CopperPilot/laptop/reference/README.md

# Reference

What the CopperPilot agents were given: the prompt in [prompt.md](prompt.md) and the photos below.

Reference photos of a commercial product, used here only for comparison. All rights belong to their owners; this project is not affiliated with or endorsed by the product's maker.

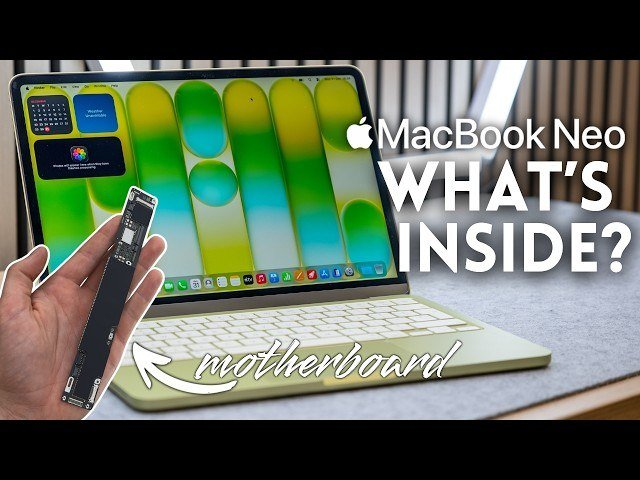
[picture p15: reference/photos/board_in_hand.jpg]
board_in_hand

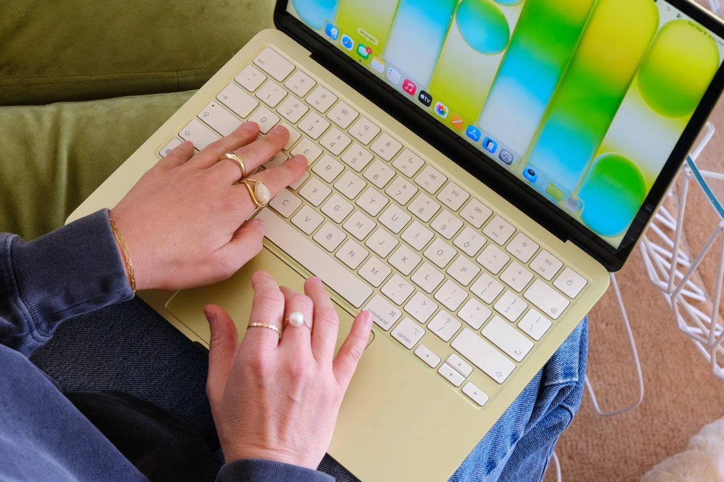
[picture p16: reference/photos/keyboard_top.jpg]
keyboard_top

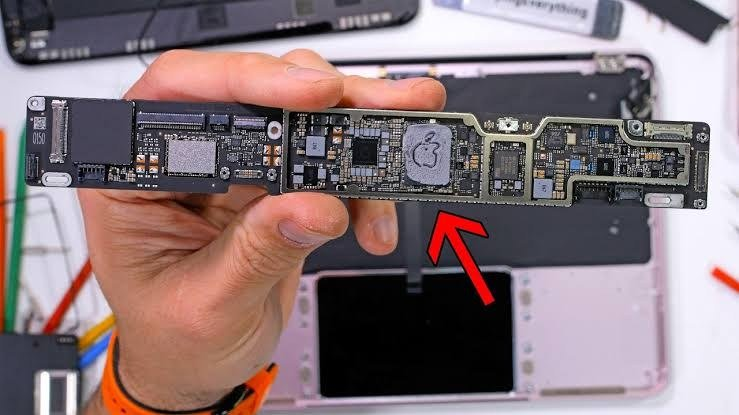
[picture p17: reference/photos/logic_board.jpg]
logic_board

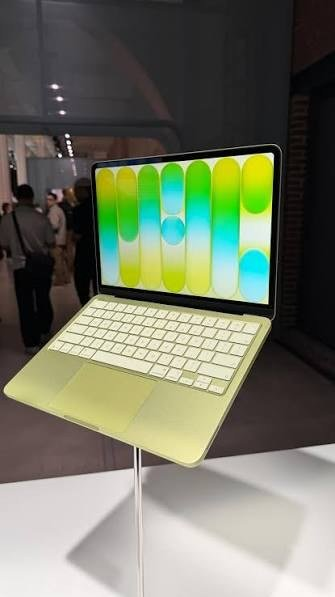
[picture p18: reference/photos/open_side.jpg]
open_side

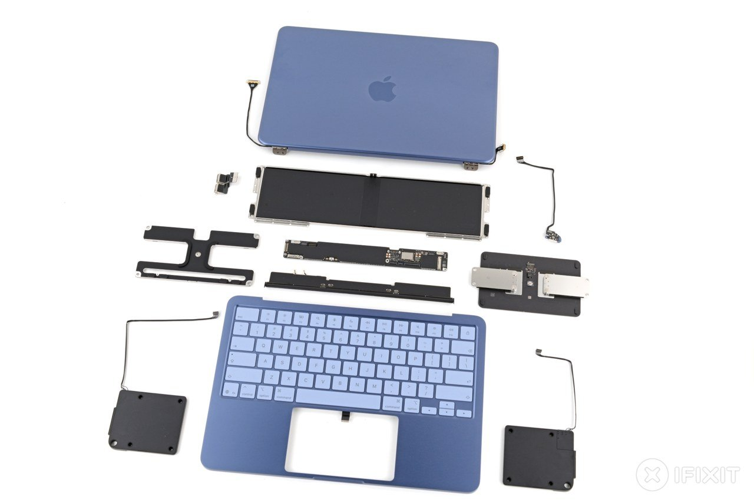
[picture p19: reference/photos/teardown_exploded.jpg]
teardown_exploded

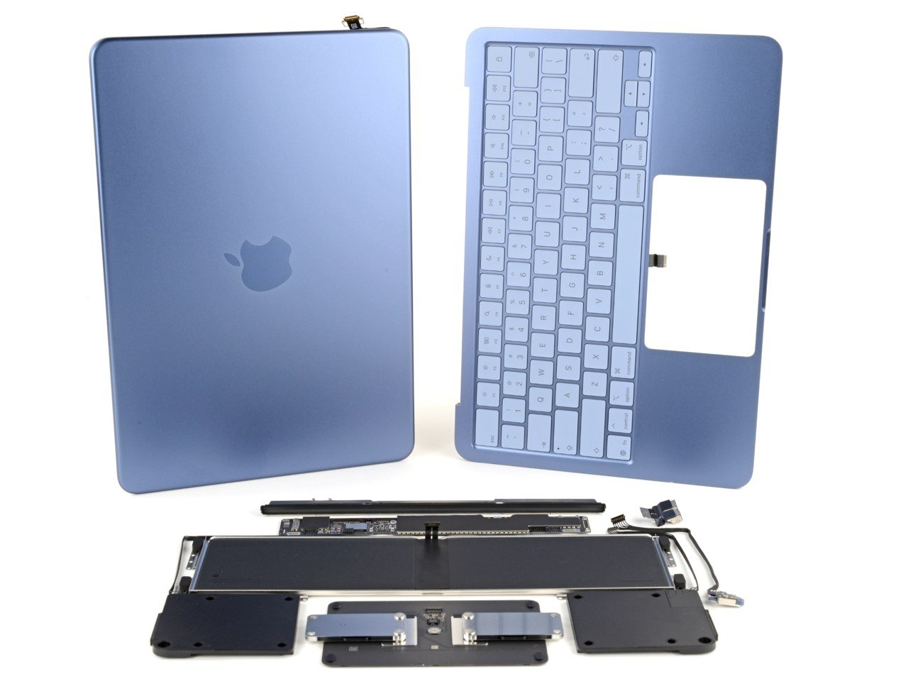
[picture p20: reference/photos/teardown_shells.jpg]
teardown_shells
