CopperPilot/laptop/reviews/judge.md

# Independent judge

A separate agent compares the renders of the finished design with the reference photos, without seeing the design files or the other agents' notes.

**Overall 8/10** · form 8 · features 9 · requirements 9 (pass mark 7).

## Differences from the reference

- Hinge area in the front view shows separate left/right torque hinge barrels and a central bezel cable cover with small gaps between them, whereas the reference uses a single full-width clutch cover.
- Bottom-right arrow keys on the 78-key keyboard use four full-height keys (L, U, D, R) rather than the reference keyboard's half-height up/down inverted-T arrow cluster.
- Top-bezel webcam window is rendered as a distinct rectangular module cutout rather than a flush glass camera hole.

## Requirements

| Id | Verdict | Note |
|---|---|---|
| R1 | met | CNC 6061-T6 aluminum top_deck, continuous bottom_shell (with internal blind pockets and no through-cutouts), and continuous lid_shell (with internal blind magnet pocket and no outer hole) match the 297.5 x 206.4 x 12.7 mm reference dimensions. |
| R2 | met | Main carrier PCB sits in the compact rear strip behind the keyboard and uses the real CM5_module.stl 3D model from rea-hw ref cm5. |
| R3 | met | Both left-edge USB-C ports and the right-edge 3.5mm TRRS jack face straight out through their enclosure openings in render-ports.png, with usb_left implementing the CH224A 20V 45-65W PD sink + AO4407A load switch on J2 and TPS25810RVCR 5V 1.5A DFP controller on J1 (single-sided top assembly over continuous GND planes), connected via 16P FFC and J4/J5 power harnesses to the main-board BQ25798RQMR 2S buck-boost charger and 6A +5V buck rail, and audio_right implementing the PJ-3701-SMT TRRS jack, ICS-40720 MEMS mic, TLV7041DBVR comparators, and TS5A23159DGSR mic mux. |
| R4 | met | Bought 270 x 104 mm 78-key scissor-switch keyboard module with readable legends on every key and 24-pin FPC tail to TCA8418RTWR, plus 120 x 76 mm multi-touch glass trackpad with 8-pin FPC tail, are properly mounted and cabled to the main carrier board. |
| R5 | met | Battery is rearranged as a single bought 2S2P pack (LP4466104-2S2P-9000MAH, 7.4V nominal, 6.0-8.4V, 9,000mAh / 66.6Wh) built from four identical LP4466104 pouch cells contoured around and under the trackpad (>85% floor coverage) with an integrated 2S protection/balance board, NTC, and one 9-pin JST-PH harness to J_BAT on the main board. |
| R6 | met | CM5 flashing and boot recovery use internal top-side pogo test pads TP1..TP6 and top-side nRPIBOOT switch SW1 with TPS2117DRLR + back-to-back AO4407A power muxing, keeping bottom_shell completely continuous with no service slot or through-cutouts. |
| R7 | met | Dual bought torque hinges articulate the lid 110 degrees open, lid_magnet sits in a blind internal pocket with an unperforated outer lid_shell, and display, backlight, and webcam cables route cleanly through the hinge barrel and internal bezel channels without looping outside the lid edge. |

## Features

| Id | Verdict | Note |
|---|---|---|
| F_DISPLAY | ok | 13-inch IPS display panel fills the thin lid bezel cleanly with proportions matching the reference laptop. |
| F_WEBCAM | ok | Centered top-bezel webcam window sits cleanly above the display in the front view and aligns with the internal camera module. |
| F_KEYBOARD | ok | 78-key scissor-switch keyboard sits recessed in the top deck well with readable printed legends on all keys. |
| F_TRACKPAD | ok | Large centered glass trackpad surface and front-edge thumb notch match the reference palmrest layout. |
| F_USBC_2 | ok | Rear-left USB-C port is centered in the left side opening with its oval mouth and tongue facing straight out. |
| F_USBC_1 | ok | Front-left USB-C PD charging port is centered in the left side opening with its oval mouth and tongue facing straight out. |
| F_AUDIO | ok | Right-edge 3.5mm TRRS headphone jack is centered in the right side opening with its circular bore facing straight out. |
| F_HALL | ok | Hall sensor U_HALL and lid_magnet align in the actuator view, with the magnet housed in a blind internal pocket leaving the outer lid skin continuous. |
