CopperPilot/laptop/docs/images/thumbnail.gif

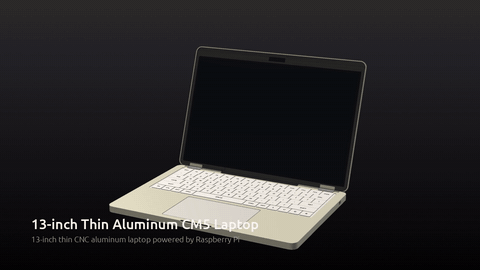
docs/images/thumbnail.gif
