CopperPilot/laptop/fab/thin-laptop-cm5-bom.csv

Comment | Designator | Footprint | LCSC Part #
10uF | C1,C3,C9,C19,C24,C35,C41,C43,C45,C47,C49,C65,C66,C67,C69,C71,C72,C73,C74,C75,C99 | C_0805_2012Metric | C440198
100nF | C2,C4,C10,C12,C16,C18,C23,C25,C36,C38,C42,C44,C46,C48,C50,C54,C59,C68,C76,C77,C80,C83,C87,C90,C91,C93,C95,C96,C97,C101 | C_0402_1005Metric | C307331
220nF | C21,C100 | C_0402_1005Metric | C16772
1uF | C11,C31,C32,C79 | C_0402_1005Metric | C52923
47nF | C7,C13 | C_0402_1005Metric | C880605
22uF | C5,C6,C14,C15,C55,C56,C64,C81,C82,C84,C85,C86 | C_0805_2012Metric | C45783
22pF | C17,C78 | C_0402_1005Metric | C1555
10uF | C20 | C_0603_1608Metric | C96446
1uF | C22 | C_0603_1608Metric | C23829972
1uF | C26,C27,C28,C37,C39,C40,C57,C58 | C_0603_1608Metric | C15849
100uF | C29,C30,C52,C53 | C_0805_2012Metric | C141660
2.2uF | C33,C34 | C_0402_1005Metric | C159814
4.7uF | C8,C51,C88 | C_0603_1608Metric | C19666
1nF | C60,C61,C62,C63 | C_0402_1005Metric | C1523
1nF | C70 | C_0402_1005Metric | C14442
470pF | C89 | C_0402_1005Metric | C1537
10nF | C92,C98 | C_0402_1005Metric | C15195
B16WS | D1 | SOD-323_L1.8-W1.3-LS2.5-RD | C364278
PESD5V0S1BA | D10,D11,D12,D13 | SOD-323_L1.7-W1.3-LS2.5-BI | C2827694
PESD3V3U1UA,115 | D5,D14,D20,D21,D22,D23,D31,D32,D40 | SOD-323_L1.7-W1.3-LS2.5-RD | C403915
BZT52C12 | D15 | SOD-123_L2.7-W1.6-LS3.7-RD | C173429
1N4148WS | D16,D37,D39 | SOD-323_L1.8-W1.3-LS2.5-RD | C2128
PSD05-LF-T7 | D2,D18 | SOD-323_L1.8-W1.3-LS2.5-RD | C139296
PESD5V0S1UA,115 | D4,D6,D9,D19 | SOD-323_L1.8-W1.3-LS2.5-RD | C179414
SMF12A | D24 | SOD-123F_L2.8-W1.8-LS3.7-RD | C123800
PESD3V3L5UY | D25,D26,D27,D28,D29,D30,D33,D34 | SOT-363_L2.0-W1.3-P0.65-LS2.1-BL | C2831531
TSD05CDYFR | D3 | SOD-323_L1.8-W1.3-LS2.5-BI | C20611048
ESTVS3300DRVR | D35 | DFN-6_L2.0-W2.0-P0.65-BL-EP1.6 | C42400190
PESD36VS1UJX | D36 | SOD-323F_L1.7-W1.3-LS2.5-RD | C5205187
BZT52C5V1S | D38 | SOD-323_L1.8-W1.3-LS2.5-RD | C173436
ESTVS2200DRVR | D7 | DFN-6_L2.0-W2.0-P0.65-BL-EP1.6 | C42400188
8A | F1 | F1206 | C136353
1A | F6 | F0603 | C163118
BLM18PG121SN1D | FB1,FB2,FB3,FB4,FB5 | L0603 | C14709
SM06B-SRSS-TB(LF)(SN) | J4 | CONN-SMD_SM06B-SRSS-TB-LF-SN | C160405
SM10B-SRSS-TB(LF)(SN) | J5 | CONN-SMD_10P-P1.00_SM10B-SRSS-TB-LF-SN | C160409
FPC-05F-8PH20 | J_AUDR,J_TP | FPC-SMD_8P-P0.50_FPC-05F-8PH20 | C2856797
S9B-PH-SM4-TB(LF)(SN) | J_BAT | CONN-SMD_9P-P2.50_S9B-PH-SM4-TB | C495694
S2B-PH-SM4-TB(LF)(SN) | J_BL,J_SPKL,J_SPKR | CONN-SMD_P2.00_S2B-PH-SM4-TB-LF-SN | C295747
FH12-22S-0.5SH(55) | J_CSI,J_DSI | FPC-SMD_22P-P0.50_FH12-22S-0.5SH-55 | C597981
05A20L24P | J_KB | FPC-SMD_24P-P0.50_05A20L24P | C5362158
05B20U16P | J_USBL | FPC-SMD_16P-P0.50_05B20U16P | C18164516
2.2uH | L1,L2,L5 | IND-SMD_L7.0-W6.6 | C167218
10uH | L3 | IND-SMD_L4.0-W4.0_LQH44PN2R2MP0L | C135263
2.2uH | L4 | IND-SMD_L4.5-W4.1_TMPC0412HP | C357134
AO4407A | Q1,Q2 | SOP-8_L5.0-W4.0-P1.27-LS6.0-BL | C2841482
SQ2318AES-T1_BE3 | Q3,Q4 | SOT-23-3_L2.9-W1.3-P1.90-LS2.4-BR | C3280170
BSS138 | Q5,Q6,Q_CAM,Q_I2C1,Q_I2C2,Q_TP1,Q_TP2 | SOT-23-3_L2.9-W1.6-P1.90-LS2.8-BR | C52895
AO3401A | Q_BL | SOT-23_L2.9-W1.3-P1.90-LS2.4-BR | C15127
2N7002 | Q_BL_EN,Q_DBG | SOT-23-3_L2.9-W1.3-P1.90-LS2.4-BR | C8545
10k | R1,R2,R3,R4,R6,R13,R14,R15,R16,R17,R18,R19,R20,R21,R26,R37,R48,R54,R55,R56,R58,R59,R71,R75,R76,R77,R78,R79,R91,R93,R95 | R_0402_1005Metric | C25744
2.2k | R9,R10,R82,R83 | R_0402_1005Metric | C25879
8.2k | R22 | R_0603_1608Metric | C25981
5.23k | R23 | R_0402_1005Metric | C11631
137k | R27 | R_0402_1005Metric | C32298
24k | R28,R65 | R_0402_1005Metric | C25769
78.7k | R29 | R_0402_1005Metric | C2998104
100k | R8,R30,R35,R45,R46,R63,R66,R67,R80,R96,R97 | R_0402_1005Metric | C25741
3.6k | R31 | R_0402_1005Metric | C25891
1.5R | R32 | R_0603_1608Metric | C22769
82k | R33 | R_0402_1005Metric | C4142
5.1k | R34 | R_0402_1005Metric | C25905
22R | R36,R53 | R_0402_1005Metric | C25092
30.1k | R42 | R_0402_1005Metric | C29402
45.3k | R47 | R_0402_1005Metric | C26980
4.7R | R49 | R_0402_1005Metric | C25121
100R | R50,R69,R87 | R_0402_1005Metric | C25076
47k | R51,R52,R68,R90 | R_0402_1005Metric | C25792
2.2R | R60 | R_0603_1608Metric | C22939
10R | R61,R62,R74 | R_0402_1005Metric | C25077
133k | R64 | R_0402_1005Metric | C25753
30k | R7 | R_0402_1005Metric | C25776
150k | R72,R73 | R_0402_1005Metric | C25755
1M | R81 | R_0402_1005Metric | C26083
1k | R84 | R_0402_1005Metric | C11702
80.6k | R88 | R_0402_1005Metric | C25921
4.7k | R89 | R_0402_1005Metric | C25900
22k | R94 | R_0402_1005Metric | C25768
PTS526SM15SMTR2LFS | SW1 | SW-SMD_4P-L5.2-W5.2-P3.70-LS6.4 | C2689538
ComputeModule5-CM5 | U1 | Raspberry-Pi-5-Compute-Module | C597931
TLV62569DBVR | U_3V3 | SOT-23-5_L3.0-W1.7-P0.95-LS2.8-BR | C141836
PAM8406DR | U_AMP | SOIC-16_L9.9-W3.9-P1.27-LS6.0-BL | C86270
TPS61165DBVR | U_BL | SOT-23-6_L2.9-W1.6-P0.95-LS2.8-BR | C58756
TPS56628DDAR | U_BUCK,U_BUCK2 | SOIC-8_L4.9-W3.9-P1.27-LS6.0-BL-EP | C485522
BQ25798RQMR | U_CHG | QFN-29_L4.0-W4.0-P0.40-TL-BQ25792RQMR | C2876593
ES8388 | U_CODEC | QFN-28_L4.0-W4.0-P0.45-BL-EP | C365736
TPS2117DRLR | U_DBG | SOT-583-8_L2.1-W1.2-P0.50-LS1.6-BL | C22399676
USBLC6-2SC6 | U_ESD,U_ESD1,U_ESD2 | SOT-23-6_L2.9-W1.6-P0.95-LS2.8-BL | C2687116
DRV5032FADBZR | U_HALL | SOT-23-3_L2.9-W1.3-P0.95-LS2.4-BR | C140921
TCA8418RTWR | U_KB | WQFN-24_L4.0-W4.0-P0.50-TL-EP2.5 | C138713
HT7530S | U_RTC | SOT-23-3_L3.0-W1.7-P0.95-LS2.9-BR | C347214
TPS3700DDCR | U_UVLO | SOT-23-6_L2.9-W1.6-P0.95-LS2.8-BL | C33002
SY6280AAC | U_VBUS | SOT-23-5_L3.0-W1.7-P0.95-LS2.8-BL | C55136
