CopperPilot/laptop/fab/usb_left/thin-laptop-cm5-usb_left-bom.csv

Comment | Designator | Footprint | LCSC Part #
150uF | C1 | CAP-SMD_L6.0-W3.2 | C600588
100nF | C2,C4,C8,C9,C10,C11,C13,C16 | C_0402_1005Metric | C307331
1uF | C5,C6,C7,C12,C14 | C_0603_1608Metric | C15849
10uF | C3,C15,C19 | C_0805_2012Metric | C440198
10nF | C17 | C_0402_1005Metric | C15195
1N4148WS | D3,D10,D11 | SOD-323_L1.8-W1.3-LS2.5-RD | C2128
TSD05CDYFR | D4,D5 | SOD-323_L1.8-W1.3-LS2.5-BI | C20611048
ESTVS2200DRVR | D6,D7 | DFN-6_L2.0-W2.0-P0.65-BL-EP1.6 | C42400188
BZT52C24 | D8 | SOD-123_L2.7-W1.6-LS3.7-RD | C173422
BZT52C12 | D9 | SOD-123_L2.7-W1.6-LS3.7-RD | C173429
TYPE-C-31-M-12 | J1,J2 | USB-C_SMD-TYPE-C-31-M-12_1 | C165948
FPC-05F-16PH20 | J3 | FPC-SMD_16P-P0.50_FPC-05F-16PH20 | C2856801
SM06B-SRSS-TB(LF)(SN) | J4 | CONN-SMD_SM06B-SRSS-TB-LF-SN | C160405
SM10B-SRSS-TB(LF)(SN) | J5 | CONN-SMD_10P-P1.00_SM10B-SRSS-TB-LF-SN | C160409
AO4407A | Q1,Q2 | SOP-8_L5.0-W4.0-P1.27-LS6.0-BL | C2841482
2N7002 | Q3,Q4,Q5,Q6,Q7 | SOT-23-3_L2.9-W1.3-P1.90-LS2.4-BR | C8545
100k | R1,R8,R23,R24 | R_0402_1005Metric | C25741
120k | R11 | R_0402_1005Metric | C25750
470R | R12 | R_0603_1608Metric | C23179
10k | R2,R13,R14 | R_0603_1608Metric | C25804
47k | R15 | R_0402_1005Metric | C25792
1k | R16,R17,R18,R19,R20,R21,R22 | R_0402_1005Metric | C11702
0R | R3 | R_0603_1608Metric | C21189
10k | R5,R6 | R_0402_1005Metric | C25744
CH224A | U1 | ESSOP-10_L4.9-W3.9-P1.0-LS6.0-TL-EP | C42459160
TPS25810RVCR | U2 | WQFN-20_L4.0-W3.0-P0.50-BL-EP | C473913
TPD6S300RUKR | U3,U5 | WQFN-20_L3.0-W3.0-P0.40-BL-EP1.7 | C2649810
XC6216B332MR-G | U4 | SOT-23-5_L3.0-W1.6-P0.95-LS2.8-BR | C2891269
XC6206P332MR-G | U6 | SOT-23-3_L2.9-W1.6-P1.90-LS2.8-BR | C5446
