CopperPilot/laptop/case/out/bottom_shell.stl

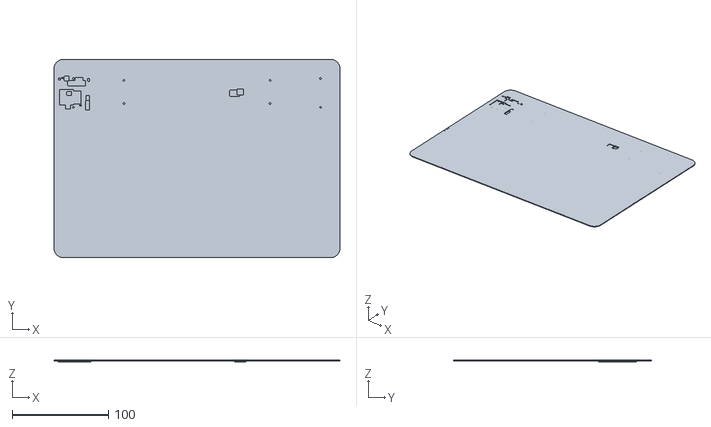
[picture p22: CAD file, 2026-11-02]
case/out/bottom_shell.stl
297.5 x 206.4 x 1.92
