CopperPilot/laptop/fab/audio_right/thin-laptop-cm5-audio_right.step

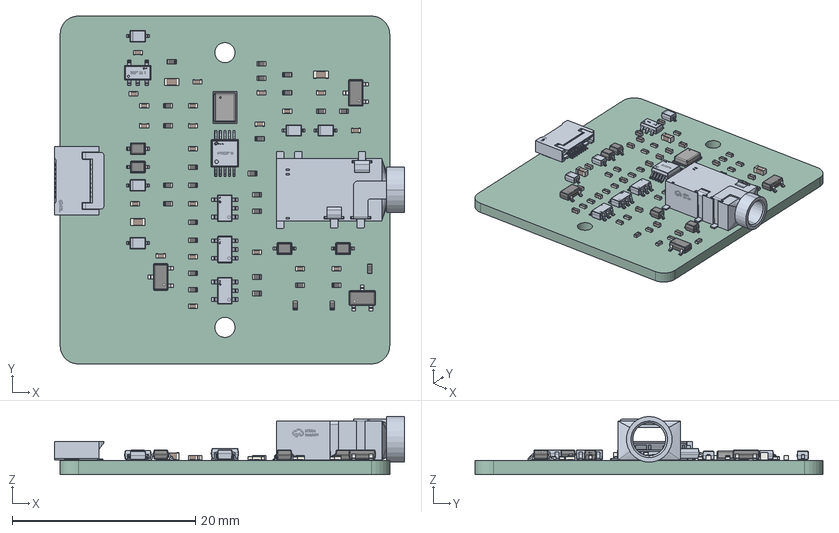
[picture p23: CAD file, 2026-11-06]
fab/audio_right/thin-laptop-cm5-audio_right.step
38.3 x 38.0 x 6.35 mm
R_0402_1005Metric x 28
C_0402_1005Metric x 21
SOT-23-3L_L2.9-W1.6-H1.1-LS2.8-P0.95 x 3
InvenSense_ICS-43434-6_3.5x2.65mm
C_0603_1608Metric x 3
SOD-323_L1.7-W1.3-LS2.5-BI x 4
thin-laptop-cm5-audio_right_PCB
