CopperPilot/laptop/fab/mech/lid_shell.step

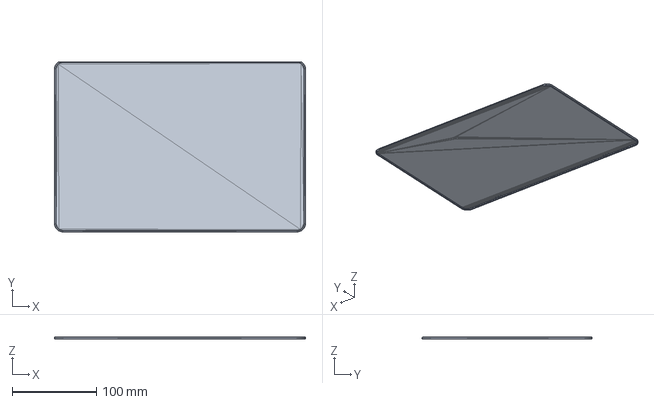
[picture p24: CAD file, 2026-11-06]
fab/mech/lid_shell.step
297.5 x 201.2 x 2.84 mm
