CopperPilot/laptop/fab/thin-laptop-cm5.step

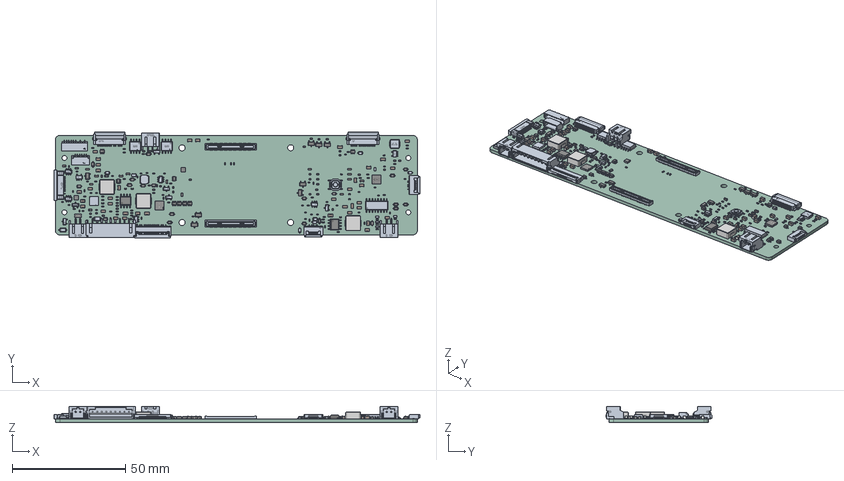
[picture p25: CAD file, 2026-11-06]
fab/thin-laptop-cm5.step
161.7 x 46.9 x 7.20 mm
C_0805_2012Metric x 37
R_0402_1005Metric x 84
C_0402_1005Metric x 50
零件46 x 8
零件2 x 5
SOD-323_L1.7-W1.3-LS2.5-BI x 10
C_0603_1608Metric x 13
10164227-1001A1RLF x 2
R_0603_1608Metric x 3
SOD-323_L1.8-W1.3-LS2.5-BI x 5
IND-SMD_L7.0-W6.6-H3.0 x 3
F1206_L3.2-W1.7-H0.6
SOT-23-3L_L2.9-W1.6-H1.1-LS2.8-P0.95 x 8
QFN-28_L4.0-W4.0-H0.8-P0.45
DFN-6_L2.0-W2.0-P0.65-BL-EP1.6 x 2
WQFN-24_L4.0-W4.0-H0.8-P0.50
零件39 x 2
F0603_L1.7-W0.9-H0.7
thin-laptop-cm5_PCB
