CopperPilot/laptop/fab/usb_left/thin-laptop-cm5-usb_left.step

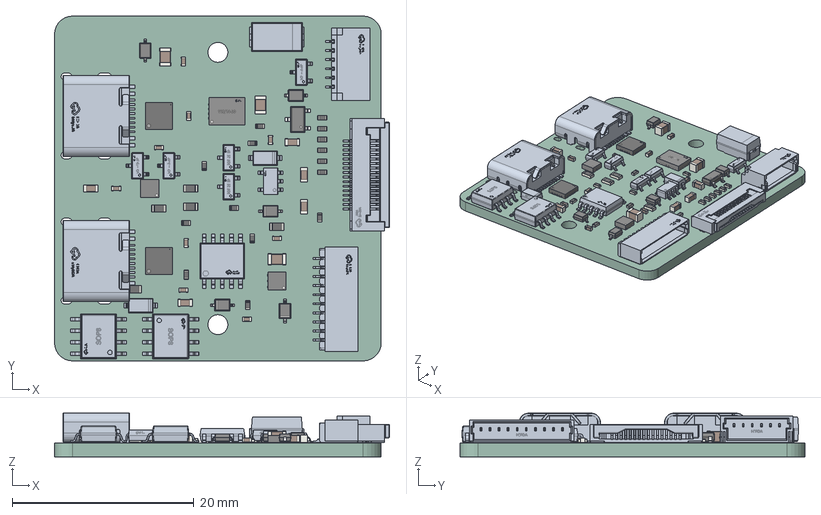
[picture p26: CAD file, 2026-11-06]
fab/usb_left/thin-laptop-cm5-usb_left.step
36.9 x 38.0 x 4.82 mm
SOD-323_L1.8-W1.3-LS2.5-BI x 2
C_0402_1005Metric x 9
R_0402_1005Metric x 15
SOT-23-3L_L2.9-W1.6-H1.1-LS2.8-P0.95
零件2 x 3
R_0603_1608Metric x 5
C_0603_1608Metric x 5
C_0805_2012Metric x 3
WQFN-20_L3.0-W3.0-H0.8-P0.40-TL-EP1.7 x 2
DFN-6_L2.0-W2.0-P0.65-BL-EP1.6 x 2
WQFN-20_L4.0-W3.0-H0.8-P0.50
thin-laptop-cm5-usb_left_PCB
