CopperPilot/laptop/case/out/lid_magnet.stl

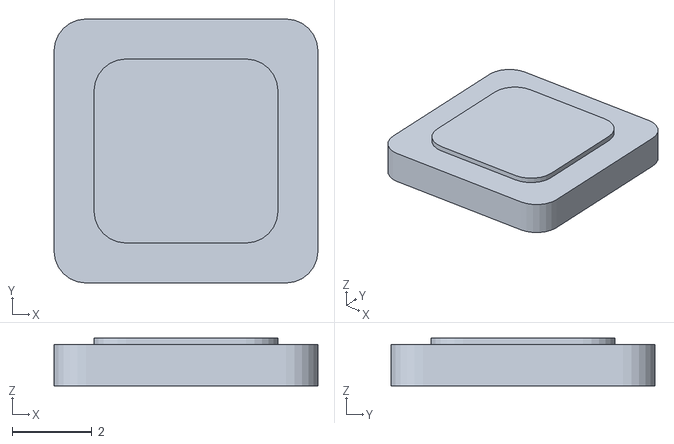
[picture p27: CAD file, 2026-11-02]
case/out/lid_magnet.stl
6.60 x 6.60 x 1.19
