CopperPilot/laptop/case/out/top_deck.stl

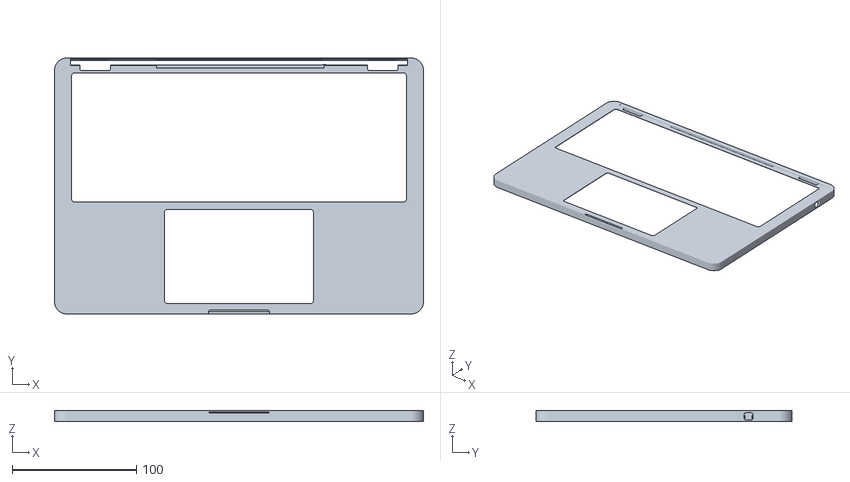
[picture p28: CAD file, 2026-11-02]
case/out/top_deck.stl
297.5 x 206.4 x 8.48
