CopperPilot/laptop/case/out/display_bezel.stl

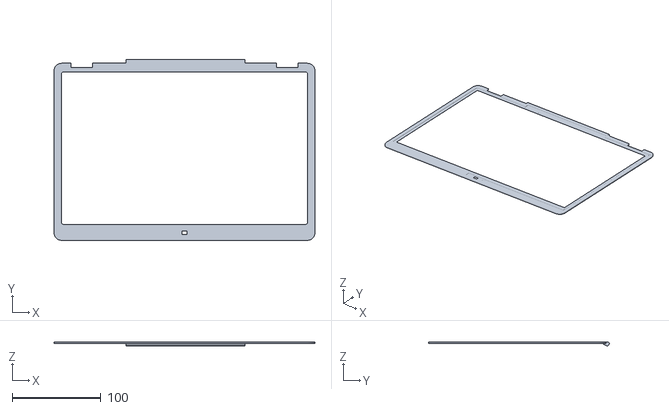
[picture p29: CAD file, 2026-11-02]
case/out/display_bezel.stl
294.5 x 203.8 x 4.18
