CopperPilot/laptop/case/purchased/cm5_module.stl

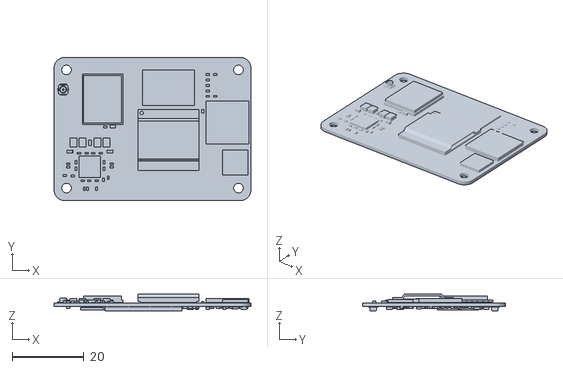
[picture p30: CAD file, 2026-11-06]
case/purchased/cm5_module.stl
55.0 x 40.0 x 4.62
