CopperPilot/laptop/case/purchased/hinge_left.stl

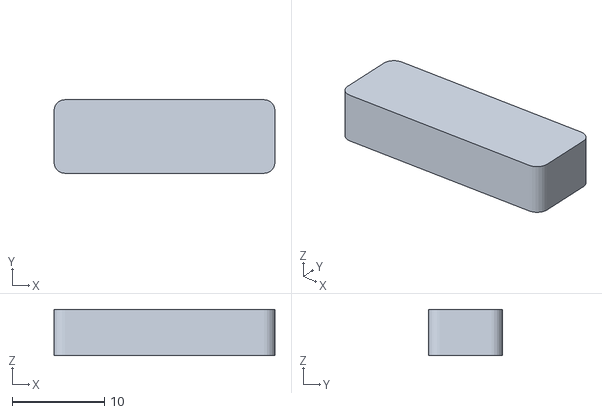
[picture p31: CAD file, 2026-11-02]
case/purchased/hinge_left.stl
24.0 x 8.00 x 5.00
