CopperPilot/laptop/case/purchased/speaker_left.stl

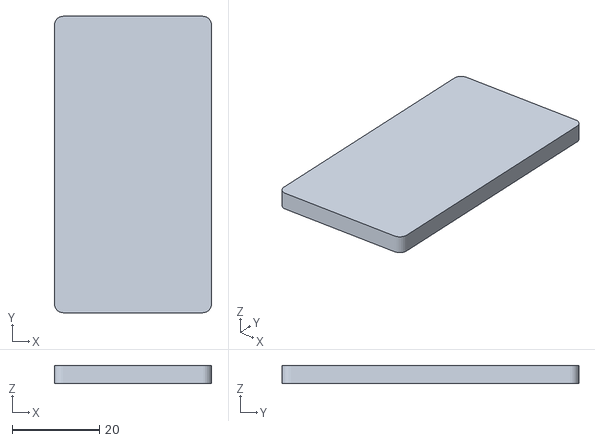
[picture p32: CAD file, 2026-11-02]
case/purchased/speaker_left.stl
36.0 x 68.0 x 4.20
