CopperPilot/laptop/case/purchased/display_panel.stl

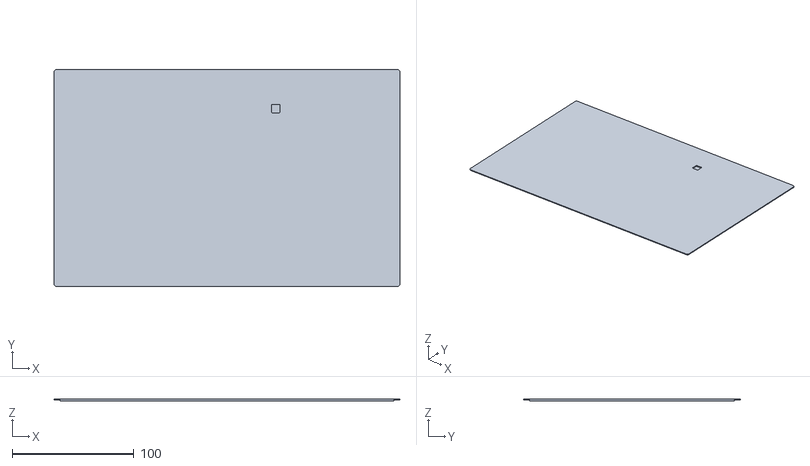
[picture p33: CAD file, 2026-11-02]
case/purchased/display_panel.stl
284.0 x 178.0 x 1.50
