CopperPilot/laptop/(list of files, cad)

Other CAD files:
fab/mech/lid_magnet.step
fab/mech/top_deck.step
fab/mech/bottom_shell.step
case/out/lid_shell.stl
case/purchased/hinge_right.stl
case/purchased/battery_pack.stl
case/purchased/keyboard_module.stl
case/purchased/keyboard_module_legends.stl
case/purchased/speaker_right.stl
case/purchased/trackpad_module.stl
case/purchased/webcam_module.stl
fab/mech/lid_shell.stl
