CopperPilot/laptop/fab/thin-laptop-cm5-schematic.pdf

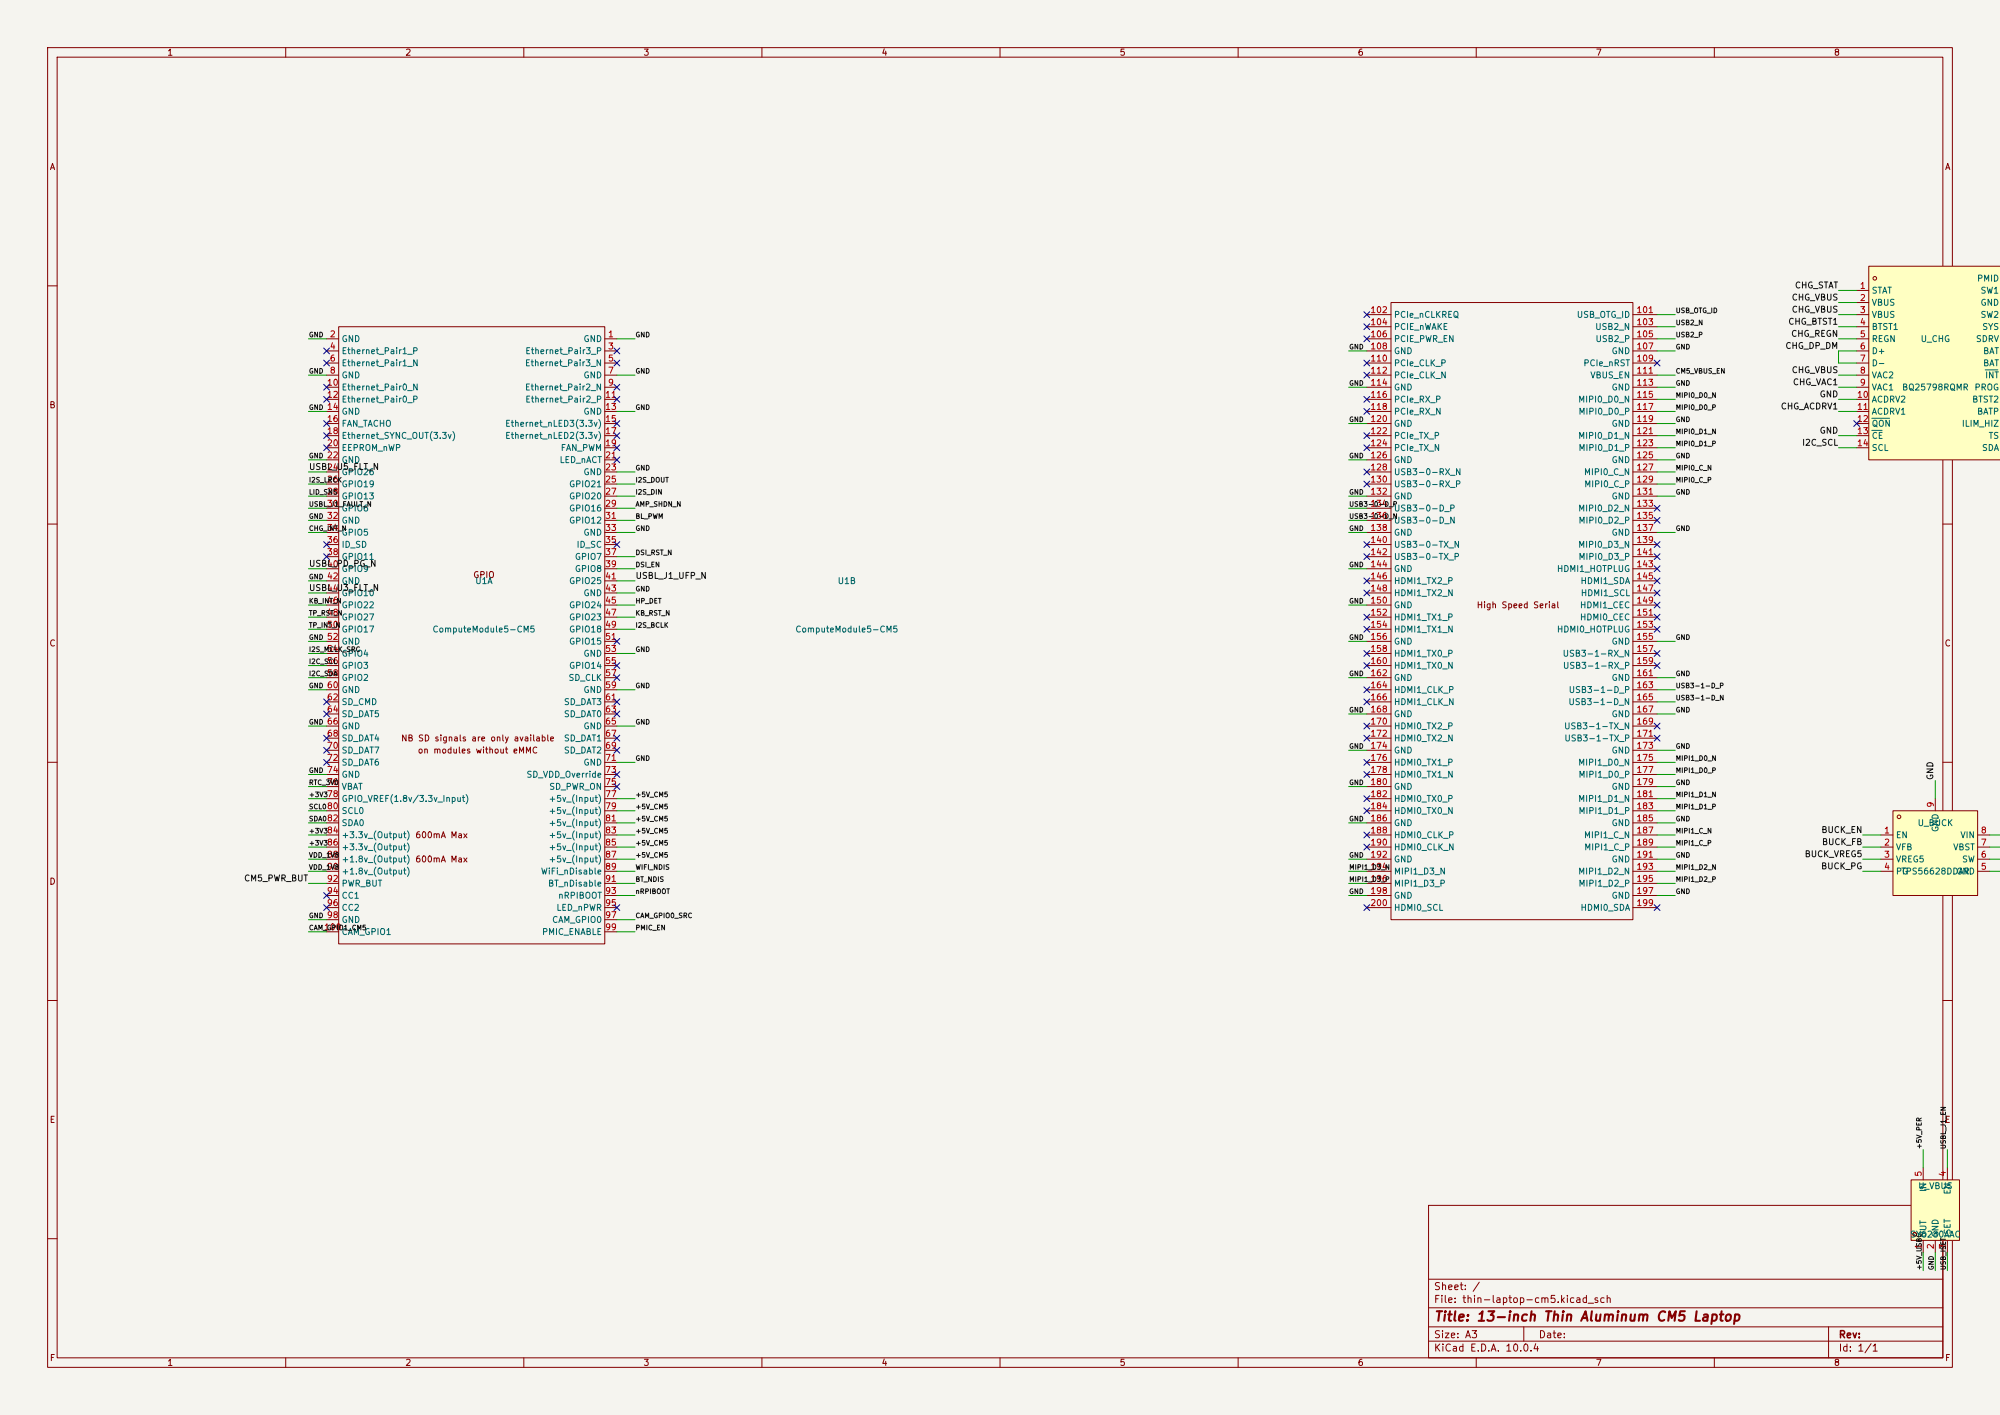
[picture p34: page 1]

600mA Max 600mA Max NB SD signals are only available on modules without eMMC

Sheet: /
File: thin-laptop-cm5.kicad_sch
Title: 13-inch Thin Aluminum CM5 Laptop

Size: A3 | Rev:
KiCad E.D.A. 10.0.4 | Id: 1/1
