CopperPilot/laptop/fab/audio_right/thin-laptop-cm5-audio_right-schematic.pdf

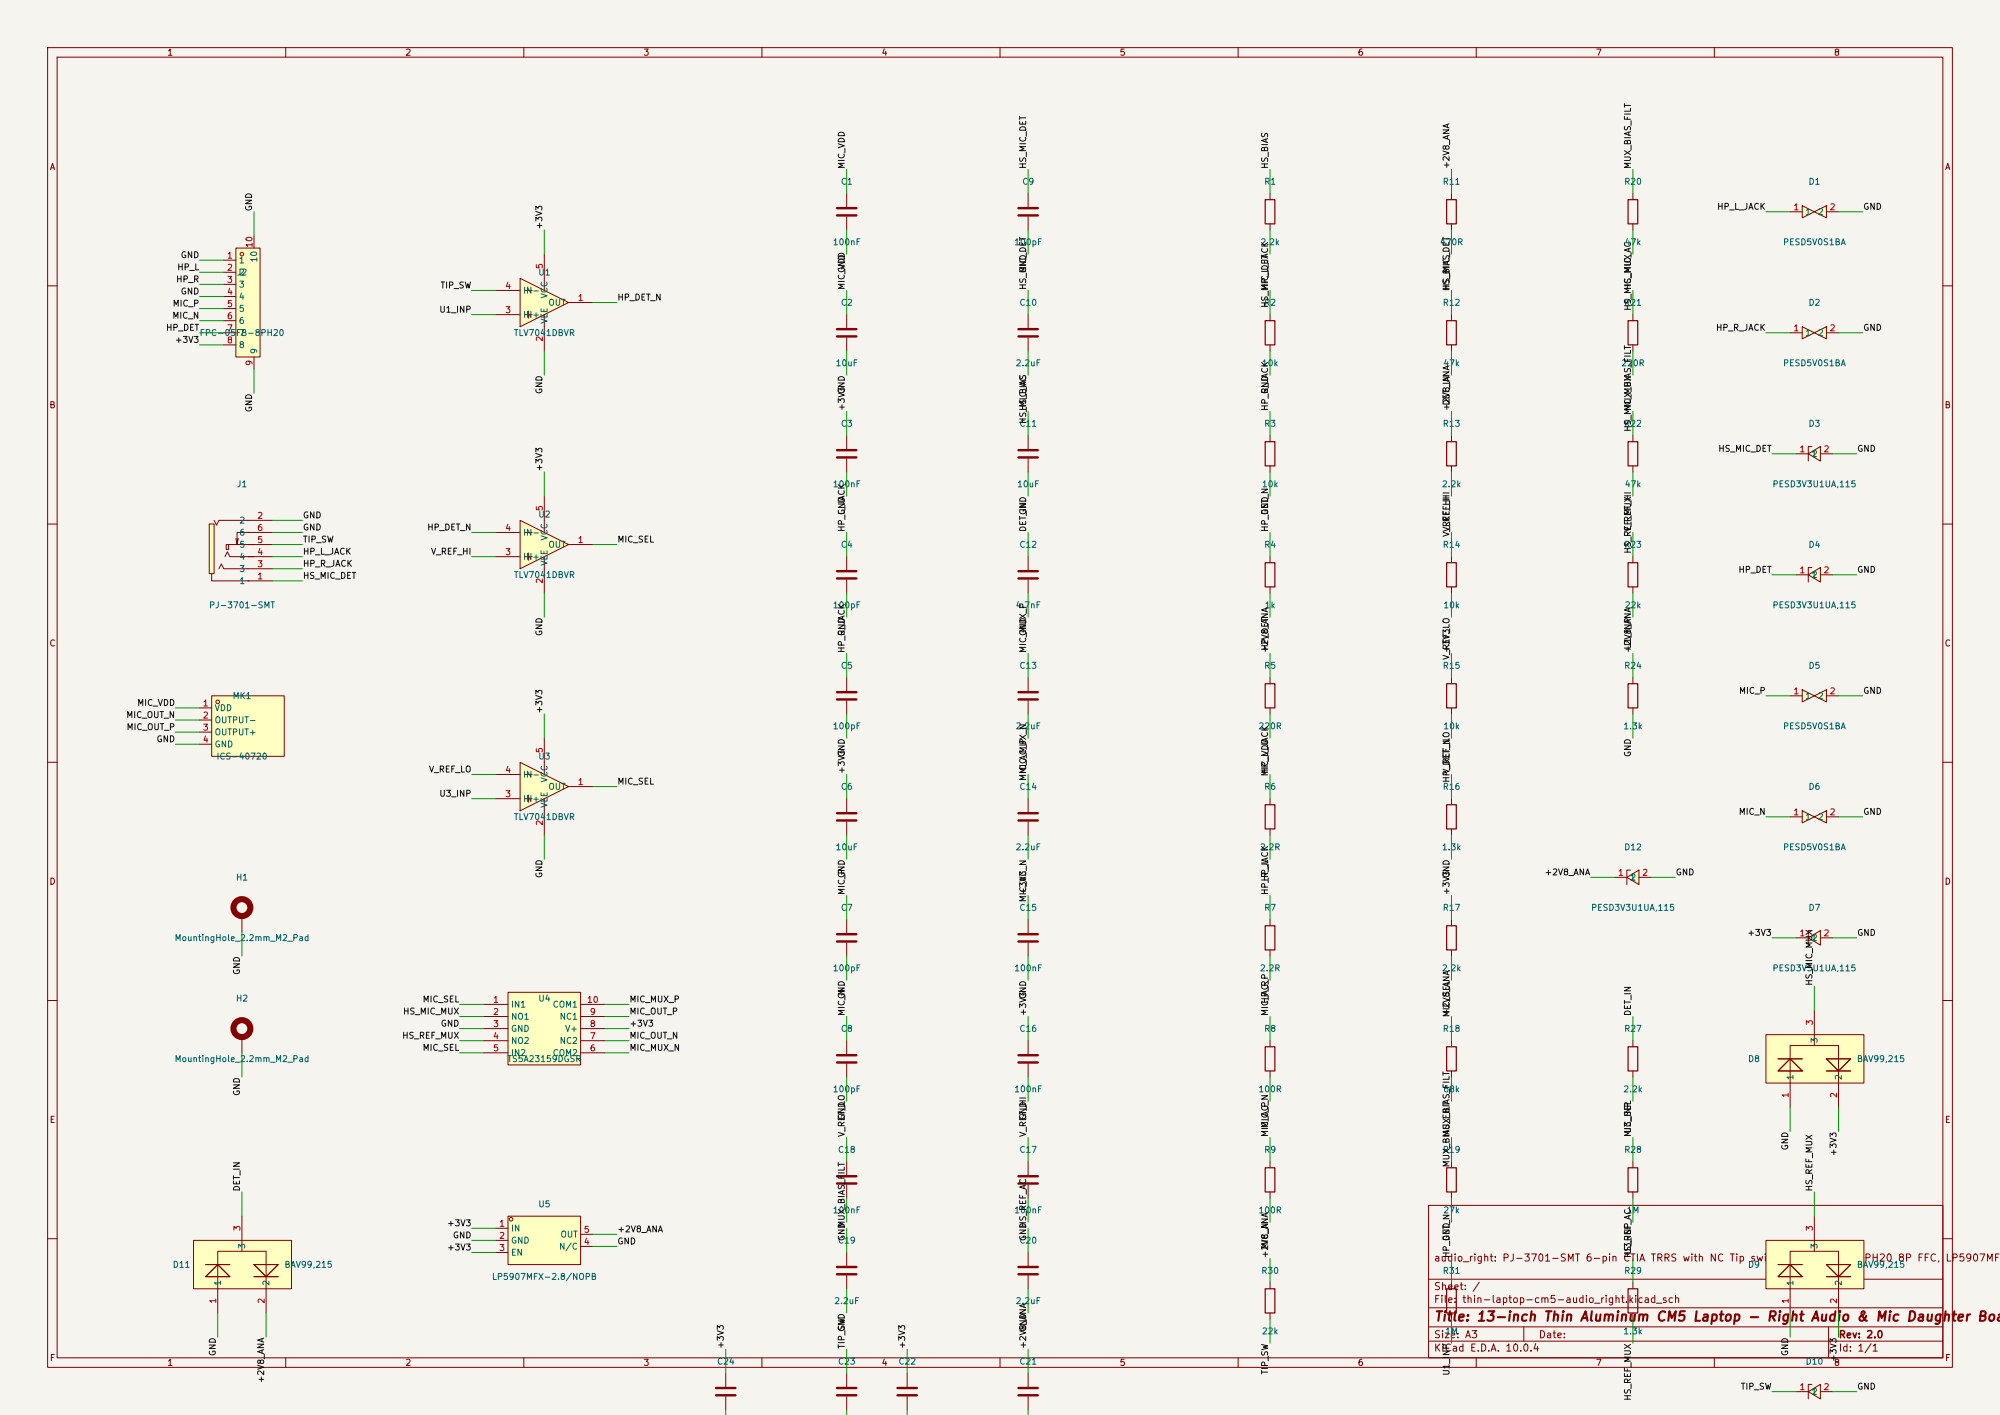
[picture p35: page 1]

Sheet: /
Title: 13-inch Thin Aluminum CM5 Laptop - Right Audio & Mic Daughter Board

1M Size: A3 | 1.3k | | Rev: 2.0
KiCad E.D.A. 10.0.4 | | Id: 1/1
