CopperPilot/laptop/fab/usb_left/thin-laptop-cm5-usb_left-schematic.pdf

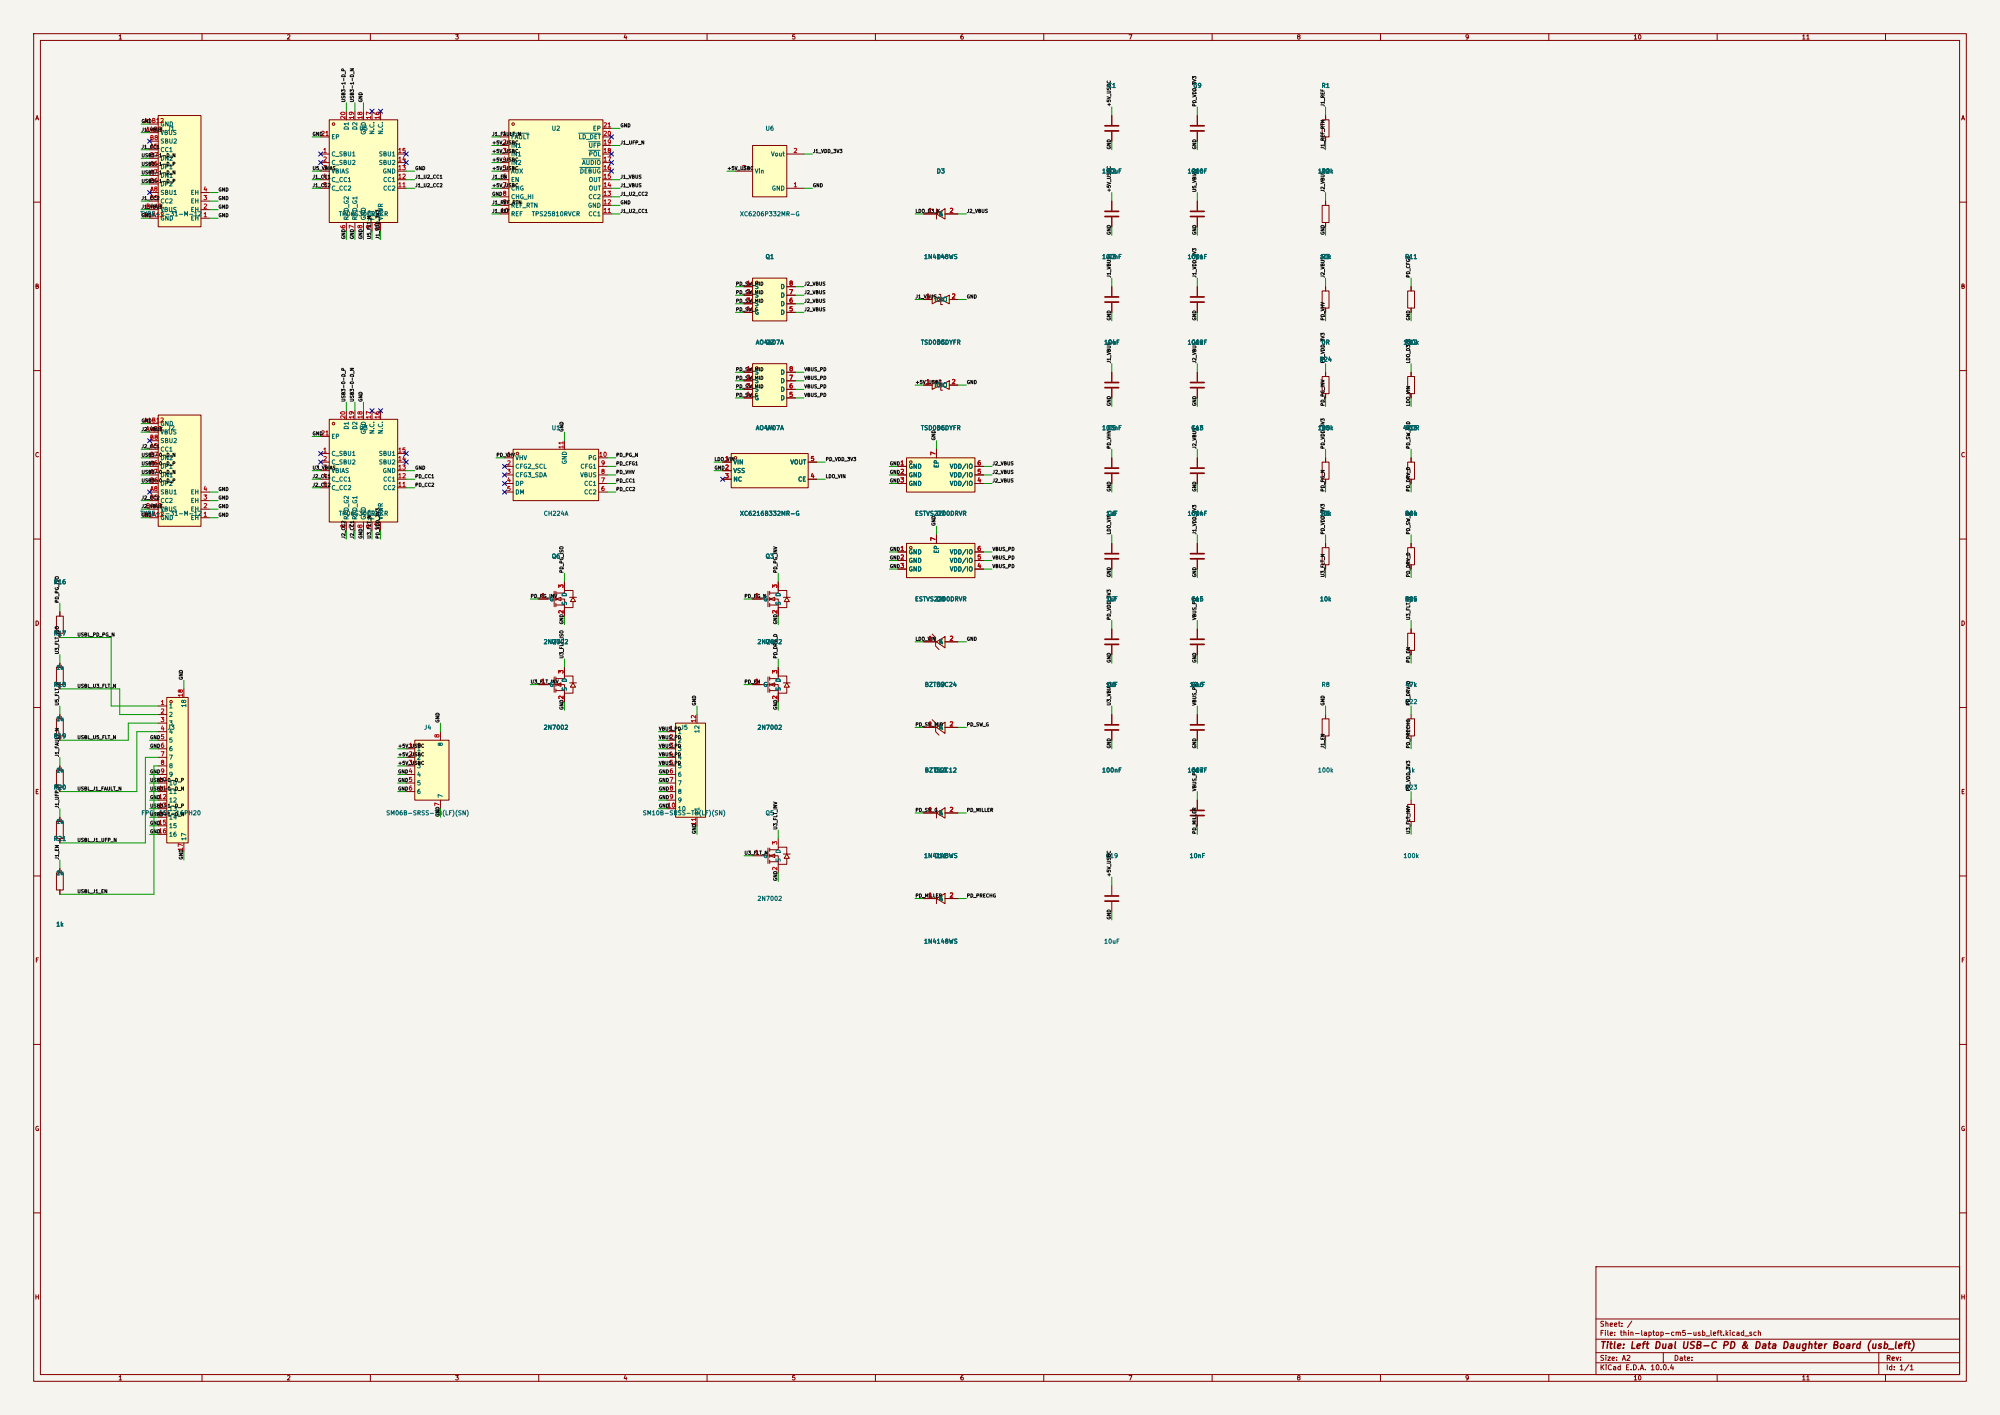
[picture p36: page 1]

SM06B-SRSS-TB(LF)(SN)

Sheet: /
File: thin-laptop-cm5-usb_left.kicad_sch
Title: Left Dual USB-C PD & Data Daughter Board (usb_left)

Size: A2 | Rev:
KiCad E.D.A. 10.0.4 | Id: 1/1
