CopperPilot/laptop/hardware/thin-laptop-cm5.kicad_pcb

## KiCad design hardware/thin-laptop-cm5.kicad_pcb (2026-11-06)

Schematic: thin-laptop-cm5.kicad_sch, 13-inch Thin Aluminum CM5 Laptop

Parts:
C1, C3, C9, C19, C24, C35, C41, C43, C45, C47, C49, C65, C66, C67, C69, C71, C72, C73, C74, C75, C99: 10uF; C_0805_2012Metric; LCSC C440198
C2, C4, C10, C12, C16, C18, C23, C25, C36, C38, C42, C44, C46, C48, C50, C54, C59, C68, C76, C77, C80, C83, C87, C90, C91, C93, C96, C101: 100nF; C_0402_1005Metric; LCSC C307331
C5, C6, C14, C15, C55, C56, C64, C81, C82, C84, C85, C86: 22uF; C_0805_2012Metric; LCSC C45783
C7, C13: 47nF; C_0402_1005Metric; LCSC C880605
C8, C51, C88: 4.7uF; C_0603_1608Metric; LCSC C19666
C11, C31, C32, C79: 1uF; C_0402_1005Metric; LCSC C52923
C17, C78: 22pF; C_0402_1005Metric; LCSC C1555
C20: 10uF; C_0603_1608Metric; LCSC C96446
C21: 220nF; C_0402_1005Metric; LCSC C16772
C22: 1uF; C_0603_1608Metric; LCSC C23829972
C26, C27, C28, C37, C39, C40, C57, C58: 1uF; C_0603_1608Metric; LCSC C15849
C29, C30, C52, C53: 100uF; C_0805_2012Metric; LCSC C141660
C33, C34: 2.2uF; C_0402_1005Metric; LCSC C159814
C60, C61, C62, C63: 1nF; C_0402_1005Metric; LCSC C1523
C70: 1nF; C_0402_1005Metric; LCSC C14442
C89: 470pF; C_0402_1005Metric; LCSC C1537
C92: 10nF; C_0402_1005Metric; LCSC C15195
C95, C97: 100nF; C_0402_1005Metric; MPN CC0402KRX7R9BB104; LCSC C307331
C98: 10nF; C_0402_1005Metric; MPN CL05B103KB5NNNC; LCSC C15195
C100: 220nF; C_0402_1005Metric; MPN CL05B224KO5NNNC; LCSC C16772
D1: B16WS; SOD-323_L1.8-W1.3-LS2.5-RD; LCSC C364278
D2, D18: PSD05-LF-T7; SOD-323_L1.8-W1.3-LS2.5-RD; LCSC C139296
D3: TSD05CDYFR; SOD-323_L1.8-W1.3-LS2.5-BI; LCSC C20611048
D4, D6, D9, D19: PESD5V0S1UA,115; SOD-323_L1.8-W1.3-LS2.5-RD; LCSC C179414
D5, D14: PESD3V3U1UA,115; SOD-323_L1.7-W1.3-LS2.5-RD; LCSC C403915
D7: ESTVS2200DRVR; DFN-6_L2.0-W2.0-P0.65-BL-EP1.6; LCSC C42400188
D10, D11, D12, D13: PESD5V0S1BA; SOD-323_L1.7-W1.3-LS2.5-BI; LCSC C2827694
D15: BZT52C12; SOD-123_L2.7-W1.6-LS3.7-RD; LCSC C173429
D16: 1N4148WS; SOD-323_L1.8-W1.3-LS2.5-RD; LCSC C2128
D20, D21, D22, D23, D31, D32, D40: PESD3V3U1UA,115; SOD-323_L1.7-W1.3-LS2.5-RD; MPN PESD3V3U1UA,115; LCSC C403915
D24: SMF12A; SOD-123F_L2.8-W1.8-LS3.7-RD; MPN SMF12A; LCSC C123800
D25, D26, D27, D28, D29, D30: PESD3V3L5UY; SOT-363_L2.0-W1.3-P0.65-LS2.1-BL; MPN PESD3V3L5UY; LCSC C2831531
D33, D34: PESD3V3L5UY; SOT-363_L2.0-W1.3-P0.65-LS2.1-BL; LCSC C2831531
D35: ESTVS3300DRVR; DFN-6_L2.0-W2.0-P0.65-BL-EP1.6; LCSC C42400190
D36: PESD36VS1UJX; SOD-323F_L1.7-W1.3-LS2.5-RD; LCSC C5205187
D37, D39: 1N4148WS; SOD-323_L1.8-W1.3-LS2.5-RD; MPN 1N4148WS; LCSC C2128
D38: BZT52C5V1S; SOD-323_L1.8-W1.3-LS2.5-RD; LCSC C173436
F1: 8A; F1206; LCSC C136353
F6: 1A; F0603; LCSC C163118
FB1, FB2, FB3, FB4, FB5: BLM18PG121SN1D; L0603; LCSC C14709
H1, H2, H3, H4: MountingHole_2.2mm_M2
J4: SM06B-SRSS-TB(LF)(SN); CONN-SMD_SM06B-SRSS-TB-LF-SN; LCSC C160405
J5: SM10B-SRSS-TB(LF)(SN); CONN-SMD_10P-P1.00_SM10B-SRSS-TB-LF-SN; LCSC C160409
J_AUDR: FPC-05F-8PH20; FPC-SMD_8P-P0.50_FPC-05F-8PH20; LCSC C2856797
J_BAT: S9B-PH-SM4-TB(LF)(SN); CONN-SMD_9P-P2.50_S9B-PH-SM4-TB; MPN S9B-PH-SM4-TB(LF)(SN); LCSC C495694
J_BL: S2B-PH-SM4-TB(LF)(SN); CONN-SMD_P2.00_S2B-PH-SM4-TB-LF-SN; LCSC C295747
J_CSI: FH12-22S-0.5SH(55); FPC-SMD_22P-P0.50_FH12-22S-0.5SH-55; LCSC C597981
J_DSI: FH12-22S-0.5SH(55); FPC-SMD_22P-P0.50_FH12-22S-0.5SH-55; LCSC C597981
J_KB: 05A20L24P; FPC-SMD_24P-P0.50_05A20L24P; LCSC C5362158
J_SPKL: S2B-PH-SM4-TB(LF)(SN); CONN-SMD_P2.00_S2B-PH-SM4-TB-LF-SN; LCSC C295747
J_SPKR: S2B-PH-SM4-TB(LF)(SN); CONN-SMD_P2.00_S2B-PH-SM4-TB-LF-SN; LCSC C295747
J_TP: FPC-05F-8PH20; FPC-SMD_8P-P0.50_FPC-05F-8PH20; LCSC C2856797
J_USBL: 05B20U16P; FPC-SMD_16P-P0.50_05B20U16P; LCSC C18164516
L1, L2, L5: 2.2uH; IND-SMD_L7.0-W6.6; LCSC C167218
L3: 10uH; IND-SMD_L4.0-W4.0_LQH44PN2R2MP0L; LCSC C135263
L4: 2.2uH; IND-SMD_L4.5-W4.1_TMPC0412HP; MPN TMPC0402HP-2R2MG-Z02; LCSC C357134
Q1, Q2: AO4407A; SOP-8_L5.0-W4.0-P1.27-LS6.0-BL; LCSC C2841482
Q3, Q4: SQ2318AES-T1_BE3; SOT-23-3_L2.9-W1.3-P1.90-LS2.4-BR; LCSC C3280170
Q5, Q6: BSS138; SOT-23-3_L2.9-W1.6-P1.90-LS2.8-BR; LCSC C52895
Q_BL: AO3401A; SOT-23_L2.9-W1.3-P1.90-LS2.4-BR; LCSC C15127
Q_BL_EN: 2N7002; SOT-23-3_L2.9-W1.3-P1.90-LS2.4-BR; LCSC C8545
Q_CAM: BSS138; SOT-23-3_L2.9-W1.6-P1.90-LS2.8-BR; LCSC C52895
Q_DBG: 2N7002; SOT-23-3_L2.9-W1.3-P1.90-LS2.4-BR; LCSC C8545
Q_I2C1, Q_I2C2: BSS138; SOT-23-3_L2.9-W1.6-P1.90-LS2.8-BR; LCSC C52895
Q_TP1, Q_TP2: BSS138; SOT-23-3_L2.9-W1.6-P1.90-LS2.8-BR; LCSC C52895
R1, R2, R3, R4, R6, R13, R14, R15, R16, R17, R18, R19, R20, R21, R26, R37, R48, R54, R55, R56, R58, R59, R71, R75, R76, R77, R78, R79, R91, R93: 10k; R_0402_1005Metric; LCSC C25744
R7: 30k; R_0402_1005Metric; LCSC C25776
R8, R30, R35, R45, R46, R63, R66, R67, R80: 100k; R_0402_1005Metric; LCSC C25741
R9, R10: 2.2k; R_0402_1005Metric; LCSC C25879
R22: 8.2k; R_0603_1608Metric; LCSC C25981
R23: 5.23k; R_0402_1005Metric; LCSC C11631
R27: 137k; R_0402_1005Metric; LCSC C32298
R28, R65: 24k; R_0402_1005Metric; LCSC C25769
R29: 78.7k; R_0402_1005Metric; LCSC C2998104
R31: 3.6k; R_0402_1005Metric; MPN 0402WGF3601TCE; LCSC C25891
R32: 1.5R; R_0603_1608Metric; LCSC C22769
R33: 82k; R_0402_1005Metric; LCSC C4142
R34: 5.1k; R_0402_1005Metric; LCSC C25905
R36, R53: 22R; R_0402_1005Metric; LCSC C25092
R42: 30.1k; R_0402_1005Metric; LCSC C29402
R47: 45.3k; R_0402_1005Metric; LCSC C26980
R49: 4.7R; R_0402_1005Metric; LCSC C25121
R50, R69: 100R; R_0402_1005Metric; LCSC C25076
R51, R52, R90: 47k; R_0402_1005Metric; MPN 0402WGF4702TCE; LCSC C25792
R60: 2.2R; R_0603_1608Metric; LCSC C22939
R61, R62, R74: 10R; R_0402_1005Metric; LCSC C25077
R64: 133k; R_0402_1005Metric; LCSC C25753
R68: 47k; R_0402_1005Metric; LCSC C25792
R72, R73: 150k; R_0402_1005Metric; LCSC C25755
R81: 1M; R_0402_1005Metric; LCSC C26083
R82, R83: 2.2k; R_0402_1005Metric; MPN 0402WGF2201TCE; LCSC C25879
R84: 1k; R_0402_1005Metric; MPN 0402WGF1001TCE; LCSC C11702
R87: 100R; R_0402_1005Metric; MPN 0402WGF1000TCE; LCSC C25076
R88: 80.6k; R_0402_1005Metric; MPN 0402WGF8062TCE; LCSC C25921
R89: 4.7k; R_0402_1005Metric; MPN 0402WGF4701TCE; LCSC C25900
R94: 22k; R_0402_1005Metric; MPN 0402WGF2202TCE; LCSC C25768
R95: 10k; R_0402_1005Metric; MPN 0402WGF1002TCE; LCSC C25744
R96, R97: 100k; R_0402_1005Metric; MPN 0402WGF1003TCE; LCSC C25741
SW1: PTS526SM15SMTR2LFS; SW-SMD_4P-L5.2-W5.2-P3.70-LS6.4; LCSC C2689538
TP1: TP1; TestPoint_Pad_D1.5mm
TP2: TP2; TestPoint_Pad_D1.5mm
TP3: TP3; TestPoint_Pad_D1.5mm
TP4: TP4; TestPoint_Pad_D1.5mm
TP5: TP5; TestPoint_Pad_D1.5mm
TP6: TP6; TestPoint_Pad_D1.5mm
U1: ComputeModule5-CM5; Raspberry-Pi-5-Compute-Module; LCSC C597931
U_3V3: TLV62569DBVR; SOT-23-5_L3.0-W1.7-P0.95-LS2.8-BR; MPN TLV62569DBVR; LCSC C141836
U_AMP: PAM8406DR; SOIC-16_L9.9-W3.9-P1.27-LS6.0-BL; LCSC C86270
U_BL: TPS61165DBVR; SOT-23-6_L2.9-W1.6-P0.95-LS2.8-BR; LCSC C58756
U_BUCK, U_BUCK2: TPS56628DDAR; SOIC-8_L4.9-W3.9-P1.27-LS6.0-BL-EP; LCSC C485522
U_CHG: BQ25798RQMR; QFN-29_L4.0-W4.0-P0.40-TL-BQ25792RQMR; LCSC C2876593
U_CODEC: ES8388; QFN-28_L4.0-W4.0-P0.45-BL-EP; LCSC C365736
U_DBG: TPS2117DRLR; SOT-583-8_L2.1-W1.2-P0.50-LS1.6-BL; LCSC C22399676
U_ESD, U_ESD1, U_ESD2: USBLC6-2SC6; SOT-23-6_L2.9-W1.6-P0.95-LS2.8-BL; LCSC C2687116
U_HALL: DRV5032FADBZR; SOT-23-3_L2.9-W1.3-P0.95-LS2.4-BR; LCSC C140921
U_KB: TCA8418RTWR; WQFN-24_L4.0-W4.0-P0.50-TL-EP2.5; LCSC C138713
U_RTC: HT7530S; SOT-23-3_L3.0-W1.7-P0.95-LS2.9-BR; LCSC C347214
U_UVLO: TPS3700DDCR; SOT-23-6_L2.9-W1.6-P0.95-LS2.8-BL; LCSC C33002
U_VBUS: SY6280AAC; SOT-23-5_L3.0-W1.7-P0.95-LS2.8-BL; LCSC C55136

Connections:
/3V3_PER_EN: R45.1, R46.1, U_3V3.1 (EN)
/3V3_PER_FB: R47.2, R48.1, U_3V3.5 (FB)
/3V3_PER_SW: L4.1, U_3V3.3 (SW)
/+3V3: C23.1, C24.1, C25.1, FB5.1, Q_BL_EN.1 (G), R2.2, R3.2, R4.2, R6.2, R13.2, R14.2, R15.2, R20.2, R21.2, R37.2, R49.1, R63.1, R75.2, R76.2, R77.2, R78.2, R79.2, R90.1, U1.78 (GPIO_VREF(1.8v/3.3v_Input)), U1.84 (+3.3v_(Output)), U1.86 (+3.3v_(Output)), U_BUCK2.1 (EN), U_CODEC.2 (DVDD), U_CODEC.3 (PVDD), U_HALL.1 (VCC), U_KB.21 (VCC)
/+3V3_PER: C38.1, C43.1, C44.1, C45.1, C46.1, C47.1, C48.1, C97.1, C101.1, D31.1, D32.1, D33.6, D34.6, J_AUDR.8, J_CSI.22, J_DSI.22, J_TP.2, L4.2, Q_CAM.1 (G), Q_I2C1.1 (G), Q_I2C2.1 (G), Q_TP1.1 (G), Q_TP2.1 (G), R9.1, R10.1, R18.2, R19.2, R47.1, R82.1, R83.1, R95.1
/+5V: C14.1, C15.1, C16.1, C17.1, C64.1, D3.1, L2.2, Q1.5 (D), Q1.6 (D), Q1.7 (D), Q1.8 (D), R27.1
/+5V_CM5: C54.1, C55.1, C56.1, C98.1, Q2.5 (D), Q2.6 (D), Q2.7 (D), Q2.8 (D), R1.2, U1.77 (+5v_(Input)), U1.79 (+5v_(Input)), U1.81 (+5v_(Input)), U1.83 (+5v_(Input)), U1.85 (+5v_(Input)), U1.87 (+5v_(Input)), U_DBG.2 (VOUT), U_DBG.7 (VOUT)
/+5V_PER: C18.1, C35.1, C36.1, C41.1, C42.1, C78.1, C84.1, C85.1, C86.1, C87.1, D18.1 (K), L5.2, R45.2, R64.1, R71.2, U_3V3.4 (VIN), U_AMP.4 (PVDDL), U_AMP.6 (VDD), U_AMP.13 (PVDDR), U_VBUS.5 (IN)
/+5V_USBC: C19.1, D2.1 (K), J4.1, J4.2, J4.3, U_VBUS.1 (OUT)
/AMP_INL: R72.2, U_AMP.7 (INL)
/AMP_INL_AC: C31.2, R72.1
/AMP_INR: R73.2, U_AMP.10 (INR)
/AMP_INR_AC: C32.2, R73.1
/AMP_MODE: R71.1, U_AMP.9 (MODE)
/AMP_OUTL_N: FB2.1, U_AMP.3 (-OUT_L)
/AMP_OUTL_P: FB1.1, U_AMP.1 (+OUT_L)
/AMP_OUTR_N: FB4.1, U_AMP.14 (-OUT_R)
/AMP_OUTR_P: FB3.1, U_AMP.16 (+OUT_R)
/AMP_SHDN_N: R17.1, U1.29 (GPIO16), U_AMP.5 (~MUTE), U_AMP.12 (~SHDN)
/AMP_VREF: C37.1, U_AMP.8 (VREF)
/BAT_TS: J_BAT.5, R87.1
/BL_COMP: C21.1, U_BL.5 (COMP)
/BL_EN_D: Q_BL_EN.3 (D), R80.2
/BL_FB: D38.1, R93.2, U_BL.6 (FB)
/BL_PWM: R16.1, U1.31 (GPIO12), U_BL.2 (CTRL)
/BL_SW: D1.2, L3.1, U_BL.3 (SW)
/BL_SW_G: C92.2, Q_BL.1 (G), R35.1, R80.1
/BT_NDIS: R3.1, U1.91 (BT_nDisable)
/BUCK2_FB: C78.2, R64.2, R65.1, U_BUCK2.2 (VFB)
/BUCK2_PG: R66.2, U_BUCK2.4 (PG)
/BUCK2_SW: C80.1, L5.1, U_BUCK2.6 (SW)
/BUCK2_VBST: C80.2, U_BUCK2.7 (VBST)
/BUCK2_VREG5: C79.1, R66.1, U_BUCK2.3 (VREG5)
/BUCK_EN: R67.2, R68.1, R81.1, U_BUCK.1 (EN), U_UVLO.1 (OUTA)
/BUCK_FB: C17.2, R27.2, R28.1, U_BUCK.2 (VFB)
/BUCK_PG: Q_DBG.1 (G), R26.2, R58.1, U_BUCK.4 (PG)
/BUCK_SW: C12.1, L2.1, U_BUCK.6 (SW)
/BUCK_VBST: C12.2, U_BUCK.7 (VBST)
/BUCK_VREG5: C11.1, R26.1, U_BUCK.3 (VREG5)
/CAM_GPIO0: D40.1, J_CSI.18, R53.2, R54.1
/CAM_GPIO0_SRC: R53.1, U1.97 (CAM_GPIO0)
/CAM_GPIO1: D34.1, J_CSI.17, Q_CAM.2 (S), R95.2, R96.1
/CAM_GPIO1_CM5: Q_CAM.3 (D), U1.100 (CAM_GPIO1)
/CHG_ACDRV1: R69.1, U_CHG.11 (ACDRV1)
/CHG_ACDRV1_G: C89.1, D15.1 (K), Q3.1 (G), Q4.1 (G), R69.2
/CHG_AC_SRC: C89.2, D15.2 (A), Q3.2 (S), Q4.2 (S)
/CHG_BATP: C4.1, R50.2, U_CHG.18 (BATP)
/CHG_BTST1: C7.2, U_CHG.4 (BTST1)
/CHG_BTST2: C13.2, U_CHG.19 (BTST2)
/CHG_DP_DM: U_CHG.6 (D+), U_CHG.7 (D-)
/CHG_ILIM: R29.2, R30.1, U_CHG.17 (ILIM_HIZ)
/CHG_INT_N: R14.1, U1.34 (GPIO5), U_CHG.21 (~INT)
/CHG_PMID: C9.1, C66.1, C67.1, C68.1, U_CHG.29 (PMID)
/CHG_PROG: R22.1, U_CHG.20 (PROG)
/CHG_REGN: C8.1, R23.1, R29.1, U_CHG.5 (REGN)
/CHG_SDRV: C70.1, U_CHG.24 (SDRV)
/CHG_STAT: R15.1, U_CHG.1 (STAT)
/CHG_SW1: C7.1, L1.1, U_CHG.28 (SW1)
/CHG_SW2: C13.1, L1.2, U_CHG.26 (SW2)
/CHG_TS: C59.1, D19.1 (C), R23.2, R42.1, R87.2, U_CHG.16 (TS)
/CHG_VAC1: C96.1, R74.2, U_CHG.9 (VAC1)
/CHG_VBUS: C1.1, C65.1, C77.1, Q4.3 (D), U_CHG.2 (VBUS), U_CHG.3 (VBUS), U_CHG.8 (VAC2)
/CM5_PWR_BUT: D16.2 (A), U1.92 (PWR_BUT)
/CM5_VBUS_EN: R91.1, U1.111 (VBUS_EN)
/CODEC_ADCVREF: C27.1, U_CODEC.19 (ADCVREF)
/CODEC_AVDD: C49.1, C50.1, R49.2, U_CODEC.17 (AVDD)
/CODEC_HPVDD: C99.1, FB5.2, U_CODEC.16 (HPVDD)
/CODEC_LIN1: C33.1, U_CODEC.24 (LIN1)
/CODEC_LOUT1: C29.1, C52.1, U_CODEC.12 (LOUT1)
/CODEC_LOUT2: C31.1, U_CODEC.15 (LOUT2)
/CODEC_MICBIAS: C51.1, U_CODEC.25 (MICBIAS)
/CODEC_RIN1: C34.1, U_CODEC.23 (RIN1)
/CODEC_ROUT1: C30.1, C53.1, U_CODEC.11 (ROUT1)
/CODEC_ROUT2: C32.1, U_CODEC.14 (ROUT2)
/CODEC_VMID: C28.1, U_CODEC.20 (VMID)
/CODEC_VREF: C26.1, U_CODEC.10 (VREF)
/DBG_EN_D: Q_DBG.3 (D), R84.2
/DBG_GATE: D39.1 (K), Q1.4 (G), Q2.4 (G), R59.1, R84.1
/DBG_MILLER: C98.2, D39.2 (A), R94.2
/DBG_PR1: C100.1, R7.1, R58.2, U_DBG.4 (PR1)
/DBG_PWR: C88.1, D4.1 (C), TP1.1, U_DBG.6 (VIN2)
/DBG_Q_SRC: Q1.1 (S), Q1.2 (S), Q1.3 (S), Q2.1 (S), Q2.2 (S), Q2.3 (S), R59.2, R94.1
/DSI_EN: D33.3, J_DSI.18, R56.1, U1.39 (GPIO8)
/DSI_RST_N: D33.1, J_DSI.17, R55.1, U1.37 (GPIO7)
/ESD1_VBUS: C90.1, U_ESD1.5 (VBUS)
/ESD2_VBUS: C91.1, U_ESD2.5 (VBUS)
/ESD_VBUS: C95.1, U_ESD.5 (VBUS)
/GND: C1.2, C2.2, C3.2, C4.2, C5.2, C6.2, C8.2, C9.2, C10.2, C11.2, C14.2, C15.2, C16.2, C18.2, C19.2, C20.2, C21.2, C22.2, C23.2, C24.2, C25.2, C26.2, C27.2, C28.2, C35.2, C36.2, C37.2, C38.2, C39.2, C40.2, C41.2, C42.2, C43.2, C44.2, C45.2, C46.2, C47.2, C48.2, C49.2, C50.2, C51.2, C54.2, C55.2, C56.2, C57.2, C58.2, C59.2, C60.2, C61.2, C62.2, C63.2, C64.2, C65.2, C66.2, C67.2, C68.2, C69.2, C70.2, C71.2, C72.2, C73.2, C74.2, C75.2, C76.2, C77.2, C79.2, C81.2, C82.2, C83.2, C84.2, C85.2, C86.2, C87.2, C88.2, C90.2, C91.2, C93.2, C95.2, C96.2, C97.2, C99.2, C100.2, C101.2, D2.2 (A), D3.2, D4.2 (A), D5.2, D6.2 (A), D7.1 (GND), D7.2 (GND), D7.3 (GND), D7.7 (EP), D9.2 (A), D10.2, D11.2, D12.2, D13.2, D14.2, D18.2 (A), D19.2 (A), D20.2, D21.2, D22.2, D23.2, D24.2 (A), D25.2, D26.2, D27.2, D28.2, D28.5, D28.6, D29.2, D29.6, D30.2, D30.4, D30.5, D30.6, D31.2, D32.2, D33.2, D34.2, D34.3, D35.1 (GND), D35.2 (GND), D35.3 (GND), D35.7 (GND), D36.2 (A), D38.2, D40.2, J4.4, J4.5, J4.6, J4.7, J4.8, J5.6, J5.7, J5.8, J5.9, J5.10, J5.11, J5.12, J_AUDR.1, J_AUDR.4, J_AUDR.9, J_AUDR.10, J_BAT.6, J_BAT.7, J_BAT.8, J_BAT.9, J_BAT.10, J_BAT.11, J_BL.3, J_BL.4, J_CSI.1, J_CSI.4, J_CSI.7, J_CSI.10, J_CSI.13, J_CSI.16, J_CSI.19, J_CSI.23, J_CSI.24, J_DSI.1, J_DSI.4, J_DSI.7, J_DSI.10, J_DSI.13, J_DSI.16, J_DSI.19, J_DSI.23, J_DSI.24, J_KB.20, J_KB.21, J_KB.22, J_KB.23, J_KB.24, J_KB.25, J_KB.26, J_SPKL.3, J_SPKL.4, J_SPKR.3, J_SPKR.4, J_TP.1, J_TP.7, J_TP.8, J_TP.9, J_TP.10, J_USBL.5, J_USBL.6, J_USBL.9, J_USBL.12, J_USBL.15, J_USBL.16, J_USBL.17, J_USBL.18, Q5.2 (S), Q6.2 (S), Q_BL_EN.2 (S), Q_DBG.2 (S), R7.2, R8.2, R16.2, R17.2, R22.2, R28.2, R30.2, R31.2, R32.2, R34.2, R42.2, R46.2, R48.2, R51.1, R52.2, R54.2, R55.2, R56.2, R63.2, R65.2, R68.2, R89.2, R96.2, SW1.3, SW1.4, TP4.1, U1.1 (GND), U1.2 (GND), U1.7 (GND), U1.8 (GND), U1.13 (GND), U1.14 (GND), U1.22 (GND), U1.23 (GND), U1.32 (GND), U1.33 (GND), U1.42 (GND), U1.43 (GND), U1.52 (GND), U1.53 (GND), U1.59 (GND), U1.60 (GND), U1.65 (GND), U1.66 (GND), U1.71 (GND), U1.74 (GND), U1.98 (GND), U1.107 (GND), U1.108 (GND), U1.113 (GND), U1.114 (GND), U1.119 (GND), U1.120 (GND), U1.125 (GND), U1.126 (GND), U1.131 (GND), U1.132 (GND), U1.137 (GND), U1.138 (GND), U1.144 (GND), U1.150 (GND), U1.155 (GND), U1.156 (GND), U1.161 (GND), U1.162 (GND), U1.167 (GND), U1.168 (GND), U1.173 (GND), U1.174 (GND), U1.179 (GND), U1.180 (GND), U1.185 (GND), U1.186 (GND), U1.191 (GND), U1.192 (GND), U1.197 (GND), U1.198 (GND), U_3V3.2 (GND), U_AMP.2 (PGNDL), U_AMP.11 (GND), U_AMP.15 (PGNDR), U_BL.4 (GND), U_BUCK.5 (GND), U_BUCK.9 (GND), U_BUCK2.5 (GND), U_BUCK2.9 (GND), U_CHG.10 (ACDRV2), U_CHG.13 (~CE), U_CHG.27 (GND), U_CODEC.4 (DGND), U_CODEC.13 (HPGND), U_CODEC.18 (AGND), U_CODEC.26 (CE), U_CODEC.29 (EP), U_DBG.1 (GND), U_DBG.3 (VIN1), U_DBG.5 (MODE), U_ESD.2 (GND), U_ESD1.2 (GND), U_ESD2.2 (GND), U_HALL.3 (GND), U_KB.19 (GND), U_KB.25 (EP), U_RTC.1 (GND), U_UVLO.2 (GND), U_VBUS.2 (GND)
/HP_DET: D14.1, J_AUDR.7, R37.1, U1.45 (GPIO24)
/HP_L: D10.1, J_AUDR.2, R61.2
/HP_L_AC: C29.2, C52.2, R61.1
/HP_R: D11.1, J_AUDR.3, R62.2
/HP_R_AC: C30.2, C53.2, R62.1
/I2C_SCL: Q_TP1.3 (D), U1.56 (GPIO3), U_CHG.14 (SCL), U_CODEC.28 (CCLK), U_KB.23 (SCL)
/I2C_SDA: Q_TP2.3 (D), U1.58 (GPIO2), U_CHG.15 (SDA), U_CODEC.27 (CDATA), U_KB.22 (SDA)
/I2S_BCLK: U1.49 (GPIO18), U_CODEC.5 (SCLK)
/I2S_DIN: U1.27 (GPIO20), U_CODEC.8 (ASDOUT)
/I2S_DOUT: U1.25 (GPIO21), U_CODEC.6 (DSDIN)
/I2S_LRCK: U1.26 (GPIO19), U_CODEC.7 (LRCK)
/I2S_MCLK: R36.2, U_CODEC.1 (MCLK)
/I2S_MCLK_SRC: R36.1, U1.54 (GPIO4)
/KB_COL0: D26.5, J_KB.9, U_KB.9 (COL0)
/KB_COL1: D26.6, J_KB.10, U_KB.10 (COL1)
/KB_COL2: D27.1, J_KB.11, U_KB.11 (COL2)
/KB_COL3: D27.3, J_KB.12, U_KB.12 (COL3)
/KB_COL4: D27.4, J_KB.13, U_KB.13 (COL4)
/KB_COL5: D27.5, J_KB.14, U_KB.14 (COL5)
/KB_COL6: D27.6, J_KB.15, U_KB.15 (COL6)
/KB_COL7: D28.1, J_KB.16, U_KB.16 (COL7)
/KB_COL8: D28.3, J_KB.17, U_KB.17 (COL8)
/KB_COL9: D28.4, J_KB.18, U_KB.18 (COL9)
/KB_INT_N: R20.1, U1.46 (GPIO22), U_KB.24 (~INT)
/KB_ROW0: D25.1, J_KB.1, U_KB.8 (ROW0)
/KB_ROW1: D25.3, J_KB.2, U_KB.7 (ROW1)
/KB_ROW2: D25.4, J_KB.3, U_KB.6 (ROW2)
/KB_ROW3: D25.5, J_KB.4, U_KB.5 (ROW3)
/KB_ROW4: D25.6, J_KB.5, U_KB.4 (ROW4)
/KB_ROW5: D26.1, J_KB.6, U_KB.3 (ROW5)
/KB_ROW6: D26.3, J_KB.7, U_KB.2 (ROW6)
/KB_ROW7: D26.4, J_KB.8, U_KB.1 (ROW7)
/KB_RST_N: R21.1, U1.47 (GPIO23), U_KB.20 (~RESET)
/LED_ANODE: C22.1, D1.1, D35.4 (VDD/IO), D35.5 (VDD/IO), D35.6 (VDD/IO), J_BL.1
/LED_CATHODE: D36.1 (C), J_BL.2, R32.1, R93.1
/LID_SNS: R13.1, U1.28 (GPIO13), U_HALL.2 (OUT)
/MIC_N: C34.2, D13.1, J_AUDR.6, R52.1
/MIC_P: C33.2, D12.1, J_AUDR.5, R51.2
/MIPI0_C_N: J_CSI.8, U1.127 (MIPI0_C_N)
/MIPI0_C_P: J_CSI.9, U1.129 (MIPI0_C_P)
/MIPI0_D0_N: J_CSI.2, U1.115 (MIPI0_D0_N)
/MIPI0_D0_P: J_CSI.3, U1.117 (MIPI0_D0_P)
/MIPI0_D1_N: J_CSI.5, U1.121 (MIPI0_D1_N)
/MIPI0_D1_P: J_CSI.6, U1.123 (MIPI0_D1_P)
/MIPI1_C_N: J_DSI.8, U1.187 (MIPI1_C_N)
/MIPI1_C_P: J_DSI.9, U1.189 (MIPI1_C_P)
/MIPI1_D0_N: J_DSI.2, U1.175 (MIPI1_D0_N)
/MIPI1_D0_P: J_DSI.3, U1.177 (MIPI1_D0_P)
/MIPI1_D1_N: J_DSI.5, U1.181 (MIPI1_D1_N)
/MIPI1_D1_P: J_DSI.6, U1.183 (MIPI1_D1_P)
/MIPI1_D2_N: J_DSI.11, U1.193 (MIPI1_D2_N)
/MIPI1_D2_P: J_DSI.12, U1.195 (MIPI1_D2_P)
/MIPI1_D3_N: J_DSI.14, U1.194 (MIPI1_D3_N)
/MIPI1_D3_P: J_DSI.15, U1.196 (MIPI1_D3_P)
/PMIC_EN: D6.1 (C), R1.1, TP5.1, U1.99 (PMIC_ENABLE)
/PWR_BUT: D9.1 (C), D16.1 (K), J_KB.19
/RTC_3V0: C40.1, U1.76 (VBAT), U_RTC.2 (VOUT)
/RTC_VIN: C57.1, D37.1 (K), U_RTC.3 (VIN)
/SCL0: Q_I2C1.3 (D), U1.80 (SCL0)
/SCL0_PER: D33.5, D34.4, J_CSI.20, J_DSI.20, Q_I2C1.2 (S), R9.2
/SDA0: Q_I2C2.3 (D), U1.82 (SDA0)
/SDA0_PER: D33.4, D34.5, J_CSI.21, J_DSI.21, Q_I2C2.2 (S), R10.2
/SPKL_N: C61.1, FB2.2, J_SPKL.2
/SPKL_P: C60.1, FB1.2, J_SPKL.1
/SPKR_N: C63.1, FB4.2, J_SPKR.2
/SPKR_P: C62.1, FB3.2, J_SPKR.1
/TP_INT_N: D20.1, J_TP.5, R18.1, U1.50 (GPIO17)
/TP_RST_N: D21.1, J_TP.6, R19.1, U1.48 (GPIO27)
/TP_SCL: D23.1, J_TP.4, Q_TP1.2 (S), R82.2
/TP_SDA: D22.1, J_TP.3, Q_TP2.2 (S), R83.2
/USB2_N: TP3.1, U1.103 (USB2_N), U_ESD.3 (I/O2), U_ESD.4 (I/O2)
/USB2_P: TP2.1, U1.105 (USB2_P), U_ESD.1 (I/O1), U_ESD.6 (I/O1)
/USB3-0-D_N: J_USBL.11, U1.136 (USB3-0-D_N), U_ESD1.3 (I/O2), U_ESD1.4 (I/O2)
/USB3-0-D_P: J_USBL.10, U1.134 (USB3-0-D_P), U_ESD1.1 (I/O1), U_ESD1.6 (I/O1)
/USB3-1-D_N: J_USBL.14, U1.165 (USB3-1-D_N), U_ESD2.3 (I/O2), U_ESD2.4 (I/O2)
/USB3-1-D_P: J_USBL.13, U1.163 (USB3-1-D_P), U_ESD2.1 (I/O1), U_ESD2.6 (I/O1)
/USBL_J1_EN: D30.3, J_USBL.8, Q5.3 (D), R8.1, R91.2, U_VBUS.4 (EN)
/USBL_J1_FAULT_N: D29.5, J_USBL.4, R78.1, U1.30 (GPIO6)
/USBL_J1_UFP_N: D30.1, J_USBL.7, R79.1, U1.41 (GPIO25)
/USBL_PD_PG_N: D29.1, J_USBL.1, R75.1, U1.40 (GPIO9)
/USBL_U3_FLT_N: D29.3, J_USBL.2, R76.1, U1.44 (GPIO10)
/USBL_U5_FLT_N: D29.4, J_USBL.3, R77.1, U1.24 (GPIO26)
/USB_ISET: R31.1, U_VBUS.3 (ISET)
/USB_OTG_ID: R6.1, U1.101 (USB_OTG_ID)
/VBAT: C3.1, C69.1, D24.1 (C), D37.2 (A), F1.2, R50.1, U_CHG.22 (BAT), U_CHG.23 (BAT)
/VBAT_PACK: F1.1, J_BAT.1, J_BAT.2, J_BAT.3, J_BAT.4
/VBUS_ISET_HI: Q5.1 (G), Q6.1 (G), R90.2, U_UVLO.6 (OUTB)
/VBUS_PD: C2.1, D7.4 (VDD/IO), D7.5 (VDD/IO), D7.6 (VDD/IO), J5.1, J5.2, J5.3, J5.4, J5.5, Q3.3 (D), R60.1, R74.1
/VBUS_PD_SNUB: C58.1, R60.2
/VDD_1V8: C39.1, U1.88 (+1.8v_(Output)), U1.90 (+1.8v_(Output))
/VSYS: C5.1, C6.1, C10.1, C71.1, C72.1, C73.1, C74.1, C75.1, C76.1, C81.1, C82.1, C83.1, C93.1, F6.1, R33.1, R67.1, R88.1, U_BUCK.8 (VIN), U_BUCK2.8 (VIN), U_CHG.25 (SYS), U_UVLO.5 (VDD)
/VSYS_BL: C20.1, C92.1, L3.2, Q_BL.3 (D), U_BL.1 (VIN)
/VSYS_BL_SW: F6.2, Q_BL.2 (S), R35.2
/VSYS_THROT: R88.2, R89.1, R97.1, U_UVLO.4 (INB-)
/VSYS_THROT_HYS: Q6.3 (D), R97.2
/VSYS_UVLO: R33.2, R34.1, R81.2, U_UVLO.3 (INA+)
/WIFI_NDIS: R2.1, U1.89 (WiFi_nDisable)
/nRPIBOOT: D5.1, R4.1, SW1.1, SW1.2, TP6.1, U1.93 (nRPIBOOT)

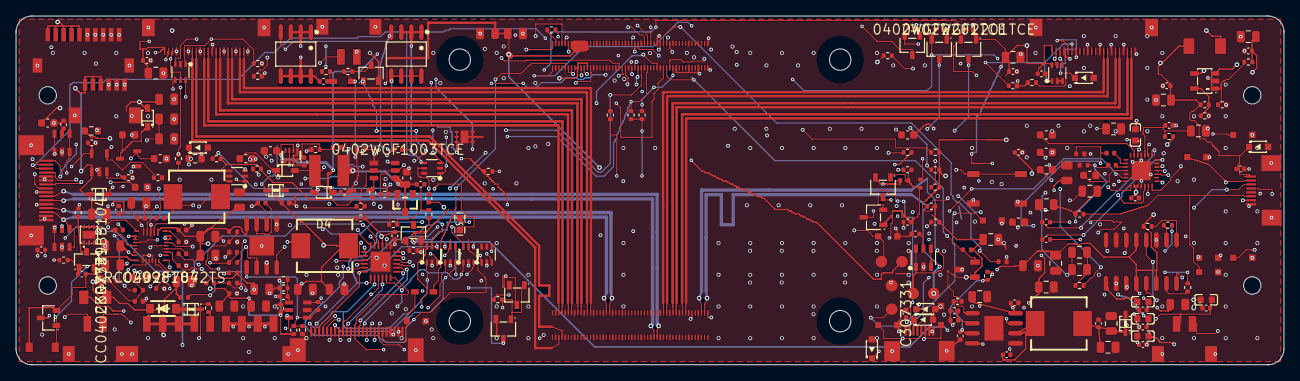
[picture p37: board thin-laptop-cm5.kicad_pcb from above]

Board: 4 copper layers, 160.0 x 44.0 mm, 285 parts (0 on the bottom side), 186 nets.
