CopperPilot/laptop/hardware/audio_right/thin-laptop-cm5-audio_right.kicad_pcb

## KiCad design hardware/audio_right/thin-laptop-cm5-audio_right.kicad_pcb (2026-11-06)

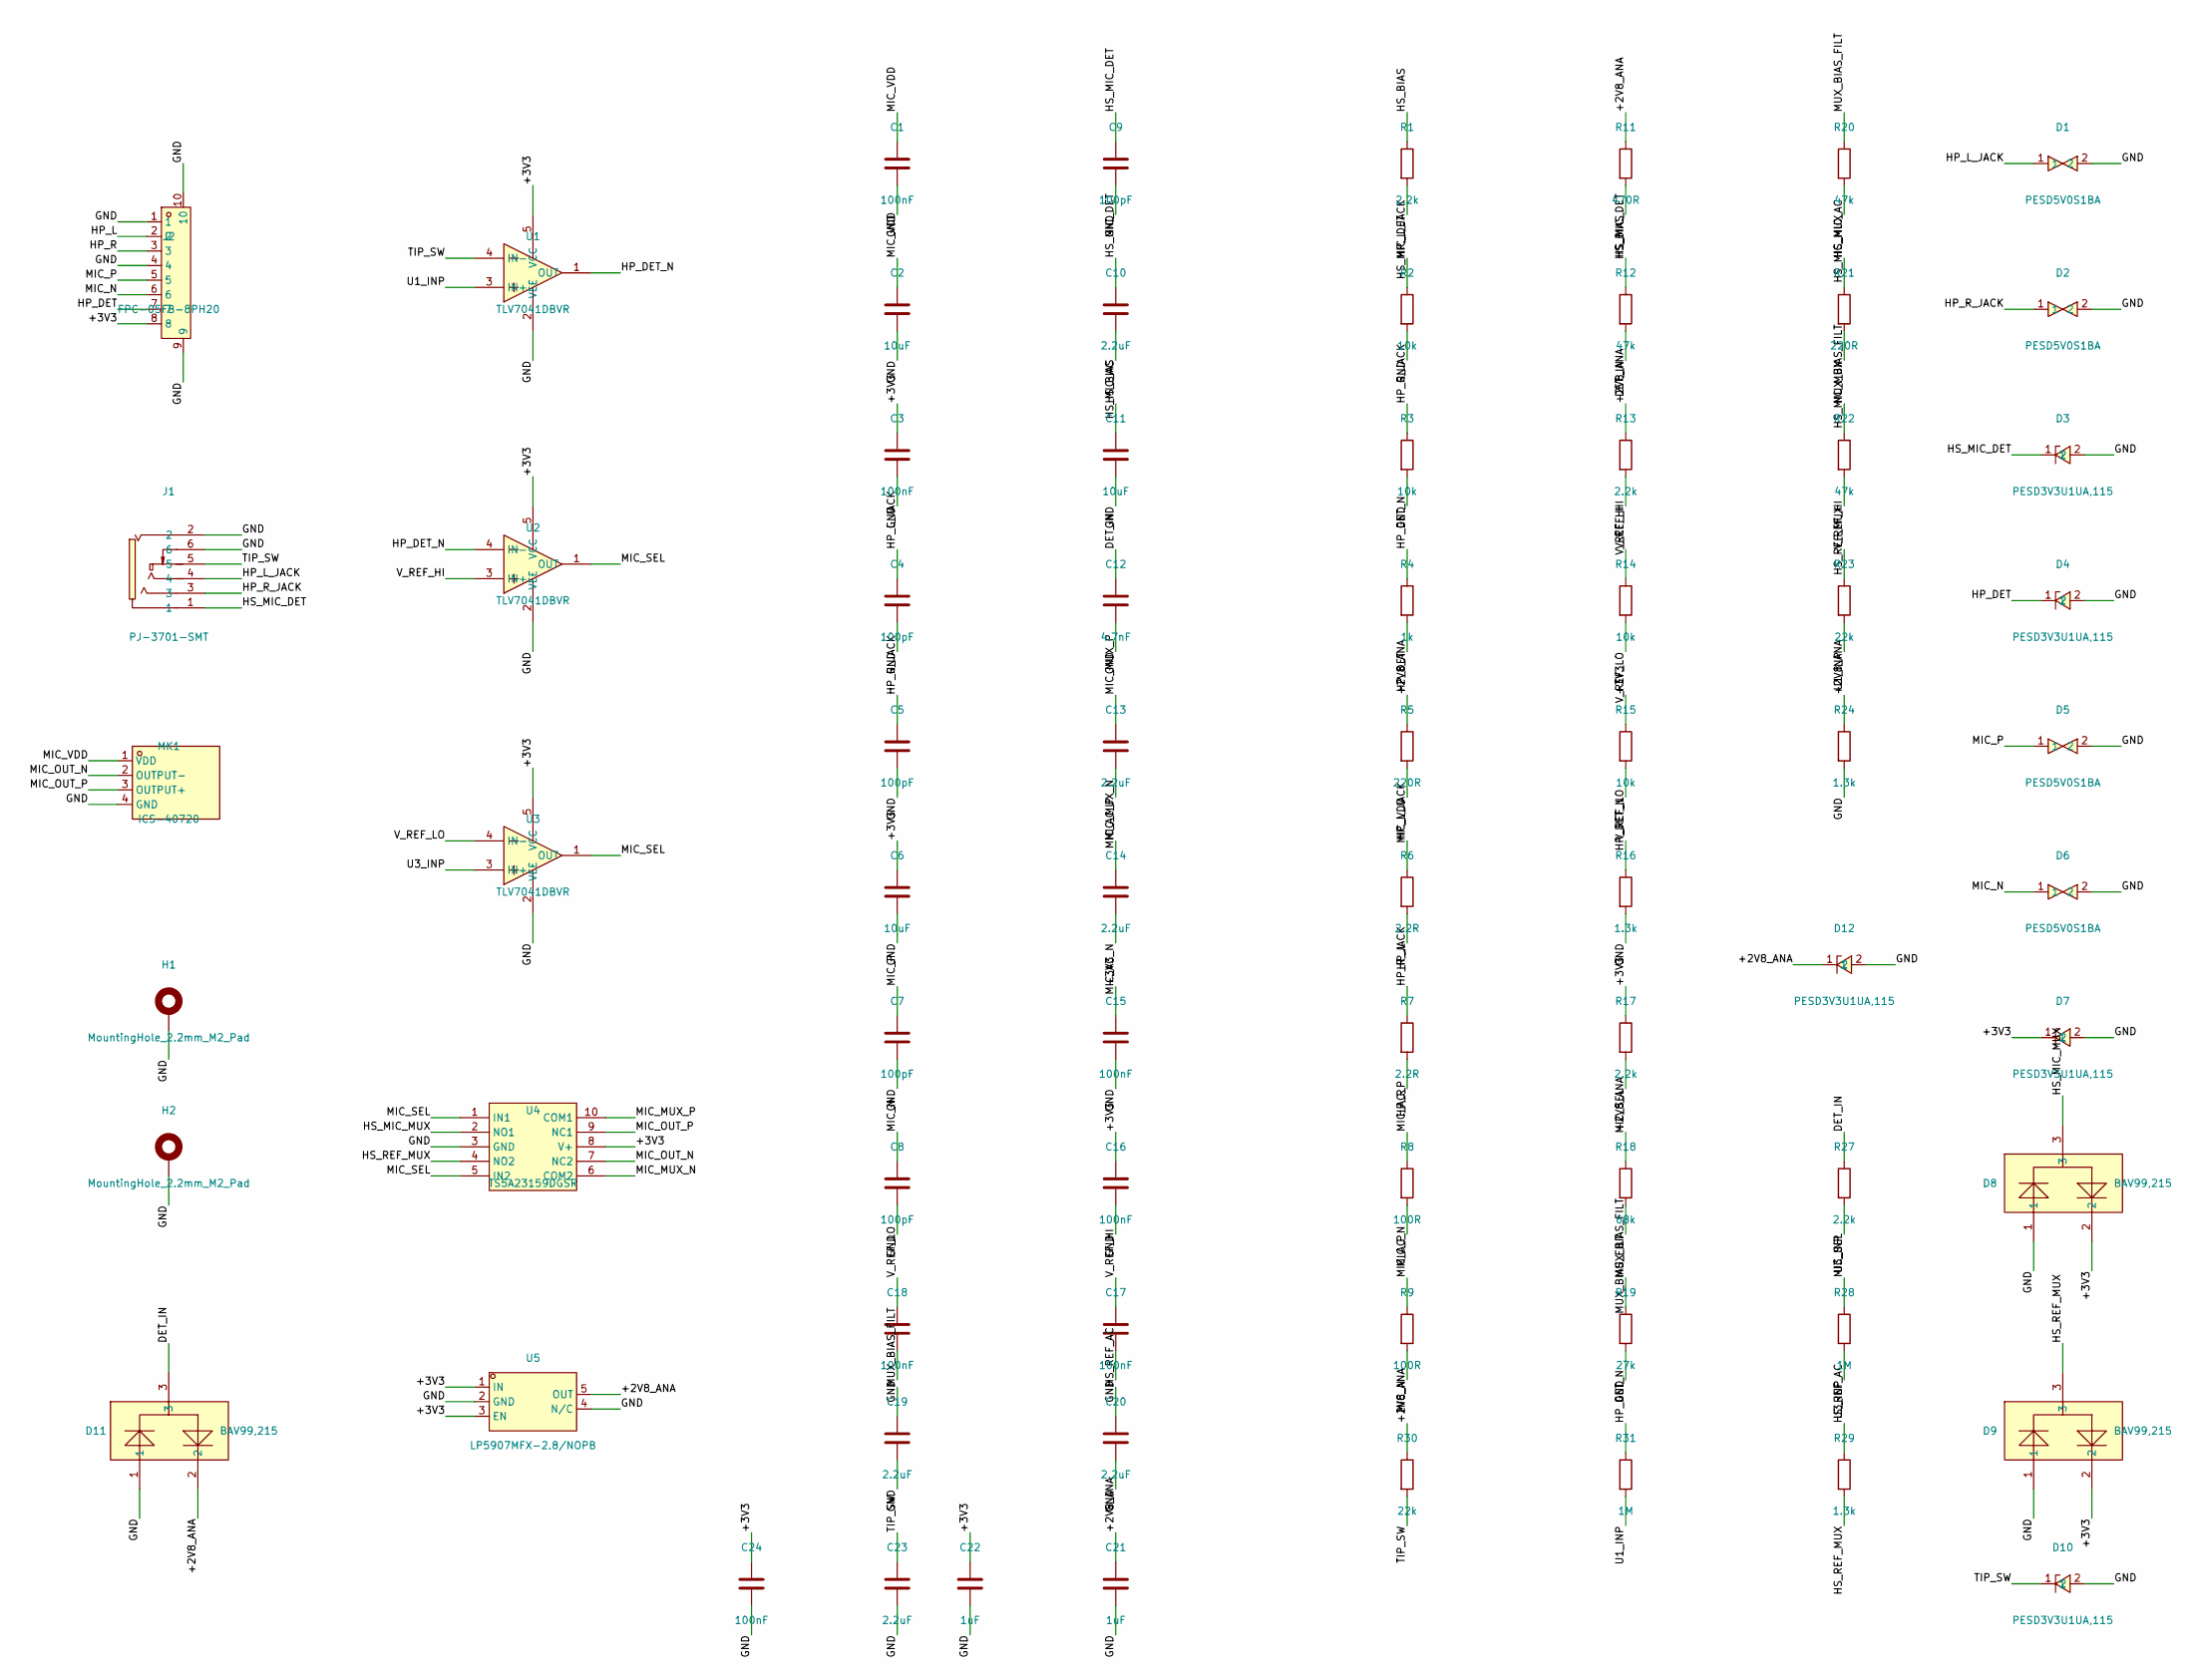
[picture p38: schematic thin-laptop-cm5-audio_right.kicad_sch, 13-inch Thin Aluminum CM5 Laptop - Right Audio & Mic Daught…]

Parts:
C1, C3, C15, C16, C17, C18, C24: 100nF; C_0402_1005Metric; LCSC C85858
C2, C6, C11: 10uF; C_0603_1608Metric; LCSC C96446
C4, C5, C7, C8, C9: 100pF; C_0402_1005Metric; LCSC C1546
C10, C13, C14, C19, C20, C23: 2.2uF; C_0402_1005Metric; LCSC C159814
C12: 4.7nF; C_0402_1005Metric; LCSC C1538
C21, C22: 1uF; C_0402_1005Metric; LCSC C52923
D1, D2, D5, D6: PESD5V0S1BA; SOD-323_L1.7-W1.3-LS2.5-BI; LCSC C2827694
D3, D4, D7, D10, D12: PESD3V3U1UA,115; SOD-323_L1.7-W1.3-LS2.5-RD; LCSC C403915
D8, D9, D11: BAV99,215; SOT-23-3_L2.9-W1.6-P1.90-LS2.8-BR; LCSC C2500
H1, H2: MountingHole_2.2mm_M2_Pad
J1: PJ-3701-SMT; AUDIO-SMD_PJ-3701-SMT; LCSC C2684645
J2: FPC-05FB-8PH20; FPC-SMD_8P-P0.50_XUNPU_FPC-05FB-8PH20; LCSC C2856828
MK1: ICS-40720; SMD_4P-P0.88_ICS-40720; LCSC C3171779
R1, R13, R17, R27: 2.2k; R_0402_1005Metric; LCSC C25879
R2, R3, R14, R15: 10k; R_0402_1005Metric; LCSC C25744
R4: 1k; R_0402_1005Metric; LCSC C11702
R5, R21: 220R; R_0402_1005Metric; LCSC C25091
R6, R7: 2.2R; R_0402_1005Metric; LCSC C25101
R8, R9: 100R; R_0402_1005Metric; LCSC C25076
R11: 470R; R_0402_1005Metric; LCSC C25117
R12, R20, R22: 47k; R_0402_1005Metric; LCSC C25792
R16, R24, R29: 1.3k; R_0402_1005Metric; LCSC C25866
R18: 68k; R_0402_1005Metric; LCSC C36871
R19: 27k; R_0402_1005Metric; LCSC C25771
R23, R30: 22k; R_0402_1005Metric; LCSC C25768
R28, R31: 1M; R_0402_1005Metric; LCSC C26083
U1, U2, U3: TLV7041DBVR; SOT-23-5_L2.9-W1.6-P0.95-LS2.8-BR; LCSC C702122
U4: TS5A23159DGSR; VSSOP-10_L3.0-W3.0-P0.50-LS4.9-BL; LCSC C42751
U5: LP5907MFX-2.8/NOPB; TSOT-23-5_L2.9-W1.6-P0.95-LS2.8-BL; LCSC C186700

Connections:
/+2V8_ANA: C21.1, D11.2, D12.1, R5.1, R11.1, R13.1, R18.1, R24.1, R30.1, U5.5 (OUT)
/+3V3: C3.1, C6.1, C15.1, C16.1, C22.1, C24.1, D7.1, D8.2, D9.2, J2.8, R15.1, R17.1, U1.5 (VCC), U2.5 (VCC), U3.5 (VCC), U4.8 (V+), U5.1 (IN), U5.3 (EN)
/DET_IN: C12.1, D11.3, R12.2, R27.1
/GND: C1.2, C2.2, C3.2, C4.2, C5.2, C6.2, C7.2, C8.2, C9.2, C11.2, C12.2, C15.2, C16.2, C17.2, C18.2, C19.2, C20.2, C21.2, C22.2, C23.2, C24.2, D1.2, D2.2, D3.2, D4.2, D5.2, D6.2, D7.2, D8.1, D9.1, D10.2, D11.1, D12.2, H1.1, H2.1, J1.2, J1.6, J2.1, J2.4, J2.9, J2.10, MK1.4 (GND), R2.2, R3.2, R16.2, R19.2, R24.2, U1.2 (VEE), U2.2 (VEE), U3.2 (VEE), U4.3 (GND), U5.2 (GND), U5.4 (N/C)
/HP_DET: D4.1, J2.7, R4.2
/HP_DET_N: R4.1, R15.2, R31.1, U1.1 (OUT), U2.4 (IN-)
/HP_L: J2.2, R6.2
/HP_L_JACK: C4.1, D1.1, J1.4, R2.1, R6.1
/HP_R: J2.3, R7.2
/HP_R_JACK: C5.1, D2.1, J1.3, R3.1, R7.1
/HS_BIAS: C11.1, R1.1, R11.2
/HS_MIC_AC: C10.2, R21.1
/HS_MIC_DET: C9.1, C10.1, D3.1, J1.1, R1.2, R12.1
/HS_MIC_MUX: D8.3, R20.2, R21.2, U4.2 (NO1)
/HS_REF_AC: C20.1, R29.1
/HS_REF_MUX: D9.3, R22.2, R29.2, U4.4 (NO2)
/MIC_AC_N: C14.2, R9.1
/MIC_AC_P: C13.2, R8.1
/MIC_MUX_N: C14.1, U4.6 (COM2)
/MIC_MUX_P: C13.1, U4.10 (COM1)
/MIC_N: C8.1, D6.1, J2.6, R9.2
/MIC_OUT_N: MK1.2 (OUTPUT−), U4.7 (NC2)
/MIC_OUT_P: MK1.3 (OUTPUT+), U4.9 (NC1)
/MIC_P: C7.1, D5.1, J2.5, R8.2
/MIC_SEL: R17.2, R28.1, U2.1 (OUT), U3.1 (OUT), U4.1 (IN1), U4.5 (IN2)
/MIC_VDD: C1.1, C2.1, MK1.1 (VDD), R5.2
/MUX_BIAS_FILT: C19.1, R18.2, R19.1, R20.1, R22.1
/TIP_SW: C23.1, D10.1, J1.5, R30.2, U1.4 (IN-)
/U1_INP: R23.2, R31.2, U1.3 (IN+)
/U3_INP: R27.2, R28.2, U3.3 (IN+)
/V_REF_HI: C17.1, R13.2, R14.1, R23.1, U2.3 (IN+)
/V_REF_LO: C18.1, R14.2, R16.1, U3.4 (IN-)

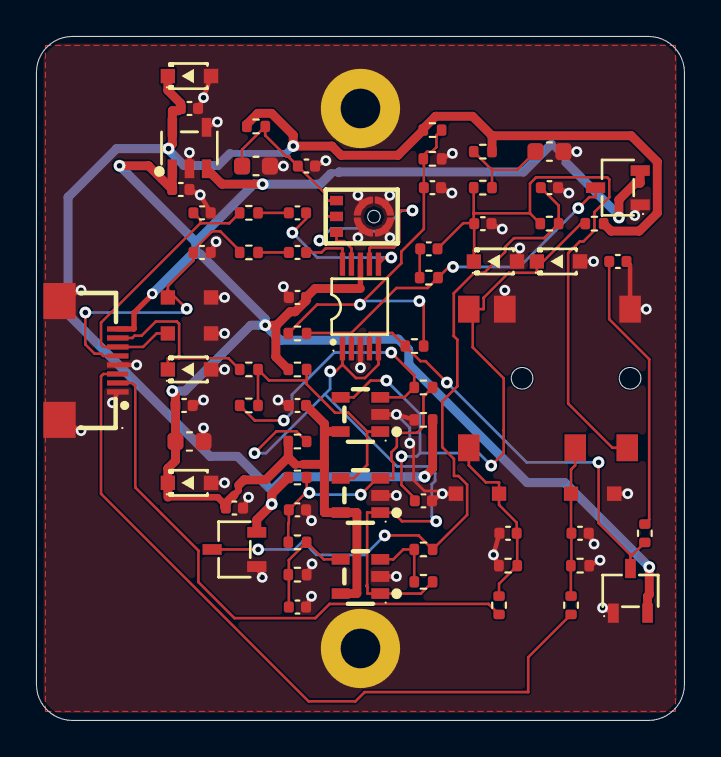
[picture p39: board thin-laptop-cm5-audio_right.kicad_pcb from above]

Board: 2 copper layers, 36.0 x 38.0 mm, 74 parts (0 on the bottom side), 32 nets.
