CopperPilot/laptop/hardware/usb_left/thin-laptop-cm5-usb_left.kicad_pcb

## KiCad design hardware/usb_left/thin-laptop-cm5-usb_left.kicad_pcb (2026-11-06)

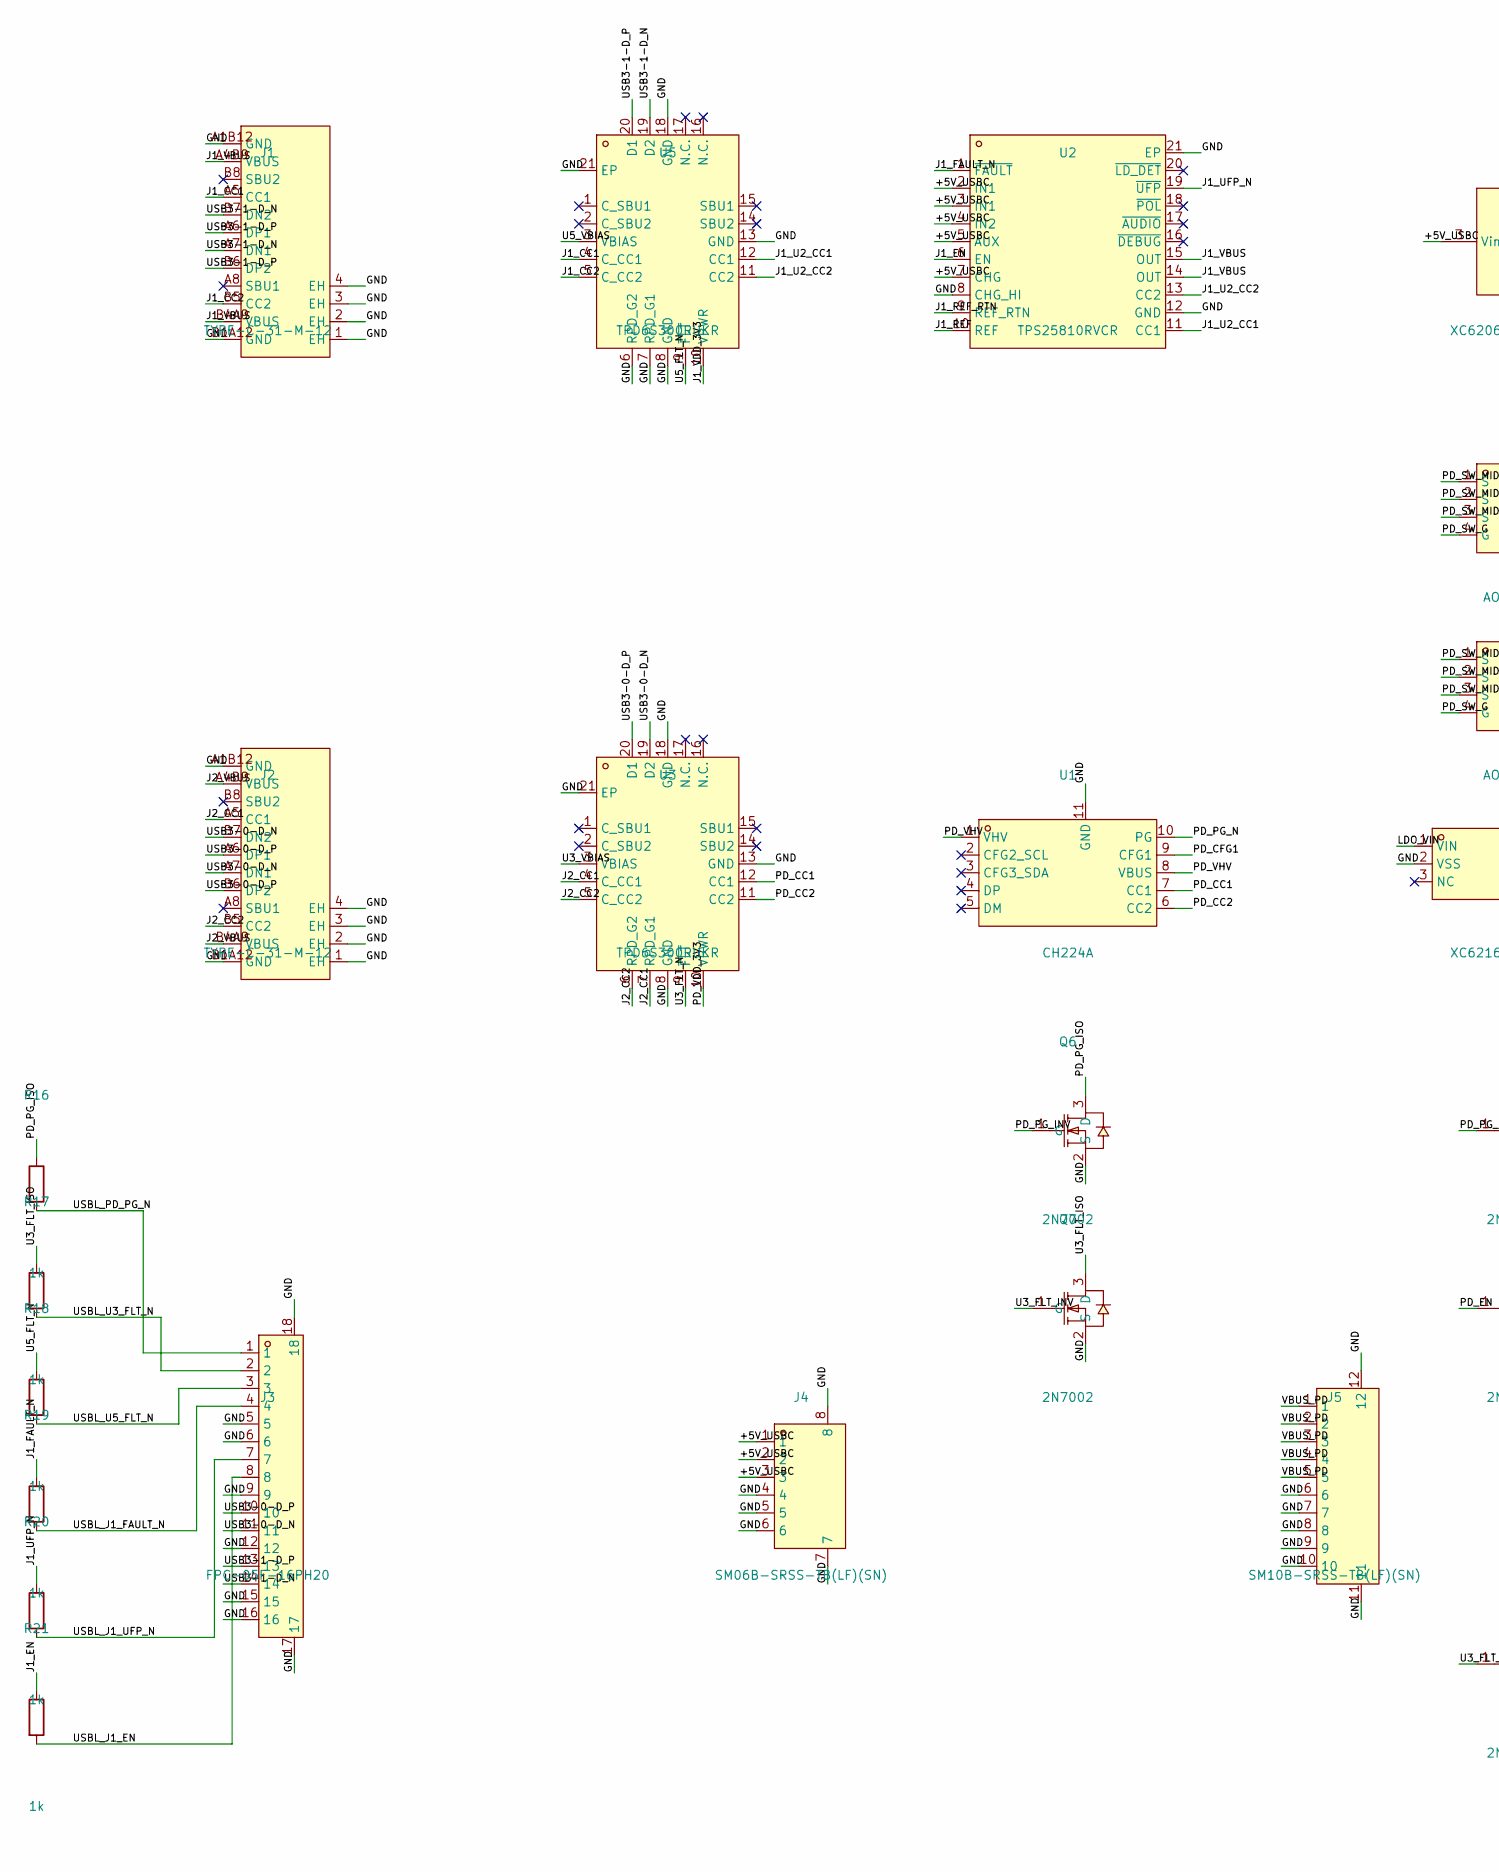
[picture p40: schematic thin-laptop-cm5-usb_left.kicad_sch, Left Dual USB-C PD & Data Daughter Board (usb_left), part in row 1, column 1]

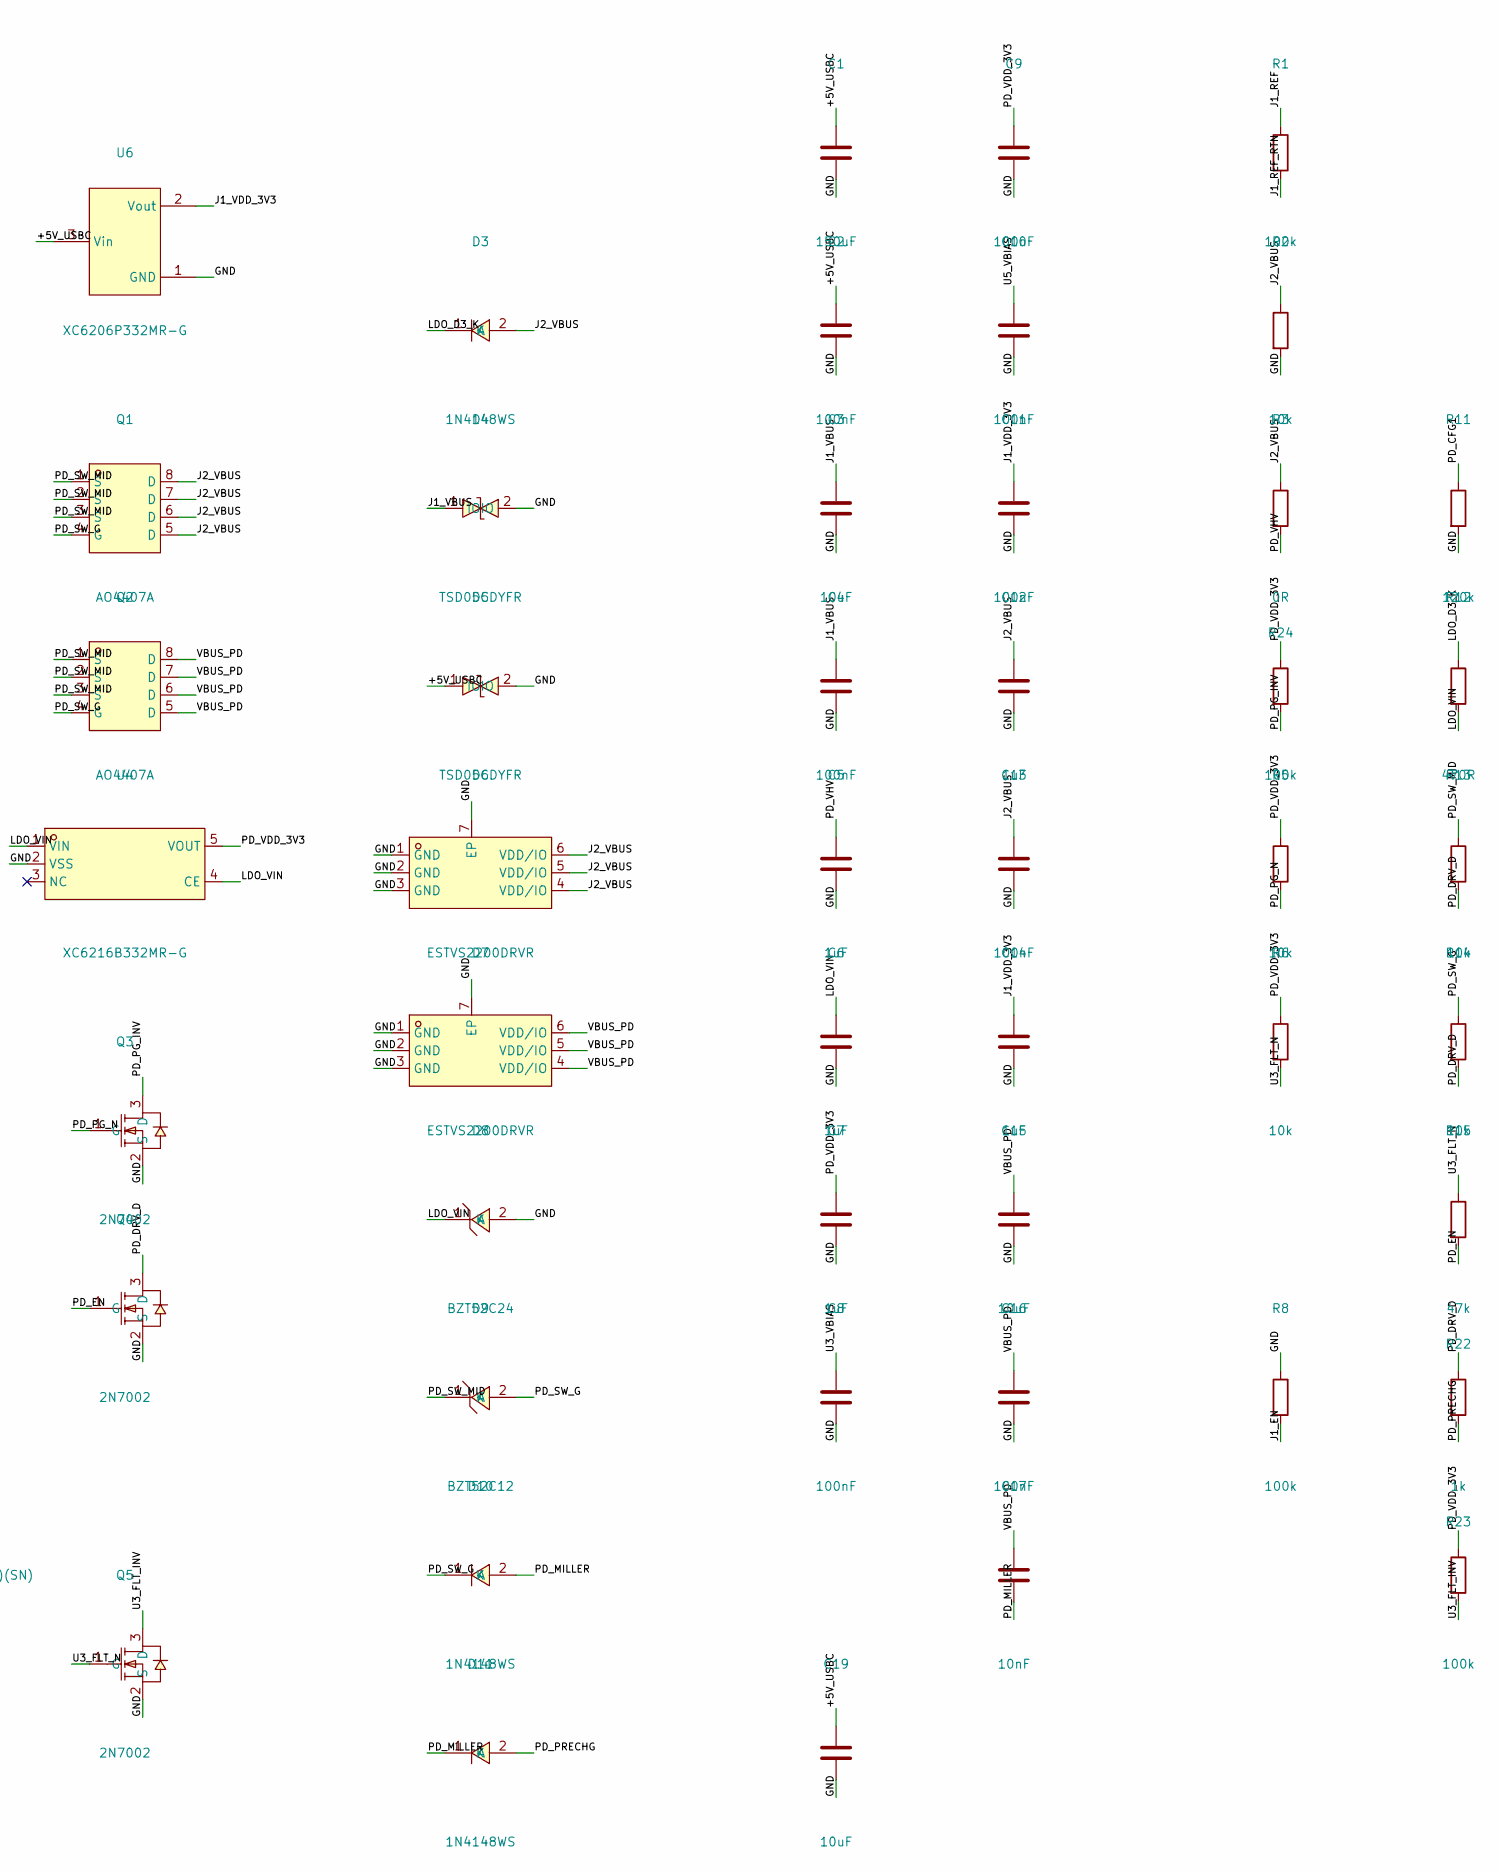
[picture p41: schematic thin-laptop-cm5-usb_left.kicad_sch, Left Dual USB-C PD & Data Daughter Board (usb_left), part in row 1, column 2]

Parts:
C1: 150uF; CAP-SMD_L6.0-W3.2; MPN T520C157M010ATE055; LCSC C600588
C2, C4, C8, C9, C10, C11, C13, C16: 100nF; C_0402_1005Metric; MPN CL05B104KB54PNC; LCSC C307331
C3, C15, C19: 10uF; C_0805_2012Metric; MPN GRM21BR61H106KE43L; LCSC C440198
C5, C6, C7, C12, C14: 1uF; C_0603_1608Metric; MPN CL10A105KB8NNNC; LCSC C15849
C17: 10nF; C_0402_1005Metric; MPN CL05B103KB5NNNC; LCSC C15195
D3, D10, D11: 1N4148WS; SOD-323_L1.8-W1.3-LS2.5-RD; MPN 1N4148WS; LCSC C2128
D4, D5: TSD05CDYFR; SOD-323_L1.8-W1.3-LS2.5-BI; MPN TSD05CDYFR; LCSC C20611048
D6, D7: ESTVS2200DRVR; DFN-6_L2.0-W2.0-P0.65-BL-EP1.6; MPN ESTVS2200DRVR; LCSC C42400188
D8: BZT52C24; SOD-123_L2.7-W1.6-LS3.7-RD; MPN BZT52C24; LCSC C173422
D9: BZT52C12; SOD-123_L2.7-W1.6-LS3.7-RD; MPN BZT52C12; LCSC C173429
J1, J2: TYPE-C-31-M-12; USB-C_SMD-TYPE-C-31-M-12_1; MPN TYPE-C-31-M-12; LCSC C165948
J3: FPC-05F-16PH20; FPC-SMD_16P-P0.50_FPC-05F-16PH20; MPN FPC-05F-16PH20; LCSC C2856801
J4: SM06B-SRSS-TB(LF)(SN); CONN-SMD_SM06B-SRSS-TB-LF-SN; MPN SM06B-SRSS-TB(LF)(SN); LCSC C160405
J5: SM10B-SRSS-TB(LF)(SN); CONN-SMD_10P-P1.00_SM10B-SRSS-TB-LF-SN; MPN SM10B-SRSS-TB(LF)(SN); LCSC C160409
Q1, Q2: AO4407A; SOP-8_L5.0-W4.0-P1.27-LS6.0-BL; MPN AO4407A; LCSC C2841482
Q3, Q4, Q5, Q6, Q7: 2N7002; SOT-23-3_L2.9-W1.3-P1.90-LS2.4-BR; MPN 2N7002; LCSC C8545
R1, R8, R23, R24: 100k; R_0402_1005Metric; MPN 0402WGF1003TCE; LCSC C25741
R2, R13, R14: 10k; R_0603_1608Metric; MPN 0603WAF1002T5E; LCSC C25804
R3: 0R; R_0603_1608Metric; MPN 0603WAF0000T5E; LCSC C21189
R5, R6: 10k; R_0402_1005Metric; MPN 0402WGF1002TCE; LCSC C25744
R11: 120k; R_0402_1005Metric; MPN 0402WGF1203TCE; LCSC C25750
R12: 470R; R_0603_1608Metric; MPN 0603WAF4700T5E; LCSC C23179
R15: 47k; R_0402_1005Metric; MPN 0402WGF4702TCE; LCSC C25792
R16, R17, R18, R19, R20, R21, R22: 1k; R_0402_1005Metric; MPN 0402WGF1001TCE; LCSC C11702
U1: CH224A; ESSOP-10_L4.9-W3.9-P1.0-LS6.0-TL-EP; MPN CH224A; LCSC C42459160
U2: TPS25810RVCR; WQFN-20_L4.0-W3.0-P0.50-BL-EP; MPN TPS25810RVCR; LCSC C473913
U3, U5: TPD6S300RUKR; WQFN-20_L3.0-W3.0-P0.40-BL-EP1.7; MPN TPD6S300RUKR; LCSC C2649810
U4: XC6216B332MR-G; SOT-23-5_L3.0-W1.6-P0.95-LS2.8-BR; MPN XC6216B332MR-G; LCSC C2891269
U6: XC6206P332MR-G; SOT-23-3_L2.9-W1.6-P1.90-LS2.8-BR; MPN XC6206P332MR-G; LCSC C5446

Connections:
/+5V_USBC: C1.1, C2.1, C19.1, D5.1, J4.1, J4.2, J4.3, U2.2 (IN1), U2.3 (IN1), U2.4 (IN2), U2.5 (AUX), U2.7 (CHG), U6.3 (Vin)
/GND: C1.2, C2.2, C3.2, C4.2, C5.2, C6.2, C7.2, C8.2, C9.2, C10.2, C11.2, C12.2, C13.2, C14.2, C15.2, C16.2, C19.2, D4.2, D5.2, D6.1 (GND), D6.2 (GND), D6.3 (GND), D6.7 (EP), D7.1 (GND), D7.2 (GND), D7.3 (GND), D7.7 (EP), D8.2 (A), J1.1 (EH), J1.2 (EH), J1.3 (EH), J1.4 (EH), J1.A1B12 (GND), J1.B1A12 (GND), J2.1 (EH), J2.2 (EH), J2.3 (EH), J2.4 (EH), J2.A1B12 (GND), J2.B1A12 (GND), J3.5, J3.6, J3.9, J3.12, J3.15, J3.16, J3.17, J3.18, J4.4, J4.5, J4.6, J4.7, J4.8, J5.6, J5.7, J5.8, J5.9, J5.10, J5.11, J5.12, Q3.2 (S), Q4.2 (S), Q5.2 (S), Q6.2 (S), Q7.2 (S), R2.2, R8.1, R11.2, U1.11 (GND), U2.8 (CHG_HI), U2.12 (GND), U2.21 (EP), U3.8 (GND), U3.13 (GND), U3.18 (GND), U3.21 (EP), U4.2 (VSS), U5.6 (RPD_G2), U5.7 (RPD_G1), U5.8 (GND), U5.13 (GND), U5.18 (GND), U5.21 (EP), U6.1 (GND)
/J1_CC1: J1.A5 (CC1), U5.4 (C_CC1)
/J1_CC2: J1.B5 (CC2), U5.5 (C_CC2)
/J1_EN: R8.2, R21.1, U2.6 (EN)
/J1_FAULT_N: R19.1, U2.1 (~FAULT)
/J1_REF: R1.1, U2.10 (REF)
/J1_REF_RTN: R1.2, U2.9 (REF_RTN)
/J1_U2_CC1: U2.11 (CC1), U5.12 (CC1)
/J1_U2_CC2: U2.13 (CC2), U5.11 (CC2)
/J1_UFP_N: R20.1, U2.19 (~UFP)
/J1_VBUS: C3.1, C4.1, D4.1, J1.A4B9 (VBUS), J1.B4A9 (VBUS), U2.14 (OUT), U2.15 (OUT)
/J1_VDD_3V3: C11.1, C14.1, U5.10 (VPWR), U6.2 (Vout)
/J2_CC1: J2.A5 (CC1), U3.4 (C_CC1), U3.7 (RPD_G1)
/J2_CC2: J2.B5 (CC2), U3.5 (C_CC2), U3.6 (RPD_G2)
/J2_VBUS: C12.1, C13.1, D3.2 (A), D6.4 (VDD/IO), D6.5 (VDD/IO), D6.6 (VDD/IO), J2.A4B9 (VBUS), J2.B4A9 (VBUS), Q1.5 (D), Q1.6 (D), Q1.7 (D), Q1.8 (D), R2.1, R3.1
/LDO_D3_K: D3.1 (K), R12.1
/LDO_VIN: C6.1, D8.1 (K), R12.2, U4.1 (VIN), U4.4 (CE)
/PD_CC1: U1.7 (CC1), U3.12 (CC1)
/PD_CC2: U1.6 (CC2), U3.11 (CC2)
/PD_CFG1: R11.1, U1.9 (CFG1)
/PD_DRV_D: Q4.3 (D), R13.2, R14.2, R22.1
/PD_EN: Q4.1 (G), R15.2
/PD_MILLER: C17.2, D10.2 (A), D11.1 (K)
/PD_PG_INV: Q3.3 (D), Q6.1 (G), R24.2
/PD_PG_ISO: Q6.3 (D), R16.1
/PD_PG_N: Q3.1 (G), R5.2, U1.10 (PG)
/PD_PRECHG: D11.2 (A), R22.2
/PD_SW_G: D9.2 (A), D10.1 (K), Q1.4 (G), Q2.4 (G), R14.1
/PD_SW_MID: D9.1 (K), Q1.1 (S), Q1.2 (S), Q1.3 (S), Q2.1 (S), Q2.2 (S), Q2.3 (S), R13.1
/PD_VDD_3V3: C7.1, C9.1, R5.1, R6.1, R23.1, R24.1, U3.10 (VPWR), U4.5 (VOUT)
/PD_VHV: C5.1, R3.2, U1.1 (VHV), U1.8 (VBUS)
/U3_FLT_INV: Q5.3 (D), Q7.1 (G), R23.2
/U3_FLT_ISO: Q7.3 (D), R17.1
/U3_FLT_N: Q5.1 (G), R6.2, R15.1, U3.9 (~FLT)
/U3_VBIAS: C8.1, U3.3 (VBIAS)
/U5_FLT_N: R18.1, U5.9 (~FLT)
/U5_VBIAS: C10.1, U5.3 (VBIAS)
/USB3-0-D_N: J2.A7 (DN1), J2.B7 (DN2), J3.11, U3.19 (D2)
/USB3-0-D_P: J2.A6 (DP1), J2.B6 (DP2), J3.10, U3.20 (D1)
/USB3-1-D_N: J1.A7 (DN1), J1.B7 (DN2), J3.14, U5.19 (D2)
/USB3-1-D_P: J1.A6 (DP1), J1.B6 (DP2), J3.13, U5.20 (D1)
/USBL_J1_EN: J3.8, R21.2
/USBL_J1_FAULT_N: J3.4, R19.2
/USBL_J1_UFP_N: J3.7, R20.2
/USBL_PD_PG_N: J3.1, R16.2
/USBL_U3_FLT_N: J3.2, R17.2
/USBL_U5_FLT_N: J3.3, R18.2
/VBUS_PD: C15.1, C16.1, C17.1, D7.4 (VDD/IO), D7.5 (VDD/IO), D7.6 (VDD/IO), J5.1, J5.2, J5.3, J5.4, J5.5, Q2.5 (D), Q2.6 (D), Q2.7 (D), Q2.8 (D)

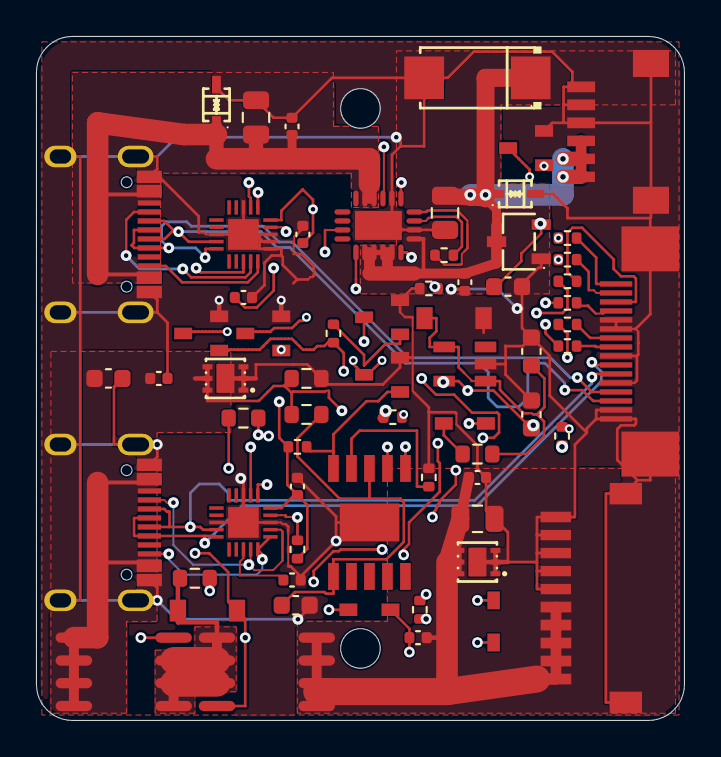
[picture p42: board thin-laptop-cm5-usb_left.kicad_pcb from above]

Board: 4 copper layers, 36.0 x 38.0 mm, 67 parts (0 on the bottom side), 49 nets.

Other parts of the board:
H1, H2: MountingHole_2.2mm_M2
