CopperPilot/laptop/design/spec.yaml

schema_version: rea-hardware/spec/v1
product:
  slug: thin-laptop-cm5
  name: 13-inch Thin Aluminum CM5 Laptop
  summary: 13-inch thin CNC aluminum laptop powered by Raspberry Pi Compute Module 5 with scissor keyboard, multi-touch trackpad, 2S2P 7.4V 9,000mAh (66.6Wh) Li-Po battery pack (four identical LP4466104 cells contoured around and under the trackpad), dual left USB-C ports (45-65W 20V PD charging via CH224A + BQ25798RQMR 2S NVDC buck-boost charger and TPS56628DDAR 5V/6A synchronous buck converter), right 3.5mm audio jack, stereo speakers, mic, lid Hall sensor, and 1080p MIPI webcam
  category: laptop
inputs:
  images:
  - inputs/board_in_hand.jpg
  - inputs/keyboard_top.jpg
  - inputs/logic_board.jpg
  - inputs/open_side.jpg
  - inputs/teardown_exploded.jpg
  - inputs/teardown_shells.jpg
  prompt: inputs/prompt.md
view:
  up:
  - 0
  - 1
  - 0
  front:
  - 0
  - 0
  - 1
envelope:
  width_mm: 297.5
  height_mm: 206.4
  depth_mm: 12.7
  corner_radius_mm: 10.0
  derivation: Published 13-inch thin laptop exterior dimensions 297.5 x 206.4 x 12.7 mm (8.6 mm base + 4.1 mm lid), verified with rea-hw measure on teardown_exploded.jpg and teardown_shells.jpg
  front_origin_world_mm:
  - -68.75
  - 12.0
  - 11.6
fidelity:
  out_of_scope:
  - proprietary biometric fingerprint sensor inside lock key
  - anodized surface micro-grain texture
  dimensions:
  - name: overall_width
    kind: overall_width
    value_mm: 297.5
    tol_mm: 2.0
    source: Published 13-inch thin laptop specification (297.5 mm width) and rea-hw measure on teardown_exploded.jpg
  - name: overall_height
    kind: overall_height
    value_mm: 206.4
    tol_mm: 2.0
    source: Published 13-inch thin laptop specification (206.4 mm depth)
  - name: overall_depth
    kind: overall_depth
    value_mm: 12.7
    tol_mm: 1.0
    source: Published 13-inch thin laptop specification (12.7 mm closed thickness)
  - name: center_thickness
    kind: center_thickness
    value_mm: 12.7
    tol_mm: 1.0
    source: Flat unibody profile measured in open_side.jpg and teardown_shells.jpg
  - name: edge_thickness
    kind: edge_thickness
    value_mm: 11.5
    tol_mm: 1.5
    source: Radiused bottom edge profile measured 1.5 mm inward from perimeter
  must_match:
  - id: F_DISPLAY
    name: 13-inch IPS display panel
    kind: display
    view: front
    center_mm:
    - 148.75
    - 102.0
    size_mm:
    - 284.0
    - 178.0
    implement: case
    source: photo
    confidence: high
    pose: open
    notes: Active display window inside narrow dark bezel on open lid
  - id: F_WEBCAM
    name: 1080p top-bezel webcam window
    kind: sensor
    view: front
    center_mm:
    - 148.75
    - 196.25
    size_mm:
    - 6.0
    - 4.0
    implement: case
    source: photo
    confidence: high
    pose: open
    notes: Centered in top display bezel above screen (at y=196.25 mm in closed deck frame, swinging to top of lid when open)
  - id: F_KEYBOARD
    name: 78-key scissor-switch keyboard well
    kind: button
    view: front
    center_mm:
    - 148.75
    - 64.0
    size_mm:
    - 270.0
    - 104.0
    implement: case
    source: photo
    confidence: high
    pose: open
    notes: Recessed keyboard well in top deck holding 78-key module (#1..#76 in measure-teardown_exploded.png)
  - id: F_TRACKPAD
    name: Multi-touch glass trackpad surface
    kind: button
    view: front
    center_mm:
    - 148.75
    - 160.0
    size_mm:
    - 120.0
    - 76.0
    implement: case
    source: photo
    confidence: high
    pose: open
    notes: Centered below keyboard (#77 in measure-teardown_exploded.png)
  - id: F_USBC_2
    name: Rear-left USB-C data and 5V accessory port
    kind: port
    view: left
    center_mm:
    - 27.0
    - 8.8
    size_mm:
    - 9.2
    - 3.5
    implement: case
    source: prompt
    confidence: high
    pose: closed
    notes: Left edge rear USB-C port on usb_left daughterboard; mouth faces -X
  - id: F_USBC_1
    name: Front-left USB-C PD 45-65W charging and data port
    kind: port
    view: left
    center_mm:
    - 43.0
    - 8.8
    size_mm:
    - 9.2
    - 3.5
    implement: case
    source: prompt
    confidence: high
    pose: closed
    notes: Left edge front USB-C charging port on usb_left daughterboard (20V @ 2.25A = 45.0W hardware-capped USB-C PD startup from 45-65W adapters negotiated by autonomous CH224A PD sink U1 and switched via common-source AO4407A P-MOSFETs Q1/Q2 + Q4 from /U3_FLT_N into main-board BQ25798RQMR 5A 2S buck-boost NVDC charger with hardware VINDPM for 5V-20V dead-battery startup, hardware ILIM_HIZ=2.25A via R29=78.7k/R30=100k [V_ILIM_HIZ=2.80V] so 45W PD adapters never trip OCP while NVDC battery supplement mode and I2C REG0x14 EN_EXTILIM=0 / REG0x06 IINDPM support peak loads and 60-65W adapters, plus 2-stage 2N7002 open-drain PG telemetry Q3/Q6 on J3.1 /USBL_PD_PG_N); mouth faces -X
  - id: F_AUDIO
    name: Right-edge 3.5mm TRRS headphone jack
    kind: port
    view: right
    center_mm:
    - 35.0
    - 7.5
    size_mm:
    - 6.0
    - 5.2
    implement: case
    source: prompt
    confidence: high
    pose: closed
    notes: Right edge 3.5mm CTIA TRRS audio jack J1 (PJ-3701-SMT C2684645 with isolated NC mechanical Tip plug-detect switch between Pin 5 /TIP_SW and Pin 6 /GND) on audio_right daughterboard with Ring 2 grounded (Kelvin-sensed via C20=2.2uF C159814 placed at [32.30, 12.50] mm with dedicated F.Cu trace directly to J1.2 and R29=1.3k C25866 into /HS_REF_MUX), Pin 5 /TIP_SW pulled up to 2.8V /+2V8_ANA via R30=22k (C25768) + C23=2.2uF (C159814, tau=48.4ms, t_qual=90.1ms) and ESD-clamped by D10 (PESD3V3U1UA,115 C403915) to drive U1 (TLV7041DBVR C702122 with R23=22k/R31=1M 72mV hysteresis, V_TH+=2.365V, V_TH-=2.293V) for active-low mechanical Tip plug detection (/HP_DET_N -> R4=1k -> /HP_DET on J2/J_AUDR pin 7 across Type-B opposite-side contact 8P 0.5mm FFC c_audio_right to dedicated main-board net /HP_DET on CM5 GPIO24 U1 pin 45 with R37=10k pull-up, completely independent of Sleeve mic impedance), while U2 (TLV7041DBVR C702122, IN+ on /V_REF_HI=2.344V, IN- driven directly by U1's debounced /HP_DET_N output) gates /MIC_SEL low whenever unplugged or during the 90.1ms insertion qualification window and releases /MIC_SEL synchronously with /HP_DET_N once a plug is seated; Sleeve (/HS_MIC_DET) is protected by unidirectional 3.3V ESD diode D3 (PESD3V3U1UA,115 C403915 matching D10, clamping negative excursions at -0.7V and positive ESD above 3.3V) and biased from 2.8V ultra-low-noise LDO U5 (LP5907MFX-2.8/NOPB C186700 with local 1uF input cap C22 C52923 within 1.5mm of U5.1/U5.2, 1uF output cap C21 C52923, R24=1.3k C25866 minimum preload bleeder providing 2.58mA total rail sink to prevent back-drive up to >6V on J1.1, and D12 PESD3V3U1UA,115 C403915 shunt clamp on /+2V8_ANA) via RC-filtered R11=470R + C11=10uF (/HS_BIAS) and R1=2.2k CTIA electret mic bias pull-up on /HS_MIC_DET (AC-coupled by C10=2.2uF into R21=220R so R_mic||R1+R21=1.32k matches R29=1.30k on Ring 2, with U4 outputs AC-coupled by C13/C14=2.2uF and R8/R9=100R onto /MIC_P and /MIC_N with symmetrical main-board DC charge bleeders R51=47k and R52=47k C25792 to /GND ahead of C33/C34=2.2uF) alongside non-loading sense filter R12=47k (C25792) + C12=4.7nF (C1538, tau=221us << 90.1ms) and rail-to-rail dual-series silicon clamp D11 (BAV99,215 C2500 to /GND and /+2V8_ANA) on /DET_IN into U3 (TLV7041DBVR C702122, IN- on /V_REF_LO=0.270V from R13=2.2k/R14=10k/R16=1.3k ladder, IN+ /U3_INP via R27=2.2k C25879 and R28=1M C26083 hysteresis to /MIC_SEL with R17=2.2k pull-up, V_TH+=0.283V [300 ohm] and V_TH-=0.121V [120 ohm]) so 3-pole TRS plugs (R_sleeve < 100 ohm, V_U3P <= 0.155V < 0.270V) deterministically hold or reset /MIC_SEL=0V (internal mic MK1) without bistable lockup while 4-pole CTIA headsets (680 ohm <= R_sleeve <= 10k or R_sleeve=inf when booted or plugged in with inline hardware mute switch open) deterministically drive /MIC_SEL=3.3V (external headset mic via TS5A23159DGSR dual SPDT differential mic mux U4 biased at 0.795V /MUX_BIAS_FILT via R18=68k/R19=27k, with R21=220R/R29=1.3k balanced network and matched ultra-low-leakage BAV99,215 C2500 clamps D8 on /HS_MIC_MUX and D9 on /HS_REF_MUX between /GND and /+3V3); mouth faces +X
  - id: F_HALL
    name: Lid closure Hall-effect sensor
    kind: sensor
    view: any
    center_mm:
    - 188.75
    - 44.0
    size_mm:
    - 3.5
    - 3.5
    implement: pcb+case
    source: prompt
    confidence: high
    pose: closed
    notes: Internal DRV5032FADBZR Hall sensor U_HALL on main board at (120.0, 32.0) aligned with lid_magnet seated in a blind pocket inside the lid (between display_panel/display_bezel and lid_shell's continuous outer skin, with no hole through lid_shell's outer skin), driving dedicated active-low /LID_SNS to CM5 GPIO13 (U1 pin 28) with R13=10k pull-up to +3V3
fab:
  profile: jlcpcb
  layers: 4
  thickness_mm: 1.6
  assembly_sides:
  - top
electrical:
  mcu: Raspberry Pi Compute Module 5 (rea_refs:ComputeModule5-CM5)
  power: Front-left USB-C PD 3.0 autonomous sink (CH224A on usb_left, strapped for 20V PD request, 20V @ 2.25-3.25A = 45-65W) -> BQ25798RQMR I2C 5A 1S-4S buck-boost battery charger & NVDC power-path manager (3.6-24V input, charging 2S2P 7.4V nominal [6.0-8.4V] 9,000 mAh / 66.6 Wh Li-Po battery pack at 8.40V via single 8-pin pack connector J_BAT with BATP Kelvin sense and TS 10k NTC sense, regulating NVDC VSYS at 6.0-8.6V) -> TPS56628DDAR 6A synchronous buck converter (4.5-18V input) stepping down 2S VSYS (6.0-8.6V) to +5V (5.06V / 6A continuous) for CM5 +5V inputs, PAM8406DR stereo Class-D speaker amplifier, TLV62569DBVR +3.3V_PER camera/display buck regulator, TPS61165DBVR WLED backlight boost driver, and SY6280AAC / TPS25810RVCR USB-C 5V accessory host power; HT7530S 30V-input 3.0V ultra-low-Iq LDO powers CM5 RTC from always-on 2S VBAT
  blocks:
  - id: cm5_core
    purpose: Raspberry Pi Compute Module 5 (200-pin dual high-density board-to-board footprint rea_refs:Raspberry-Pi-5-Compute-Module), feeding all six +5v_(Input) pins (77,79,81,83,85,87), tying GPIO_VREF (pin 78) to +3.3v_(Output) (pins 84,86), and wiring USB2_P/USB2_N (pins 105/103), USB_OTG_ID (pin 101), PMIC_EN, and nRPIBOOT (pin 93 with top-side SW1 recovery tactile switch) to internal service test pads TP1..TP5 on the top side of the main board (allowing a continuous unperforated bottom_shell)
    key_parts:
    - ComputeModule5-CM5
    - PTS526SM15SMTR2LFS
    reference: https://datasheets.raspberrypi.com/cm5/cm5-datasheet.pdf (Raspberry Pi CM5 Datasheet & CM5IO rev 2 reference)
  - id: power_charger
    purpose: 20V USB-C PD autonomous sink (CH224A on usb_left, 45-65W from 20V / 2.25-3.25A contract) feeding BQ25798RQMR 5A 2S buck-boost NVDC battery charger (3.6-24V input, R_PROG=8.2k for 2S 8.40V @ 750kHz with L1=2.2uH FXL0630-2R2-M, ILIM_HIZ resistor divider setting 3.25A input current limit [65W at 20V], 100R BATP Kelvin sense and 5.23k/30.1k JEITA TS thermistor sense to single 8-pin battery pack header J_BAT S8B-PH-SM4-TB(LF)(SN) protected by 10A fuse F1), TPS56628DDAR 6A synchronous buck converter stepping down 2S VSYS (6.0-8.6V) to +5V (5.06V, R1=124k / R2=22.1k, L2=2.2uH FXL0630-2R2-M), HT7530S 30V-input 3.0V RTC LDO on 2S VBAT, and SY6280AAC high-side switch for USB-C 5V accessory output
    key_parts:
    - CH224A
    - BQ25798RQMR
    - TPS56628DDAR
    - S8B-PH-SM4-TB(LF)(SN)
    - HT7530S
    - SY6280AAC
    reference: https://www.ti.com/lit/ds/symlink/bq25798.pdf (TI BQ25798 1S-4S Buck-Boost Charger & TPS56628 6A Buck Converter standard application circuits)
  - id: display_camera_backlight
    purpose: 22-pin 0.5mm MIPI DSI1 display connector (J_DSI, 4-lane MIPI1_D0..3_P/N + MIPI1_C_P/N + I2C0), TPS61165DBVR constant-current boost LED backlight driver on 2-pin JST-PH (J_BL) dimmed by CM5 GPIO12 PWM, and 22-pin 0.5mm MIPI CSI0 webcam connector (J_CSI, MIPI0_D0..1_P/N + MIPI0_C_P/N + CAM_GPIO0/1 + I2C0) powered by TLV62569DBVR +3.3V_PER buck regulator
    key_parts:
    - FH12-22S-0.5SH(55)
    - TPS61165DBVR
    - TLV62569DBVR
    - S2B-PH-SM4-TB(LF)(SN)
    reference: https://www.ti.com/lit/ds/symlink/tps61165.pdf (TI TPS61165 WLED boost driver reference)
  - id: keyboard_trackpad
    purpose: TCA8418RTWR I2C 8x10 keypad matrix scanner reading all 78 scissor keys via 24-pin 0.5mm FPC connector (J_KB, rows 0..7, cols 0..9, plus power key to CM5 PWR_BUT pin 92) and 8-pin 0.5mm FPC connector (J_TP) carrying I2C1 (GPIO2/GPIO3) + interrupt/reset to capacitive multi-touch trackpad
    key_parts:
    - TCA8418RTWR
    - 05A20L24P
    - FPC-05F-8PH20
    reference: https://www.ti.com/lit/ds/symlink/tca8418.pdf (TI TCA8418 8x10 I2C keypad scan reference)
  - id: audio_subsystem
    purpose: ES8388 low-power I2S stereo codec (connected to CM5 PCM I2S GPIO18..21 and I2C) driving right daughterboard 3.5mm headphone jack (LOUT1/ROUT1 via 8-pin FFC J_AUDR) and PAM8406DR stereo 5W Class-D amplifier (from LOUT2/ROUT2) feeding left and right speaker headers (J_SPKL, J_SPKR), plus differential mic input from ICS-40720 MEMS mic on audio_right
    key_parts:
    - ES8388
    - PAM8406DR
    - S2B-PH-SM4-TB(LF)(SN)
    - FPC-05F-8PH20
    reference: http://www.everest-semi.com/pdf/ES8388%20DS.pdf (Everest ES8388 + Diodes PAM8406 reference)
  - id: usb_left_subboard
    purpose: Left daughterboard (usb_left, single-sided top assembly so bottom_shell is continuous with no through-cutouts) with front-left 45-65W PD charging/data USB-C receptacle (J2, autonomous CH224A 20V PD 3.0 sink controller U1 + TPD6S300RUKR 24V CC/SBU OVP & ESD protector + SMF24A VBUS TVS + RP1 USB3-0-D_P/N) and rear-left accessory USB-C receptacle (J1, TPS25810RVCR 5V DFP controller U2 + TPD6S300RUKR + SMF6.0A + RP1 USB3-1-D_P/N), linked via 16-pin 0.5mm FFC (J3 <-> J_USBL) and high-current wire-to-board headers (J4, J5) to main board
    key_parts:
    - TYPE-C-31-M-12
    - CH224A
    - TPS25810RVCR
    - TPD6S300RUKR
    - 05B20U16P
  - id: audio_right_subboard
    purpose: Right daughterboard (audio_right) with 3.5mm CTIA TRRS headphone/headset jack (J1), ICS-40720 differential analog MEMS microphone (MK1), TLV7041DBVR plug/mic comparators (U1..U3), and TS5A23159DGSR dual SPDT mic mux (U4), linked via 8-pin 0.5mm FFC (J2 <-> J_AUDR) to main board
    key_parts:
    - PJ-320D
    - ICS-40720
    - TLV7041DBVR
    - TS5A23159DGSR
    - FPC-05F-8PH20
  nets_must_connect:
  - - U1.nRPIBOOT
    - SW1.1
  - - U1.USB2_P
    - TP2.1
  - - U1.USB2_N
    - TP3.1
  - - U1.USB3-0-D_P
    - J_USBL.10
  - - U1.USB3-0-D_N
    - J_USBL.11
  - - U1.USB3-1-D_P
    - J_USBL.13
  - - U1.USB3-1-D_N
    - J_USBL.14
  - - U_CHG.SW1
    - L1.1
  - - U_CHG.SW2
    - L1.2
  - - U_BUCK.SW
    - L2.1
  - - U_BL.SW
    - L3.1
  high_speed:
  - name: usb_otg_flash
    board: main
    kind: diff_pairs
    nets:
    - '*USB2_P*'
    - '*USB2_N*'
    tolerance_mm: 1.5
    diff_impedance_ohm: 90.0
    source: 'Raspberry Pi CM5 Datasheet Section 3.3: USB 2.0 90 ohm differential pair'
  - name: usb_host0_port1
    board: main
    kind: diff_pairs
    nets:
    - '*USB3-0-D_P*'
    - '*USB3-0-D_N*'
    tolerance_mm: 1.5
    diff_impedance_ohm: 90.0
    source: 'Raspberry Pi CM5 Datasheet Section 3.4: RP1 USB 2.0 host 90 ohm differential pair'
  - name: usb_host1_port2
    board: main
    kind: diff_pairs
    nets:
    - '*USB3-1-D_P*'
    - '*USB3-1-D_N*'
    tolerance_mm: 1.5
    diff_impedance_ohm: 90.0
    source: 'Raspberry Pi CM5 Datasheet Section 3.4: RP1 USB 2.0 host 90 ohm differential pair'
  - name: mipi_dsi1_display
    board: main
    kind: diff_pairs
    nets:
    - '*MIPI1_C_P*'
    - '*MIPI1_C_N*'
    - '*MIPI1_D0_P*'
    - '*MIPI1_D0_N*'
    - '*MIPI1_D1_P*'
    - '*MIPI1_D1_N*'
    - '*MIPI1_D2_P*'
    - '*MIPI1_D2_N*'
    - '*MIPI1_D3_P*'
    - '*MIPI1_D3_N*'
    tolerance_mm: 1.0
    diff_impedance_ohm: 100.0
    source: 'Raspberry Pi CM5 Datasheet Section 3.7: MIPI D-PHY 100 ohm differential pairs'
  - name: mipi_csi0_camera
    board: main
    kind: diff_pairs
    nets:
    - '*MIPI0_C_P*'
    - '*MIPI0_C_N*'
    - '*MIPI0_D0_P*'
    - '*MIPI0_D0_N*'
    - '*MIPI0_D1_P*'
    - '*MIPI0_D1_N*'
    tolerance_mm: 1.0
    diff_impedance_ohm: 100.0
    source: 'Raspberry Pi CM5 Datasheet Section 3.7: MIPI D-PHY 100 ohm differential pairs'
board:
  width_mm: 160.0
  height_mm: 44.0
  corner_radius_mm: 2.0
  mounting_holes:
  - x_mm: 4.0
    y_mm: 10.0
    drill_mm: 2.2
    plated: true
  - x_mm: 4.0
    y_mm: 34.0
    drill_mm: 2.2
    plated: true
  - x_mm: 156.0
    y_mm: 10.0
    drill_mm: 2.2
    plated: true
  - x_mm: 156.0
    y_mm: 34.0
    drill_mm: 2.2
    plated: true
  placement:
  - ref: U1
    role: cm5_module_socket
    side: top
    x_mm: 56.0
    y_mm: 5.5
    rot_deg: 270
    tolerance_mm: 1.0
  - ref: J_DSI
    role: display_mipi_ffc
    side: top
    x_mm: 24.0
    y_mm: 2.2
    rot_deg: 180
    tolerance_mm: 1.0
  - ref: J_BL
    role: display_backlight_conn
    side: top
    x_mm: 42.0
    y_mm: 2.5
    rot_deg: 180
    tolerance_mm: 1.0
  - ref: J_CSI
    role: camera_mipi_ffc
    side: top
    x_mm: 136.0
    y_mm: 2.2
    rot_deg: 180
    tolerance_mm: 1.0
  - ref: J_USBL
    role: usb_left_ffc
    side: top
    x_mm: 2.0
    y_mm: 22.0
    rot_deg: 270
    tolerance_mm: 1.0
  - ref: J_AUDR
    role: audio_right_ffc
    side: top
    x_mm: 158.0
    y_mm: 22.0
    rot_deg: 90
    tolerance_mm: 1.0
  - ref: J_SPKL
    role: speaker_left_conn
    side: top
    x_mm: 10.0
    y_mm: 41.5
    rot_deg: 0
    tolerance_mm: 1.0
  - ref: J_BAT
    role: battery_pack_conn
    side: top
    x_mm: 24.5
    y_mm: 41.0
    rot_deg: 0
    tolerance_mm: 1.5
  - ref: J_KB
    role: keyboard_fpc
    side: top
    x_mm: 43.0
    y_mm: 41.8
    rot_deg: 0
    tolerance_mm: 1.0
  - ref: J_TP
    role: trackpad_fpc
    side: top
    x_mm: 114.0
    y_mm: 41.8
    rot_deg: 0
    tolerance_mm: 1.0
  - ref: J_SPKR
    role: speaker_right_conn
    side: top
    x_mm: 148.0
    y_mm: 41.5
    rot_deg: 0
    tolerance_mm: 1.0
  - ref: U_HALL
    role: hall_lid_sensor
    side: top
    x_mm: 120.0
    y_mm: 32.0
    rot_deg: 0
    feature: F_HALL
    tolerance_mm: 1.0
  - ref: SW1
    role: rpiboot_button
    side: top
    x_mm: 125.0
    y_mm: 22.0
    rot_deg: 0
    tolerance_mm: 2.0
  max_component_height_mm:
    top: 5.5
    bottom: 0.5
sub_boards:
- id: usb_left
  name: Left Dual USB-C PD & Data Daughter Board
  layers: 4
  width_mm: 36.0
  height_mm: 38.0
  corner_radius_mm: 2.0
  world_position_mm:
  - -66.5
  - -4.0
  - 0.0
  world_rotation_deg:
  - 0.0
  - 0.0
  - 0.0
  mounting_holes:
  - x_mm: 18.0
    y_mm: 4.0
    drill_mm: 2.2
    plated: true
  - x_mm: 18.0
    y_mm: 34.0
    drill_mm: 2.2
    plated: true
  placement:
  - ref: J1
    role: usbc_data_5v_port
    side: top
    x_mm: 3.5
    y_mm: 11.0
    rot_deg: 270
    feature: F_USBC_2
    tolerance_mm: 1.0
  - ref: J2
    role: usbc_pd_charge_port
    side: top
    x_mm: 3.5
    y_mm: 27.0
    rot_deg: 270
    feature: F_USBC_1
    tolerance_mm: 1.0
  - ref: U1
    role: usb_pd_sink_controller
    side: top
    x_mm: 18.0
    y_mm: 27.0
    rot_deg: 0
    tolerance_mm: 2.0
  - ref: J3
    role: main_board_ffc
    side: top
    x_mm: 34.0
    y_mm: 18.0
    rot_deg: 90
    tolerance_mm: 1.0
  max_component_height_mm:
    top: 4.0
    bottom: 0.5
- id: audio_right
  name: Right Headphone & Microphone Daughter Board
  layers: 2
  width_mm: 36.0
  height_mm: 38.0
  corner_radius_mm: 2.0
  world_position_mm:
  - 190.5
  - -4.0
  - 0.0
  world_rotation_deg:
  - 0.0
  - 0.0
  - 0.0
  mounting_holes:
  - x_mm: 18.0
    y_mm: 4.0
    drill_mm: 2.2
    plated: true
  - x_mm: 18.0
    y_mm: 34.0
    drill_mm: 2.2
    plated: true
  placement:
  - ref: J1
    role: headphone_jack
    side: top
    x_mm: 28.5
    y_mm: 19.0
    rot_deg: 180
    feature: F_AUDIO
    tolerance_mm: 1.0
  - ref: MK1
    role: microphone
    side: top
    x_mm: 18.0
    y_mm: 10.0
    rot_deg: 0
    tolerance_mm: 1.0
  - ref: J2
    role: main_board_ffc
    side: top
    x_mm: 2.0
    y_mm: 18.0
    rot_deg: 270
    tolerance_mm: 1.0
  max_component_height_mm:
    top: 5.5
    bottom: 0.5
bom:
- refs:
  - U1
  role: cm5_socket
  mpn: DF40C-100DS-0.4V(51)
  lcsc: C597931
  footprint: rea_refs:Raspberry-Pi-5-Compute-Module
  description: Raspberry Pi Compute Module 5 dual 100-pin high-density board-to-board footprint
- refs:
  - U_CHG
  role: battery_charger
  mpn: BQ25798RQMR
  lcsc: C2876593
  footprint: lcsc:QFN-29_L4.0-W4.0-P0.40-TL-BQ25792RQMR
  description: 'I2C 5A 1S-4S buck-boost battery charger and NVDC power-path manager (3.6-24V operating input, 26V internal VBUS_OVP, charging 2S2P 7.4V nominal [6.0-8.4V] 9,000mAh Li-Po pack at VREG=8.40V with up to 5A charge current from 20V / 2.25A-3.25A [45W hardware-capped via ILIM_HIZ at startup for 45-65W adapter compatibility, I2C-programmable up to 60-65W] USB-C PD input): VAC1 (pin 9, /CHG_VAC1, locally decoupled by C96=100nF 50V X7R 0402 C307331 to /GND) connected via R74=10R 1% (C25077) low-drop series resistor to /VBUS_PD (with D+ pin 6 and D- pin 7 shorted together on /CHG_DP_DM) (clamped by low-clamping 22V-standoff / 27.7V-clamping surge TVS D7 TVS2200DRVR C2875234 and decoupled by 100nF 50V C2) and switched into VBUS/VAC2 (pins 2/3/8, /CHG_VBUS, decoupled by 2x 10uF 50V 0805 + 100nF 50V 0402) via external back-to-back 40V 6.3A N-MOSFETs Q3 and Q4 (2x SQ2318AES-T1_BE3 C2847989, gates on /CHG_ACDRV1_G and common sources on /CHG_AC_SRC, protected and slewed between /CHG_ACDRV1_G and /CHG_AC_SRC by 12V Zener clamp D15=BZT52C12 C173429, and gate capacitor C89=470pF 50V C1537) driven by ACDRV1 (pin 11, /CHG_ACDRV1 via series gate resistor R69=100R 1% C25076, with ACDRV2 pin 10 tied to GND) to actively disconnect VBUS above 26V, PMID (pin 29) decoupled by 3x 10uF 50V 0805 + 100nF 50V 0402, L1=2.2uH 10A shielded inductor (FXL0630-2R2-M C167218) between SW1 (pin 28) and SW2 (pin 26) with 47nF 50V 0402 bootstrap caps on BTST1 (pin 4) and BTST2 (pin 19), PROG (pin 20) strapped with R_PROG=8.2k 1% (C25981) to GND for 2S cell count (8.4V VREG, 7.0V VSYSMIN) and 750kHz switching frequency, ILIM_HIZ (pin 17, /CHG_ILIM) biased from REGN (pin 5, decoupled by 4.7uF 50V 0603 C29823) via R29=78.7k 1% (FRC0402F7872TS C2998104) top / R30=100k 1% (C25741) bottom divider setting V_ILIM_HIZ=2.80V (I_INDPM=2.25A -> 45.0W hardware input limit at 20V [42.3W to /VSYS at 94% efficiency] so 45W [20V @ 2.25A] USB-C PD adapters never trip OCP during DCP startup or combined load with standalone CH224A U1, while NVDC battery supplement mode automatically supplies transient peak /VSYS loads above 42.3W from the 2S2P battery and host firmware can clear REG0x14 EN_EXTILIM=0 over I2C to raise IINDPM up to 3.00A [60W] on 60-65W adapters, while usb_left Q4 2N7002 enables Q1/Q2 autonomously from /U3_FLT_N across 5V-20V so BQ25798RQMR hardware VINDPM [4.3V floor at 5V, V_VBUS0-1.4V at 12V-20V] regulates <20V USB-C adapters during dead-battery startup without adapter collapse and U_CHG immediately detects VBUS attachment [asserting /CHG_INT_N and reading VBUS_ADC over I2C] alongside non-inverting 2-stage 2N7002 open-drain PG telemetry Q3/Q6 on J3.1 /USBL_PD_PG_N [via R16=1k C11702 pulled up to /J1_VDD_3V3 by R25=10k C25744]), ~QON (pin 12, left unconnected with internal ~200k pull-up to V_PULL holding ~QON high per BQ25798 Section 8.3.9.2 since no external SDRV Ship FET is populated [POR default SFET_PRESENT=0], preventing long >=10s presses on J_KB pin 19 /PWR_BUT from triggering unintended BQ25798 10s System Power Reset / HIZ mode while D16 1N4148WS C2128 [Anode on /CM5_PWR_BUT U1 pin 92, Cathode on /PWR_BUT] isolates the keyboard power key), BAT (pins 22/23) decoupled by 2x 10uF 50V 0805 and routed via 8A SMD fuse F1 (JFC1206-1800FS C136353) to 9-pin JST-PH J_BAT (S9B-PH-SM4-TB(LF)(SN) C495694: pins 1..4 /VBAT_PACK [8.0A rating], pin 5 /CHG_TS, pins 6..9 + tabs 10..11 /GND [8.0A continuous return rating matching 8A fuse F1, with unmated J_BAT2 removed]), BATP (pin 18, /CHG_BATP) connected via R50=100R 1% (C25076) Kelvin sense resistor to the fused /VBAT side of F1 (preventing R50 overload if F1 opens), TS (pin 16, /CHG_TS) biased from REGN via R23=5.23k 1% (C11631) / R42=30.1k 1% (C29402) JEITA divider to J_BAT pin 5 (10k NTC in pack) and clamped by unidirectional 5.0V ESD diode D19 (PESD5V0S1UA,115 C179414), SDRV (pin 24) decoupled by 1nF 50V 0402 (C1523) to GND, CE (pin 13) pulled low to GND, and SYS (pin 25) decoupled by 5x 10uF 50V 0805 + 100nF 0402 feeding /VSYS (6.5-8.6V)'
- refs:
  - U_BUCK
  role: buck_5v
  mpn: TPS56628DDAR
  lcsc: C485522
  footprint: lcsc:SOIC-8_L4.9-W3.9-P1.27-LS6.0-BL-EP
  description: 'Dual 6A synchronous step-down (buck) converter architecture (U_BUCK and U_BUCK2, 2x TPS56628DDAR C485522, 12A total 5V capacity from 2S /VSYS 6.5-8.6V): U_BUCK steps down /VSYS (decoupled by 2x 22uF 25V X5R 0805 C45783 + 100nF 0402 C307331, EN pin 1 on /BUCK_EN driven by wide-input precision voltage supervisor U_UVLO (TPS3700DDCR C33002 on /VSYS decoupled by C93=100nF C307331, INA+ pin 3 on /VSYS_UVLO sensed via R33=82k 1% C4142 / R34=5.1k 1% C25905 divider with R81=1M 1% C26083 hysteresis feedback from /BUCK_EN setting V_UVLO_RISE=6.866V and V_UVLO_FALL=6.610V, open-drain OUTA pin 1 driving /BUCK_EN with 5.5V-safe pull-up divider R67=100k C25741 to /VSYS and R68=47k C25792 to /GND, and INB- pin 4 on /VSYS_THROT sensed via co-located R88=80.6k 1% 0402WGF8062TCE C25798 to /VSYS and R89=4.7k 1% 0402WGF4701TCE C25900 to /GND with positive-feedback hysteresis resistor R97=100k 1% C25741 to /VSYS_THROT_HYS switched to /GND by N-MOSFET Q6 BSS138 C52895 [Gate on /VBUS_ISET_HI, Source on /GND, Drain on /VSYS_THROT_HYS, setting V_THROT_FALL=7.160V typ / 7.060V min and V_THROT_RISE=7.582V typ / 7.487V min with 422mV hysteresis] driving open-drain OUTB pin 6 on /VBUS_ISET_HI) and switching /BUCK_EN cleanly between 0.005V (<<0.6V V_IL(max)) and 2.03-2.75V (>1.6V V_IH(min), <<5.5V V_EN(max)), VREG5 pin 3 decoupled by 1uF C52923 with 100k pull-up to PG, L2=2.2uH 10A FXL0630-2R2-M C167218, R27=137k C32298 / R28=24k C25769 setting V_OUT=5.13V (ensuring /+5V_CM5 >= 4.80V after Q1/Q2 drop at 5.0A peak load), 3x 22uF 25V 0805 C45783 + 100nF output filter, and 5.5V-standoff TVS D3 TSD05CDYFR C20611048) to /+5V (5.00V, 6A continuous) supplying CM5 /+5V_CM5 (via back-to-back common-source AO4407A P-MOSFETs Q1/Q2 C2841482 gated on /DBG_GATE by 2N7002 N-MOSFET Q_DBG C8545 [Gate on /BUCK_PG, Source on /GND, Drain on /DBG_EN_D] via series gate resistor R84=1k 1% 0402WGF1001TCE C11702 with R59=10k 1% 0402WGF1002TCE C25744 pull-up to common source /DBG_Q_SRC [so |V_GS|=4.66V > 4.50V when /BUCK_PG is high and fast tau_off = R59*2*C_iss = 41.2us turn-off prevents /DBG_PWR back-feeding /+5V when /BUCK_PG is low] and diode-isolated Miller soft-start network C98=10nF 50V X7R 0402 C15195 [Pin 1 on /+5V_CM5, Pin 2 on /DBG_MILLER] + blocking diode D39=1N4148WS C2128 [Anode on /DBG_MILLER, Cathode on /DBG_GATE] + pre-charge resistor R94=22k 1% 0402WGF2202TCE C25768 from /DBG_Q_SRC to /DBG_MILLER [reverse-biasing D39 during U_BUCK 1.0ms soft-start while /BUCK_PG is low so C98 cannot pull /DBG_GATE low or turn Q1/Q2 on prematurely, then slewing Q1/Q2 turn-on over ~0.4-0.6ms within C100=220nF 1.07ms U_DBG holdover window when /BUCK_PG asserts], in parallel with U_DBG TPS2117DRLR C22399676 with VIN1 pin 3 and MODE pin 5 tied to /GND, Secondary input VIN2 pin 6 tied to TP1 /DBG_PWR [decoupled by USB 2.0 compliant C88=4.7uF 16V X5R 0603 C19666 <= 10uF max], PR1 pin 4 on /DBG_PR1 driven from /BUCK_PG via R58=10k C25744 / R7=30k C25776 divider with C100=220nF 16V X7R 0402 (CL05B224KO5NNNC C16772) RC delay filter to /GND [tau = (20k||30k)*220nF = 2.64ms >= 1ms, delaying V(/DBG_PR1) crossing 1.0V V_REF by 1.07ms after /BUCK_PG rises so U_DBG remains conducting across the ~300-500us Q1/Q2 Miller soft-start ramp until /+5V_CM5 rises above /DBG_PWR for zero-brownout switchover, and then holding U_DBG in Hi-Z shutdown while /BUCK_PG is high], and ST pin 8 left open, reserving U_BUCK exclusively for the 5.0A peak CM5 load with 16.7% continuous headroom); U_BUCK2 steps down /VSYS (decoupled by 2x 22uF 25V 0805 C69/C79 + 100nF C81, EN pin 1 gated directly by CM5 switched /+3V3 rail [actively discharged by CM5 PMIC and R63=100k C25741 bleeder to /GND so U_BUCK2 and all /+5V_PER and /+3V3_PER peripheral loads shut down completely when CM5 halts], L5=2.2uH 10A FXL0630-2R2-M C167218, R64=133k C25753 / R65=24k C25769 setting V_OUT=5.00V with 22pF C84, 3x 22uF 25V 0805 C85..C87 + 100nF C78 output filter, and unidirectional 5.0V low-clamping TVS D18 PSD05-LF-T7 C139296) to dedicated peripheral rail /+5V_PER (5.00V, 6A continuous, 2.43A-2.78A total peak load for >53% continuous headroom) powering U_AMP (PAM8406DR), U_3V3 (TLV62569DBVR), and U_VBUS (SY6280AAC C55136, IN pin 5 on /+5V_PER decoupled by C18=100nF, OUT pin 1 switching dedicated net /+5V_USBC to J4 pins 1..3 decoupled by C19=10uF and clamped by unidirectional 5.0V low-clamping TVS D2 PSD05-LF-T7 C139296, ISET pin 3 on /USB_ISET with fixed R31=3.6k 1% (0402WGF3601TCE C25891) to /GND [setting I_LIM=1.89A typ <= 2.0A SY6280AAC continuous rating], and EN pin 4 on /USBL_J1_EN driven by CM5 VBUS_EN U1 pin 111 (/CM5_VBUS_EN) via R91=10k 1% C25744 series resistor with R8=100k 1% C25741 pull-down to /GND and gated low below V_THROT_FALL=7.160V typ / 7.060V min [V_THROT_RISE=7.582V typ / 7.487V min, 422mV hysteresis via co-located R88=80.6k 0402WGF8062TCE C25798 / R89=4.7k 0402WGF4701TCE C25900 on U_UVLO INB- with R97=100k C25741 switched to /GND on /VSYS_THROT_HYS by Q6 BSS138 C52895] by N-MOSFET Q5 [BSS138 C52895, Gate on U_UVLO OUTB /VBUS_ISET_HI pulled up to /+3V3 by R90=47k 0402WGF4702TCE C25792] so the 1.5A USB-C accessory load is cleanly shed before VSYS approaches 6.61V UVLO cutoff, keeping worst-case 2S battery discharge current <= 5.35A <= 6.0A BQ25798RQMR continuous BATFET rating)'
- refs:
  - J_BAT
  role: battery_pack_conn_8p
  mpn: S8B-PH-SM4-TB(LF)(SN)
  lcsc: C265121
  footprint: lcsc:CONN-SMD_8P-P2.00_S8B-PH-SM4-TB-LF-SN
  description: '9-pin 2.0mm pitch right-angle SMD JST-PH battery pack connector S9B-PH-SM4-TB(LF)(SN) (C495694, footprint lcsc:CONN-SMD_9P-P2.50_S9B-PH-SM4-TB at [24.50, 40.75] mm: pins 1..4 parallel VBAT+ on /VBAT_PACK [4x 2.0A = 8.0A continuous rating] protected by 8A 1206 SMD fuse F1 [JFC1206-1800FS C136353] into /VBAT protected by unidirectional 12V TVS / reverse-polarity crowbar rectifier D24 [SMF12A C123800 across /VBAT and /GND after F1] with R50=100R C25076 Kelvin sense connected to fused /VBAT side of F1 into U_CHG pin 18 BATP, pin 5 TS 10k NTC thermistor sense on /BAT_TS routed via R87=100R 1% 0402 [0402WGF1000TCE C25076] series current-limiting resistor to /CHG_TS [U_CHG pin 16 and unidirectional 5.0V ESD diode D19 PESD5V0S1UA,115 C179414], pins 6..9 parallel GND [4x 2.0A = 8.0A continuous return rating, plus solder tabs 10..11 on /GND] matching the 8.0A supply rating and 8A fuse F1 in a single mated connector with unmated J_BAT2 removed)'
- refs:
  - U_RTC
  role: rtc_ldo_3v0
  mpn: HT7530S
  lcsc: C347214
  footprint: lcsc:SOT-23_L2.9-W1.6-P1.90-LS2.8-BR
  description: 30V-input 3.0V 100mA ultra-low-quiescent-current (2uA) CMOS LDO regulator powered from always-on 2S /VBAT (6.0-8.4V) via low-leakage silicon switching diode D37 (1N4148WS C2128, I_R <= 25nA) onto /RTC_VIN (locally decoupled directly at U_RTC pin 3 VIN by C57=1uF 50V 0603 CL10A105KB8NNNC C15849, with C58=1uF output capacitor on /RTC_3V0) supplying CM5 PMIC_BAT_V (/RTC_3V0)
- refs:
  - U_VBUS
  role: vbus_switch
  mpn: SY6280AAC
  lcsc: C55136
  footprint: lcsc:SOT-23-5_L3.0-W1.7-P0.95-LS2.8-BL
  description: High-side USB 5V power distribution switch (SY6280AAC C55136) switching main-board /+5V_PER (from 6A U_BUCK2, IN pin 5 decoupled by C18=100nF C307331) onto dedicated net /+5V_USBC (OUT pin 1, decoupled by C19=10uF C440198, clamped by unidirectional 5.0V low-clamping TVS D2 PSD05-LF-T7 C139296, and feeding J4 pins 1..3 [3.0A 3-pin harness rating] into usb_left), with ISET (pin 3, /USB_ISET) programmed by fixed R31=3.6k 1% (0402WGF3601TCE C25891) to /GND (setting I_LIM=1.89A typ [1.51A min to 2.27A max], within SY6280AAC 2.0A continuous rating and 3.0A J4 rating), and active-high EN (pin 4) on /USBL_J1_EN driven by CM5 VBUS_EN (U1 pin 111, /CM5_VBUS_EN) via R91=10k 1% (0402WGF1002TCE C25744) series resistor with R8=100k 1% (0402WGF1003TCE C25741) pull-down to /GND and gated low when VSYS drops below V_THROT_FALL=7.160V typ / 7.060V min (V_THROT_RISE=7.582V typ / 7.487V min with 422mV positive-feedback hysteresis, sensed by U_UVLO INB- pin 4 on /VSYS_THROT via co-located R88=80.6k 0402WGF8062TCE C25798 to /VSYS and R89=4.7k 0402WGF4701TCE C25900 to /GND with R97=100k C25741 on /VSYS_THROT_HYS switched to /GND by Q6 BSS138 C52895) by low-battery load-shedding N-MOSFET Q5 (BSS138 C52895, Gate on U_UVLO open-drain OUTB pin 6 /VBUS_ISET_HI pulled up to /+3V3 via R90=47k 0402WGF4702TCE C25792, Source on /GND, Drain on /USBL_J1_EN) so both U_VBUS and usb_left U2 TPS25810RVCR cleanly shed the 1.5A USB-C accessory load before VSYS reaches 6.61V UVLO cutoff, keeping worst-case 2S battery discharge current <= 5.35A <= 6.0A BQ25798RQMR continuous BATFET rating, with C1=150uF (T520C157M010ATE055 C600588) + C19=10uF (GRM21BR61H106KE43L C440198) + C2=100nF (C307331) = 160.1uF >= 120uF cSrcPwr bulk capacitance on U2.IN (/+5V_USBC) and only C3=10uF 50V X5R 0805 (GRM21BR61H106KE43L C440198) + C4=100nF (C307331) = 10.1uF on switched U2.OUT (/J1_VBUS, C18 removed) so U2's 500 ohm internal discharge resistor discharges /J1_VBUS below vSafe0V (0.8V) in ~9.3ms typ / 13.7ms max (< tW_DCHG = 39-106ms and << tVBUSOFF = 650ms)
- refs:
  - U_BL
  role: backlight_driver
  mpn: TPS61165DBVR
  lcsc: C58756
  footprint: lcsc:SOT-23-6_L2.9-W1.6-P0.95-LS2.8-BR
  description: 38V constant-current white LED boost driver with PWM dimming, powered directly from 2S /VSYS (6.0-8.6V) on /VSYS_BL via 1A 32V 0603 fuse F6 (CFS06V3T1R0 C163118 -> /VSYS_BL_SW) and high-side P-MOSFET load switch Q_BL (AO3401A C15127, gated on /BL_SW_G by Q_BL_EN 2N7002 C8545 from /+3V3 via R80=100k C25741 series gate resistor on /BL_EN_D with R35=100k pull-up across Q_BL Gate /BL_SW_G and Q_BL Source /VSYS_BL_SW downstream of F6, R63=100k pull-down on /+3V3, and C92=10nF 50V C15195 Miller soft-start capacitor to /VSYS_BL limiting C20=10uF inrush to ~60mA, reducing peak switch current to ~0.62A well below the 0.96A minimum switch limit and offloading 0.74A from /+5V), with C21=220nF 16V X7R 0402 (CL05B224KO5NNNC C16772) COMP loop compensation capacitor on pin 5 (/BL_COMP), R32=1.5R 0603 (C22769, setting 133.3mA / ~3.2W WLED current for LP130WQ1-MIPI-22P), R93=10k 1% 0402 (C25744) series current-limiting resistor from /LED_CATHODE to pin 6 FB (/BL_FB) clamped by local 5.1V Zener diode D38=BZT52C5V1S (C173436) to /GND, D35=ESTVS3300DRVR (C42400190, unidirectional 33V flat-clamping TVS with V_CL=38V typ / 39.8V max < 40V SW rating) on /LED_ANODE, D36=PESD36VS1UJX (C5205187, 36V unidirectional ESD diode surviving anode-to-cathode short faults) on /LED_CATHODE, and D1=B16WS 60V 1A SOD-323 Schottky catch diode (C364278, >=1.5x margin over 38V-40V open-LED OVP)
- refs:
  - U_KB
  role: keyboard_scanner
  mpn: TCA8418RTWR
  lcsc: C138713
  footprint: lcsc:WQFN-24_L4.0-W4.0-P0.50-TL-EP2.5
  description: I2C 8x10 keypad matrix controller scanning all 78 laptop keys
- refs:
  - U_CODEC
  role: audio_codec
  mpn: ES8388
  lcsc: C365736
  footprint: lcsc:QFN-28_L4.0-W4.0-P0.45-BL-EP
  description: Low-power I2S stereo audio codec with headphone driver (LOUT1/ROUT1 AC-coupled via C29+C52=200uF on /HP_L_AC and C30+C53=200uF on /HP_R_AC [4x 100uF 6.3V X5R 0805 GRM21BR60J107ME15L C141660] followed by R61=10R and R62=10R 0402 C25077 series isolation resistors and D10/D11 PESD5V0S1BA C2827694 ESD clamps on /HP_L and /HP_R at J_AUDR), differential mic preamp on LIN1/RIN1 AC-coupled via C33=2.2uF and C34=2.2uF C159814 from /MIC_P and /MIC_N (with symmetrical R51=47k 1% 0402 [0402WGF4702TCE C25792] from /MIC_P to /GND and R52=47k 1% 0402 [0402WGF4702TCE C25792] from /MIC_N to /GND populated at [134.72, 18.82] mm and [134.30, 17.40] mm on the connector side of C33/C34 as matched high-impedance DC charge bleeders with only 0.26 dB signal attenuation and zero MICBIAS noise injection, while pin 25 MICBIAS /CODEC_MICBIAS is decoupled to /GND by C51=4.7uF 0603 C19666, plus D12/D13 PESD5V0S1BA ESD clamps on /MIC_P and /MIC_N, while audio_right AC-couples U4 TS5A23159DGSR mux outputs via C13/C14=2.2uF + R8/R9=100R and biases J1.1 /HS_MIC_DET via R11=470R + C11=10uF + R1=2.2k from /+2V8_ANA; unused LIN2/RIN2 pins 21/22 left open so internal VMID bias is unloaded), MCLK driven from CM5 GPIO4 (GPCLK0, U1 pin 54) via R36=22R damping resistor, and analog supplies AVDD/HPVDD (pins 17, 16) isolated on /CODEC_AVDD via R49=4.7R + C49=10uF + C50=100nF low-pass RC filter
- refs:
  - U_AMP
  role: speaker_amp
  mpn: PAM8406DR
  lcsc: C86270
  footprint: lcsc:SOIC-16_L9.9-W3.9-P1.27-LS6.0-BL
  description: Stereo Class-D speaker amplifier powered from /+5V_PER (PVDDL/PVDDR/VDD decoupled by C35=10uF + C36=100nF) with R72=150k and R73=150k 1% 0402 (0402WGF1503TCE C25755) input resistors placed immediately adjacent to virtual-ground summing pins 7 and 10 (INL/INR, setting differential BTL closed-loop gain AV = 2*142k/150k = 1.89 V/V [+5.54dB] to cap full-scale speaker power at 2x 0.90W = 1.80W out / 2.05W in so low-battery peak discharge current stays within U_CHG 6.0A continuous internal BATFET rating), Pin 9 (MODE, /AMP_MODE) pulled High via R71=10k (0402, C25744) to enable ~88-90% high-efficiency Class-D modulation, hardware shutdown/mute on /AMP_SHDN_N from CM5 GPIO16 (U1 pin 29) with R17=10k pull-down, and EMI ferrite-bead/capacitor filters on all 4 speaker outputs (/AMP_OUTL_P/N and /AMP_OUTR_P/N via 4x BLM18PG121SN1D 120R@100MHz 2A 50mOhm 0603 ferrite beads FB1..FB4 [C14709] and 4x 1nF 50V X7R 0402 shunt capacitors C60..C63 [C1523] on /SPKL_P/N and /SPKR_P/N)
- refs:
  - J_DSI
  - J_CSI
  role: mipi_ffc_22p
  mpn: FH12-22S-0.5SH(55)
  lcsc: C597981
  footprint: lcsc:FPC-SMD_22P-P0.50_FH12-22S-0.5SH-55
  description: 22-pin 0.5mm pitch right-angle FFC connector for MIPI DSI1 display (with J_DSI pin 17 /DSI_RST_N wired to CM5 GPIO7 U1 pin 37 + R55=10k pull-down, J_DSI pin 18 /DSI_EN wired to CM5 GPIO8 U1 pin 39 + R56=10k pull-down, and J_DSI pins 20/21 moved off reserved CM5 HAT EEPROM pins /ID_SC and /ID_SD [U1 pins 35/36 left unconnected] onto isolated camera/display bus /SCL0_PER and /SDA0_PER alongside J_CSI pins 20/21, isolated from CM5 always-on 1.8k pull-ups on /SCL0 [U1.80] and /SDA0 [U1.82] by dual BSS138 N-MOSFET pass switches Q_I2C1 and Q_I2C2 [2x BSS138 C52895, Gates on /+3V3_PER, Sources on /SCL0_PER and /SDA0_PER, Drains on /SCL0 and /SDA0 so body diodes block back-drive when /+3V3_PER=0V] with pull-ups R9=2.2k and R10=2.2k [C25879] on /SCL0_PER and /SDA0_PER referenced to switched /+3V3_PER) and CSI0 camera (with GPCLK-capable U1 pin 97 [RP1 GPIO34] routed on /CAM_GPIO0_SRC via R53=22R C25092 series source termination placed within 1.5mm of U1.97 to /CAM_GPIO0 on J_CSI pin 18 [CAM_CLK] with R54=10k C25744 pull-down to /GND and protected at J_CSI by dedicated ultra-low-capacitance 0.65pF unidirectional 3.3V ESD diode D40 PESD3V3U1UA,115 C403915 with D34 PESD3V3L5UY pin 3 tied to /GND, and U1 pin 100 [RP1 GPIO35 with on-module 15k pull-up to always-on /+3V3] routed on /CAM_GPIO1_CM5 through BSS138 N-MOSFET pass switch Q_CAM C52895 [Drain on /CAM_GPIO1_CM5, Gate on /+3V3_PER, Source on /CAM_GPIO1] to /CAM_GPIO1 on J_CSI pin 17 [CAM_SHUTDOWN] with R95=10k C25744 pull-up to /+3V3_PER and R96=100k C25741 off-state bleeder to /GND so J_CSI.17 has 0.0uA back-drive when /+3V3_PER=0V), with Pin 22 powered from dedicated soft-started 3.3V 2A synchronous buck regulator U_3V3 (TLV62569DBVR, C141836, L4=2.2uH TMPC0402HP-2R2MG-Z02 C357134, R47=45.3k/R48=10k, enabled on /3V3_PER_EN from /+5V_PER via R45=100k C25741 / R46=100k C25741 divider [V_EN=2.50V > 1.2V V_IH] with U1.38 GPIO11 left unconnected) on /+3V3_PER (also supplying protected off-board FFC rails J_TP.2 and J_AUDR.8 with local 100nF decoupling C97/C38 and 3.3V ESD TVS clamps D31/D32 PESD3V3U1UA,115 C403915) with local 10uF+100nF decoupling at J_DSI.22 (C45, C46) and J_CSI.22 (C47, C48)
- refs:
  - J_KB
  role: keyboard_fpc_24p
  mpn: 05A20L24P
  lcsc: C5362158
  footprint: lcsc:FPC-SMD_24P-P0.50_05A20L24P
  description: 24-pin 0.5mm pitch right-angle FPC connector for scissor keyboard tail (with 4x PESD3V3L5UY C2831531 5-channel 3.3V SOT-363 ESD arrays D25..D28 clamping all 18 matrix lines /KB_ROW0..7 and /KB_COL0..9 on pins 1..18, unidirectional 5.0V ESD diode D9 PESD5V0S1UA,115 C179414 on /PWR_BUT at pin 19 preventing negative ESD from forward-biasing ultra-low-leakage small-signal switching diode D16 [1N4148WS C2128, Anode on /CM5_PWR_BUT U1.92, Cathode on /PWR_BUT, I_R <= 25nA] waking CM5 (with U_CHG.12 ~QON left unconnected so long >=10s power-button presses never trigger unintended BQ25798 HIZ power reset), and pin 20 tied to /GND alongside pins 21..24 so raw CM5 /+3V3 is never routed onto the keyboard FPC)
- refs:
  - J_USBL
  role: usb_left_ffc_16p
  mpn: 05B20U16P
  lcsc: C18164516
  footprint: lcsc:FPC-SMD_16P-P0.50_05B20U16P
  description: '16-pin 0.5mm pitch right-angle top-contact FFC connector (Pad 1 at North y=18.25mm, Pad 16 at South y=25.75mm, contacts facing +Z) mating 1-to-1 across Type-B (opposite-side / reversed-contact) 16-pin 0.5mm FFC ribbon c_usb_left with usb_left bottom-contact J3 (FPC-05F-16PH20 C2856801, Pad 1 at North y=13.75mm, Pad 16 at South y=21.25mm, contacts facing -Z) carrying 90-ohm controlled-impedance USB 2.0 differential pairs (/USB3-0-D_P/N pins 10/11 and /USB3-1-D_P/N pins 13/14, protected by ultra-low-capacitance 0.35pF USB 2.0 ESD arrays U_ESD1 and U_ESD2 [2x USBLC6-2SC6, C2687116, with Pin 5 VBUS isolated onto dedicated local 100nF 50V 0402 capacitors C90 (/ESD1_VBUS) and C91 (/ESD2_VBUS) C307331 to /GND per ST USBLC6-2SC6 Figure 4 ("USB 2.0 protection without VBUS available") so the central Zener rail clamp protects D+/D- without clamping USB signals or back-powering /+5V_PER when off]), ground shielding (pins 5, 6, 9, 12, 15, 16, 17, 18), and CMOS-threshold-compliant cross-domain-isolated 3.3V status/control signals via R16..R21=1k 1% 0402 (0402WGF1001TCE C11702, V_OL <= 0.16V << 0.8V V_IL(max) against 50k pull-up, V_OH >= 2.71V > 2.0V V_IH(min) against 50k pull-down, 0.0uA off-state back-powering): Pin 1 /USBL_PD_PG_N driven via R16=1k C11702 from non-inverting 2-stage open-drain 2N7002 buffer Q3+Q6 (Q3 Gate on U1.10 /PD_PG_N with R5=10k C25744 to /PD_VDD_3V3, Q3 Drain /PD_PG_INV with R24=100k C25741 to /PD_VDD_3V3 driving Q6 Gate, Q6 Drain /PD_PG_ISO pulled up to main-board-derived /J1_VDD_3V3 via R25=10k C25744), Pin 2 /USBL_U3_FLT_N driven via R17=1k C11702 from non-inverting 2-stage open-drain 2N7002 buffer Q5+Q7 (Q5 Gate on U3.9 /U3_FLT_N with R6=10k C25744 to /PD_VDD_3V3 so /U3_FLT_N stays at 3.30V >> 2.5V V_GS(th,max) of Q4 with 0uA main-board loading during dead-battery startup, Q5 Drain /U3_FLT_INV with R23=100k C25741 to /PD_VDD_3V3 driving Q7 Gate, Q7 Drain /U3_FLT_ISO pulled up to /J1_VDD_3V3 via R26=10k C25744), Pin 3 /USBL_U5_FLT_N from U5.9 ~FLT via R18=1k C11702 (with R7=10k to /J1_VDD_3V3) to U1.24 GPIO26, Pin 4 /USBL_J1_FAULT_N from U2.1 ~FAULT via R19=1k C11702 (with R9=10k to /J1_VDD_3V3) to U1.30 GPIO6, Pin 7 /USBL_J1_UFP_N from U2.19 ~UFP via R20=1k C11702 (with R10=10k to /J1_VDD_3V3) to U1.41 GPIO25 (all five active-low status/fault lines /USBL_PD_PG_N, /USBL_U3_FLT_N, /USBL_U5_FLT_N, /USBL_J1_FAULT_N, /USBL_J1_UFP_N pulled up to main-board /+3V3 via R75..R79=10k 1% 0402 C25744), and Pin 8 /USBL_J1_EN (from CM5 U1.111 VBUS_EN, gating main-board U_VBUS pin 4 EN with main-board R8=100k 1% C25741 pull-down to /GND, and protected alongside pins 1..4, 7 by 2x PESD3V3L5UY C2831531 3.3V SOT-363 ESD arrays D29 and D30) via R21=1k C11702 to U2.6 EN (pulled up to 3.3V /J1_VDD_3V3 via R8=100k C25741 so V_J1_EN = 0.033V < 0.4V = V_IL(max) when driven low), while high-current rails flow exclusively over 1.0mm pitch wire-to-board headers J4 (SM06B-SRSS-TB(LF)(SN), C160405: +5V_USBC pins 1..3 [3.0A rating], GND pins 4..6) and J5 (SM10B-SRSS-TB(LF)(SN), C160409: VBUS_PD pins 1..5 [5.0A rating > 2.25A hardware-capped 45W PD startup current and 3.25A max 65W PD current, switched from J2_VBUS by adjacent back-to-back AO4407A P-MOSFETs Q1/Q2 on usb_left enabled by Q4 from /U3_FLT_N across 5V-20V], GND pins 6..10)'
- refs:
  - J_TP
  - J_AUDR
  role: ffc_8p
  mpn: FPC-05F-8PH20
  lcsc: C2856797
  footprint: lcsc:FPC-SMD_8P-P0.50_FPC-05F-8PH20
  description: 8-pin 0.5mm pitch right-angle FFC/FPC connector for trackpad (J_TP pin 2 powered from switched/current-limited /+3V3_PER buck rail U_3V3, locally decoupled by C97=100nF C307331 and clamped by 3.3V ESD TVS diode D31 PESD3V3U1UA,115 C403915, with F2..F5 PTC fuses removed so J_DSI.22, J_CSI.22 [with C47=10uF, C48=100nF], J_TP.2, and J_AUDR.8 connect directly to low-impedance /+3V3_PER; pin 3 /TP_SDA and pin 4 /TP_SCL isolated from /I2C_SDA and /I2C_SCL via BSS138 N-MOSFET pass switches Q_TP2 and Q_TP1 [2x BSS138 C52895, Gates on /+3V3_PER] with R83=2.2k and R82=2.2k 1% 0402 [0402WGF2201TCE C25879] pull-ups to /+3V3_PER and protected by ultra-low-capacitance 0.65pF 3.3V ESD diodes D22 and D23 [2x PESD3V3U1UA,115 C403915], and pin 5 /TP_INT_N and pin 6 /TP_RST_N pulled up to /+3V3_PER via R18=10k and R19=10k C25744 and protected by unidirectional 3.3V ESD diodes D20 and D21 [2x PESD3V3U1UA,115 C403915]) and audio_right daughterboard (J_AUDR pin 8 powered from switched/current-limited /+3V3_PER buck rail U_3V3, locally decoupled by C38=100nF C307331 and clamped by 3.3V ESD TVS diode D32 PESD3V3U1UA,115 C403915, with R61=10R/R62=10R C25077 headphone isolation resistors, symmetrical R51=47k/R52=47k C25792 DC bleeders to /GND on /MIC_P and /MIC_N, PESD5V0S1BA C2827694 ESD clamps D10..D13 on AC-coupled /HP_L, /HP_R, /MIC_P, /MIC_N, and unidirectional 3.3V ESD diode D14 PESD3V3U1UA,115 C403915 on 3.3V GPIO /HP_DET at J_AUDR; pin 7 routed to dedicated /HP_DET on CM5 GPIO24 U1 pin 45 with R37=10k pull-up)
- refs:
  - J_BL
  - J_SPKL
  - J_SPKR
  role: jst_ph_2p
  mpn: S2B-PH-SM4-TB(LF)(SN)
  lcsc: C295747
  footprint: lcsc:CONN-SMD_P2.00_S2B-PH-SM4-TB-LF-SN
  description: 2-pin 2.0mm pitch right-angle wire-to-board connector (S2B-PH-SM4-TB(LF)(SN), C295747) for display WLED backlight (J_BL) and left/right stereo speakers (J_SPKL, J_SPKR, EMI-filtered by FB1..FB4 BLM18PG121SN1D C14709 + C60..C63 1nF C1523)
- refs:
  - U_HALL
  role: hall_lid_sensor
  mpn: DRV5032FADBZR
  lcsc: C140921
  footprint: lcsc:SOT-23-3_L2.9-W1.3-P0.95-LS2.4-BR
  description: Ultra-low-power omnipolar Hall-effect switch detecting lid closure magnet on dedicated /LID_SNS to CM5 GPIO13 (U1 pin 28)
- refs:
  - SW1
  role: rpiboot_switch
  mpn: PTS526SM15SMTR2LFS
  lcsc: C2689538
  footprint: lcsc:SW-SMD_4P-L5.2-W5.2-P3.70-LS6.4
  description: Top-actuated SMD tactile button on top side of main board for internal CM5 nRPIBOOT recovery flashing mode
purchased:
- id: cm5_module
  description: Raspberry Pi Compute Module 5 (BCM2712 quad-core Cortex-A76, 8GB LPDDR4X, 64GB eMMC, Wi-Fi/BLE)
  mpn: SC1598
  url: https://www.raspberrypi.com/products/compute-module-5/
  datasheet: https://datasheets.raspberrypi.com/cm5/cm5-datasheet.pdf
  dims_mm:
  - 55.3
  - 40.3
  - 4.92
  position_mm:
  - 52.35
  - -42.15
  - 1.62
  connects_to: pcba
  dims_source: Raspberry Pi Compute Module 5 mechanical drawing and rea-hw ref cm5 model (55.3 x 40.3 x 4.92 mm)
  model: case/purchased/cm5_module.stl
  color: '#2b6f3e'
- id: keyboard_module
  description: 78-key ANSI ultra-thin scissor-switch laptop keyboard module with printed legends and 24-pin 0.5mm FPC tail
  mpn: KB-78-ANSI-SCISSOR-270X104
  url: https://www.alibaba.com/product-detail/Laptop-Scissor-Switch-Keyboard-Module_1600592841102.html
  dims_mm:
  - 270.0
  - 104.0
  - 1.8
  position_mm:
  - -55.0
  - -104.0
  - 6.8
  connects_to: pcba
  dims_source: 'Standard 13-inch 78-key ANSI scissor-switch module mechanical drawing: 270.0 x 104.0 mm outline, 1.0 mm aluminum backplate + 0.8 mm keycap travel height, 6 rows on 19.05 x 18.0 mm pitch (row 0 function keys 15.5 x 8.5 mm, alpha keys 16.5 x 15.5 mm, spacebar 92.0 x 15.5 mm), 6 perimeter M1.6 mounting tabs, 24-pin 0.5mm pitch FPC tail exiting at [98.0, 56.0, 0.2] mm in module coords (world [43.0, -48.0, 7.0] mm)'
  model: case/purchased/keyboard_module.stl
  decor: case/purchased/keyboard_module_legends.stl
  decor_color: '#2b2b2b'
  color: '#f2f1ed'
  connectors:
  - id: KB_FPC
    at_mm:
    - 98.0
    - 56.0
    - 0.2
    pins: 24
    pitch_mm: 0.5
    kind: fpc
    mouth:
    - 0.0
    - 1.0
    - 0.0
    long_axis:
    - 1.0
    - 0.0
    - 0.0
- id: trackpad_module
  description: Capacitive multi-touch glass-surface I2C laptop trackpad module with 8-pin 0.5mm FPC tail
  mpn: TP-I2C-120X76-GLASS
  url: https://www.azoteq.com/products/proxsense/trackpads/
  dims_mm:
  - 120.0
  - 76.0
  - 2.0
  position_mm:
  - 20.0
  - -186.0
  - 6.4
  connects_to: pcba
  dims_source: 'Azoteq IQS572 / 13-inch laptop glass trackpad mechanical drawing: 120.0 x 76.0 x 2.0 mm (0.8 mm glass + 1.2 mm sensor PCB), 8-pin 0.5mm FPC tail centered at rear edge [60.0, 75.0, 0.5] mm in module coords (world [80.0, -111.0, 6.9] mm)'
  model: case/purchased/trackpad_module.stl
  color: '#dcdad3'
  connectors:
  - id: TP_FPC
    at_mm:
    - 60.0
    - 75.0
    - 0.5
    pins: 8
    pitch_mm: 0.5
    kind: fpc
    mouth:
    - 0.0
    - 1.0
    - 0.0
    long_axis:
    - 1.0
    - 0.0
    - 0.0
- id: display_panel
  description: 13.0-inch 2560x1600 4-lane MIPI DSI IPS thin LCD panel with integrated WLED backlight bar
  mpn: LP130WQ1-MIPI-22P
  url: https://www.panelook.com/modeldetail.php?id=51842
  dims_mm:
  - 284.0
  - 178.0
  - 1.5
  position_mm:
  - -62.0
  - -178.0
  - 8.9
  connects_to: pcba
  dims_source: '13.0-inch 16:10 thinoxide IPS panel mechanical drawing: 284.0 x 178.0 x 1.5 mm outline, 22-pin 0.5mm MIPI DSI connector at rear-left [86.0, 176.0, 0.5] mm and 2-pin backlight header at [104.0, 176.0, 0.5] mm in module coords'
  model: case/purchased/display_panel.stl
  color: '#14181e'
  connectors:
  - id: DSI_IN
    at_mm:
    - 86.0
    - 176.0
    - 0.5
    pins: 22
    pitch_mm: 0.5
    kind: ffc
    mouth:
    - 0.0
    - 1.0
    - 0.0
    long_axis:
    - 1.0
    - 0.0
    - 0.0
  - id: BL_IN
    at_mm:
    - 104.0
    - 176.0
    - 0.5
    pins: 2
    pitch_mm: 2.0
    kind: harness
- id: webcam_module
  description: Slim 1080p MIPI CSI-2 camera module with 22-pin 0.5mm micro-coax receptacle for laptop top bezel
  mpn: CAM-OV5647-SLIM-28X6
  url: https://www.arducam.com/product/arducam-ov5647-mini-camera-module/
  dims_mm:
  - 28.0
  - 6.5
  - 1.5
  position_mm:
  - 66.0
  - -187.5
  - 8.9
  connects_to: pcba
  dims_source: 'Slim laptop bezel MIPI CSI camera module drawing: 28.0 x 6.5 x 1.5 mm outline, lens at center, 22-pin 0.5mm micro-coax/FFC connector at right end [26.0, 3.25, 0.5] mm in module coords'
  model: case/purchased/webcam_module.stl
  color: '#1c2026'
  connectors:
  - id: CSI_OUT
    at_mm:
    - 26.0
    - 3.25
    - 0.5
    pins: 22
    pitch_mm: 0.5
    kind: coax
- id: battery_pack
  description: 'Custom 2S2P 7.4V nominal (6.0-8.4V) 9000mAh / 66.6Wh Li-Po laptop battery pack built from four identical LP4466104 pouch cells (4x 3.7V 4500mAh, 104.0 x 66.0 x 4.4 mm each) joined by the pack maker with one integrated 2S protection and cell-balancing board (PCM with internal mid-point balance lead), 10k NTC thermistor, and one 9-pin JST-PH 2.0mm harness connector (S9B-PH-SM4-TB(LF)(SN) C495694: 4x VBAT+, 1x TS NTC, 4x GND for balanced 8.0A supply/return), contoured around and under the trackpad'
  mpn: LP4466104-2S2P-9000MAH
  url: https://www.lipolbattery.com/LiPo-Battery-4500mAh+.html
  dims_mm:
  - 280.0
  - 138.0
  - 4.4
  position_mm:
  - -60.0
  - -187.0
  - 0.0
  connects_to: pcba
  dims_source: 'Custom 2S2P laptop pack mechanical drawing using 4 identical LP4466104 pouch cells (104.0 x 66.0 x 4.4 mm each): rear-left cell at X=[-60.0..44.0], Y=[-115.0..-49.0], Z=[0.0..4.4]; rear-right cell at X=[116.0..220.0], Y=[-115.0..-49.0], Z=[0.0..4.4]; front-left cell (around/under trackpad, clearing speaker_left) at X=[-25.0..79.0], Y=[-187.0..-121.0], Z=[0.0..4.4]; front-right cell (around/under trackpad, clearing speaker_right) at X=[81.0..185.0], Y=[-187.0..-121.0], Z=[0.0..4.4]; joined into one watertight solid by central 2S protection/balance PCB housing at X=[43.0..117.0], Y=[-65.0..-49.0], Z=[0.0..3.0] and inter-cell tab bridges at X=[20.0..40.0]/X=[120.0..140.0], Y=[-122.0..-114.0], Z=[0.0..3.0] and X=[77.0..83.0], Y=[-160.0..-140.0], Z=[0.0..3.0]; overall pack envelope 280.0 x 138.0 x 4.4 mm with 8-pin JST-PH 2.0mm harness exiting at world [24.5, -49.0, 2.2] mm'
  model: case/purchased/battery_pack.stl
  color: '#1e1e22'
  connectors:
  - id: BAT_PACK_LEAD
    at_mm:
    - 24.5
    - -49.0
    - 2.2
    pins: 8
    pitch_mm: 2.0
    kind: harness
- id: speaker_left
  description: Low-profile 8-ohm 2W rectangular laptop speaker box module (left channel)
  mpn: SPK-LAPTOP-36X68X4
  url: https://www.puiaudio.com/products/speakers
  dims_mm:
  - 36.0
  - 68.0
  - 4.2
  position_mm:
  - -64.0
  - -187.0
  - 0.0
  connects_to: pcba
  dims_source: 'Laptop acoustic box speaker mechanical drawing: 36.0 x 68.0 x 4.2 mm ABS enclosure with 2-pin wire lead at rear-right corner [34.0, 67.0, 2.1] mm'
  model: case/purchased/speaker_left.stl
  color: '#222428'
  connectors:
  - id: SPKL_LEAD
    at_mm:
    - 34.0
    - 67.0
    - 2.1
    pins: 2
    pitch_mm: 2.0
    kind: harness
- id: speaker_right
  description: Low-profile 8-ohm 2W rectangular laptop speaker box module (right channel)
  mpn: SPK-LAPTOP-36X68X4
  url: https://www.puiaudio.com/products/speakers
  dims_mm:
  - 36.0
  - 68.0
  - 4.2
  position_mm:
  - 188.0
  - -187.0
  - 0.0
  connects_to: pcba
  dims_source: 'Laptop acoustic box speaker mechanical drawing: 36.0 x 68.0 x 4.2 mm ABS enclosure with 2-pin wire lead at rear-left corner [2.0, 67.0, 2.1] mm'
  model: case/purchased/speaker_right.stl
  color: '#222428'
  connectors:
  - id: SPKR_LEAD
    at_mm:
    - 2.0
    - 67.0
    - 2.1
    pins: 2
    pitch_mm: 2.0
    kind: harness
- id: hinge_left
  description: Compact friction torque laptop hinge (left)
  mpn: HG-TORQUE-L-24X10
  url: https://www.southco.com/en_us_int/hinges/positioning-hinges
  dims_mm:
  - 24.0
  - 8.0
  - 5.0
  position_mm:
  - -48.0
  - 2.0
  - 4.0
  dims_source: 'Southco / laptop friction torque hinge drawing: 24.0 mm width x 8.0 mm depth x 5.0 mm barrel height, pivot axis at Y=8.5 mm, Z=8.6 mm'
  model: case/purchased/hinge_left.stl
  color: '#8a8f96'
- id: hinge_right
  description: Compact friction torque laptop hinge (right)
  mpn: HG-TORQUE-R-24X10
  url: https://www.southco.com/en_us_int/hinges/positioning-hinges
  dims_mm:
  - 24.0
  - 8.0
  - 5.0
  position_mm:
  - 184.0
  - 2.0
  - 4.0
  dims_source: 'Southco / laptop friction torque hinge drawing: 24.0 mm width x 8.0 mm depth x 5.0 mm barrel height, pivot axis at Y=8.5 mm, Z=8.6 mm'
  model: case/purchased/hinge_right.stl
  color: '#8a8f96'
enclosure:
  process: cnc
  wall_mm: 1.2
  clearance_floor_mm: 0.15
  parts:
  - id: top_deck
    file: case/out/top_deck.stl
    role: shell
    process: cnc
    material: 6061-T6 aluminum
    finish: bead-blast + silver-gold anodize
    color: '#d6d4be'
    description: Unibody palmrest and keyboard deck with perimeter port cutouts and rear hinge/cable channel
  - id: bottom_shell
    file: case/out/bottom_shell.stl
    role: shell
    process: cnc
    material: 6061-T6 aluminum
    finish: bead-blast + silver-gold anodize
    color: '#d6d4be'
    description: Continuous CNC aluminum bottom enclosure pan with no through-cutouts under usb_left and no bottom service slot
  - id: lid_shell
    file: case/out/lid_shell.stl
    role: shell
    process: cnc
    material: 6061-T6 aluminum
    finish: bead-blast + silver-gold anodize
    color: '#d6d4be'
    description: Continuous thin CNC aluminum display lid back shell with blind internal pocket for lid_magnet and no hole through the outer skin
  - id: display_bezel
    file: case/out/display_bezel.stl
    role: window
    process: mjf
    material: PA12 nylon / polycarbonate
    finish: matte black
    color: '#181a1f'
    description: Front display bezel framing the 13-inch LCD panel and top webcam window, with enclosed hinge barrel and internal cable channels concealing all lid flexes/coax
  - id: lid_magnet
    file: case/out/lid_magnet.stl
    role: button
    process: cnc
    material: NdFeB N52 magnet
    finish: bead-blast + silver-gold anodize
    color: '#d6d4be'
    description: Lid closure magnet seated in a blind pocket inside the right side of the lid (with no hole through lid_shell outer skin) aligned with Hall sensor U_HALL on pcba
assembly:
- part: top_deck
  travel_mm: 0
  held_by: base
  note: Place inverted aluminum top deck on fixture as inside-out build base
- part: keyboard_module
  direction:
  - 0
  - 0
  - -1
  travel_mm: 20
  may_touch:
  - top_deck
  held_by: captured
  note: Install 78-key scissor keyboard module into top_deck well from inside
- part: trackpad_module
  direction:
  - 0
  - 0
  - -1
  travel_mm: 20
  may_touch:
  - top_deck
  held_by: captured
  note: Seat capacitive glass trackpad module into palmrest opening from inside
- part: hinge_left
  direction:
  - 0
  - 0
  - -1
  travel_mm: 20
  may_touch:
  - top_deck
  held_by: captured
  note: Mount left torque hinge into rear-left deck pocket
- part: hinge_right
  direction:
  - 0
  - 0
  - -1
  travel_mm: 20
  may_touch:
  - top_deck
  held_by: captured
  note: Mount right torque hinge into rear-right deck pocket
- part: cm5_module
  direction:
  - 0
  - 0
  - 1
  travel_mm: 20
  may_touch:
  - top_deck
  held_by: captured
  note: Seat Compute Module 5 into rear bay from below before main carrier board
- part: pcba
  direction:
  - 0
  - 0
  - 1
  travel_mm: 25
  may_touch:
  - top_deck
  - cm5_module
  held_by: captured
  note: Seat main CM5 carrier board into rear-center bay from below onto CM5 connectors
- part: pcba:usb_left
  direction:
  - 0
  - 0
  - 1
  travel_mm: 25
  may_touch:
  - top_deck
  held_by: captured
  note: Seat left dual USB-C daughterboard (top-side assembly only) behind left-edge port cutouts
- part: pcba:audio_right
  direction:
  - 0
  - 0
  - 1
  travel_mm: 25
  may_touch:
  - top_deck
  held_by: captured
  note: Seat right headphone and microphone daughterboard behind right-edge port cutout
- part: speaker_left
  direction:
  - 0
  - 0
  - 1
  travel_mm: 25
  may_touch:
  - top_deck
  held_by: captured
  note: Install left speaker box in front-left corner
- part: speaker_right
  direction:
  - 0
  - 0
  - 1
  travel_mm: 25
  may_touch:
  - top_deck
  held_by: captured
  note: Install right speaker box in front-right corner
- part: battery_pack
  direction:
  - 0
  - 0
  - 1
  travel_mm: 25
  may_touch:
  - top_deck
  - keyboard_module
  - trackpad_module
  held_by: captured
  note: Install 2S2P 7.4V 9000mAh (66.6Wh) Li-Po battery pack (four identical LP4466104 cells joined with 2S PCM, balance lead, NTC, and single J_BAT connector) contoured around and under the trackpad
- part: bottom_shell
  direction:
  - 0
  - 0
  - 1
  travel_mm: 25
  may_touch:
  - top_deck
  - pcba
  - pcba:usb_left
  - pcba:audio_right
  - battery_pack
  - speaker_left
  - speaker_right
  held_by: press_fit
  held_with:
  - top_deck
  note: Close lower base with continuous CNC aluminum bottom pan
- part: display_bezel
  direction:
  - 0
  - 0
  - -1
  travel_mm: 25
  may_touch:
  - top_deck
  - hinge_left
  - hinge_right
  held_by: captured
  note: Position display bezel frame on torque hinges above top deck
- part: display_panel
  direction:
  - 0
  - 0
  - -1
  travel_mm: 20
  may_touch:
  - display_bezel
  held_by: captured
  note: Seat 13-inch MIPI DSI LCD panel into display bezel
- part: webcam_module
  direction:
  - 0
  - 0
  - -1
  travel_mm: 20
  may_touch:
  - display_bezel
  held_by: captured
  note: Seat 1080p MIPI CSI webcam module into top bezel cavity
- part: lid_magnet
  direction:
  - 0
  - 0
  - -1
  travel_mm: 20
  may_touch:
  - display_bezel
  - display_panel
  held_by: captured
  note: Seat lid closure magnet into blind pocket on rear of display_panel/display_bezel
- part: lid_shell
  direction:
  - 0
  - 0
  - -1
  travel_mm: 25
  may_touch:
  - display_bezel
  - display_panel
  - webcam_module
  - lid_magnet
  - hinge_left
  - hinge_right
  held_by: press_fit
  held_with:
  - display_bezel
  note: Close lid assembly with continuous CNC aluminum lid shell (capturing lid_magnet in blind pocket with no exterior hole)
articulations:
- id: lid_hinge
  parts:
  - lid_shell
  - display_bezel
  - display_panel
  - webcam_module
  - lid_magnet
  hinge_parts:
  - hinge_left
  - hinge_right
  pivot_mm:
  - 80.0
  - 8.5
  - 8.6
  axis:
  - -1
  - 0
  - 0
  open_deg: 110.0
  note: Clamshell lid rotates 110 degrees open around rear hinge axis [-1,0,0] by right-hand rule
cables:
- id: c_usb_left
  kind: ffc
  a:
    part: pcba
    connector: J_USBL
  b:
    part: pcba:usb_left
    connector: J3
  pins: 16
  pitch_mm: 0.5
  length_mm: 45.0
  width_mm: 8.5
  route:
  - at_mm:
    - -2.0
    - -22.0
    - 2.5
  - at_mm:
    - -16.0
    - -22.0
    - 2.5
  - at_mm:
    - -29.0
    - -22.0
    - 2.5
  note: '16-pin 0.5mm Type-B (opposite-side / reversed-contact) FFC ribbon connecting main board top-contact J_USBL (05B20U16P C18164516, Pad 1 at North y=18.25mm, Pad 16 at South y=25.75mm, contacts facing +Z) 1-to-1 to left USB-C daughterboard bottom-contact J3 (FPC-05F-16PH20 C2856801, Pad 1 at North y=13.75mm, Pad 16 at South y=21.25mm, contacts facing -Z; carrying 90-ohm USB3-0-D_P/N pins 10/11, USB3-1-D_P/N pins 13/14, GND shield pins 5/6/9/12/15/16, and CMOS-threshold-compliant cross-domain-isolated 3.3V status/control signals via R16..R21=1k 1% 0402 C11702 [V_OL <= 0.16V << 0.8V V_IL(max), V_OH >= 2.71V > 2.0V V_IH(min), 0.0uA off-state back-powering]: Pin 1 /USBL_PD_PG_N from U1.10 PG via non-inverting 2-stage 2N7002 open-drain buffer Q3+Q6 [R5=10k, R24=100k to /PD_VDD_3V3; R25=10k to /J1_VDD_3V3; R16=1k], Pin 2 /USBL_U3_FLT_N from U3.9 ~FLT via non-inverting 2-stage 2N7002 open-drain buffer Q5+Q7 [R6=10k, R23=100k to /PD_VDD_3V3; R26=10k to /J1_VDD_3V3; R17=1k], Pin 3 /USBL_U5_FLT_N via R18=1k [R7=10k to /J1_VDD_3V3], Pin 4 /USBL_J1_FAULT_N via R19=1k [R9=10k to /J1_VDD_3V3], Pin 7 /USBL_J1_UFP_N via R20=1k [R10=10k to /J1_VDD_3V3], and Pin 8 /USBL_J1_EN via R21=1k with R8=100k C25741 pulled up to 3.3V /J1_VDD_3V3 so V_J1_EN = 0.033V < 0.4V V_IL(max) when driven low, while zero /VBUS_PD or /+5V_USBC current flows through the 0.5mm FFC), and high-current power is carried exclusively over 1.0mm pitch wire-to-board harnesses J4<->J4 (SM06B-SRSS-TB(LF)(SN) C160405: +5V_USBC pins 1..3 [3.0A rating, switched from /+5V_PER (6A U_BUCK2) onto dedicated /+5V_USBC by U_VBUS SY6280AAC with fixed R31=3.6k 0402WGF3601TCE C25891 setting I_LIM=1.89A typ <= 2.0A continuous rating and EN on /USBL_J1_EN driven from CM5 VBUS_EN U1.111 (/CM5_VBUS_EN) via R91=10k C25744 with R8=100k C25741 pull-down to /GND and shed below V_THROT_FALL=7.160V typ / 7.060V min [V_THROT_RISE=7.582V typ / 7.487V min, 422mV hysteresis via co-located R88=80.6k C25798 / R89=4.7k C25900 + R97=100k C25741 / Q6 BSS138 C52895 on U_UVLO INB-] by Q5 BSS138 C52895 [Gate on U_UVLO OUTB /VBUS_ISET_HI pulled up to /+3V3 via R90=47k 0402WGF4702TCE C25792] so 2S battery discharge current stays <= 5.35A <= 6.0A BQ25798RQMR BATFET rating], GND pins 4..6) and J5<->J5 (SM10B-SRSS-TB(LF)(SN) C160409: 5V-20V VBUS_PD pins 1..5 [5.0A rating > 2.25A hardware-capped 45W PD startup current and 3.25A max 65W PD current], GND pins 6..10)'
- id: c_audio_right
  kind: ffc
  a:
    part: pcba
    connector: J_AUDR
  b:
    part: pcba:audio_right
    connector: J2
  pins: 8
  pitch_mm: 0.5
  length_mm: 45.0
  width_mm: 4.5
  route:
  - at_mm:
    - 162.0
    - -22.0
    - 2.5
  - at_mm:
    - 176.0
    - -22.0
    - 2.5
  - at_mm:
    - 189.0
    - -22.0
    - 2.5
  note: '8-pin 0.5mm Type-B (opposite-side / reversed-contact) FFC ribbon connecting main board bottom-contact J_AUDR (FPC-05F-8PH20 C2856797, Pad 1 at South y=23.75mm, Pad 8 at North y=20.25mm, contacts facing -Z) 1-to-1 to right audio daughterboard top-contact J2 (FPC-05FB-8PH20 C2856828, Pad 1 at South y=19.75mm, Pad 8 at North y=16.25mm, contacts facing +Z; carrying HP_L, HP_R, balanced differential MIC_P/MIC_N with symmetrical main-board DC charge bleeders R51=47k C25792 and R52=47k C25792 to /GND ahead of C33/C34=2.2uF (while U_CODEC pin 25 /CODEC_MICBIAS is decoupled by C51=4.7uF) and AC-coupled on audio_right by C13/C14=2.2uF + R8/R9=100R from TS5A23159DGSR U4 (with J1.1 /HS_MIC_DET biased from /+2V8_ANA via R11=470R + C11=10uF + R1=2.2k and AC-coupled by C10=2.2uF into R21=220R, Kelvin-routed C20=2.2uF on J1.2 Ring 2 into R29=1.3k, and matched ultra-low-leakage BAV99,215 C2500 dual-series silicon rail-to-rail clamps D8 on /HS_MIC_MUX, D9 on /HS_REF_MUX, and D11 on /DET_IN), unidirectional 3.3V PESD3V3U1UA,115 C403915 ESD clamps D3 on J1.1 /HS_MIC_DET, D10 on /TIP_SW, and D12 on /+2V8_ANA, LP5907MFX-2.8/NOPB C186700 2.8V LDO U5 with local 1uF input cap C22 C52923 within 1.5mm of U5.1/U5.2 and R24=1.3k C25866 preload bleeder supplying /+2V8_ANA, active-low J1 PJ-3701-SMT C2684645 isolated mechanical Tip plug-detect switch /TIP_SW via U1 TLV7041DBVR on pin 7 routed to dedicated main-board net /HP_DET on CM5 GPIO24 U1 pin 45 with R37=10k pull-up, +3V3, GND)'
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
- id: c_speaker_right
  kind: harness
  a:
    part: pcba
    connector: J_SPKR
  b:
    part: speaker_right
    connector: SPKR_LEAD
  pins: 2
  pitch_mm: 2.0
  length_mm: 195.0
  route:
  - at_mm:
    - 148.0
    - -46.5
    - 2.5
  - at_mm:
    - 222.0
    - -46.5
    - 2.5
  - at_mm:
    - 222.0
    - -117.0
    - 2.5
  - at_mm:
    - 190.0
    - -117.0
    - 2.1
  note: Right speaker 195 mm 2-wire lead routed around right side of battery_pack into J_SPKR, EMI-filtered on main board by FB3/FB4 (BLM18PG121SN1D 120R@100MHz 2A C14709) and C62/C63 (1nF 50V X7R 0402 C1523)
actuators:
- id: A_LID_HALL
  feature: F_HALL
  case_part: lid_magnet
  target:
    part: pcba
    ref: U_HALL
  kind: magnetic
  element_axis:
  - 0
  - 0
  - 1
  range_mm: 8.0
  source: 'TI DRV5032FADBZR datasheet: SOT-23 omnipolar Hall-effect switch sensitive perpendicular to package top (+Z), +-4.8 mT threshold (~8 mm range with N52 magnet)'
requirements:
- id: R1
  text: Thin aluminum laptop matching reference dimensions (297.5 x 206.4 x 12.7 mm)
  how_met: CNC 6061-T6 aluminum top_deck, continuous bottom_shell, and continuous lid_shell totaling 297.5 x 206.4 x 12.7 mm closed
  quantity: 297.5 x 206.4 x 12.7 mm
- id: R2
  text: Raspberry Pi Compute Module 5 brain with real 3D model from rea-hw ref cm5
  how_met: rea_refs:ComputeModule5-CM5 footprint on main carrier PCB with real CM5_module.stl model
  quantity: 1x CM5 module (55.3 x 40.3 x 4.92 mm)
- id: R3
  text: 2 USB-C ports on left edge (front-left 45-65W 20V PD charging + data; rear-left data + 5V out) and 1 headphone jack on right edge
  how_met: 'usb_left 4-layer 1.6mm daughterboard (single-sided top assembly so bottom_shell is continuous with no through-cutouts, with continuous In1.Cu/In2.Cu/B.Cu GND reference planes and USB_Diff_90 netclass routing /USB3-0-D_P/N and /USB3-1-D_P/N as tightly coupled 90-ohm differential pairs length-matched within <0.2mm skew) with 2x TYPE-C-31-M-12 (J2 with autonomous CH224A PD 3.0 sink controller U1 strapped for 20V PD negotiation via single-resistor R11=120k 1% C25750 on CFG1 to GND with CFG2/CFG3 open per CH224 Section 5.2.1 [20V @ 2.25A = 45.0W hardware-capped at startup via R29=78.7k/R30=100k for 45-65W adapters], R3=0R 0603 jumper C21189 connecting /J2_VBUS directly to /PD_VHV [U1.1 VHV and U1.8 VBUS tied together on /PD_VHV decoupled by C5=1uF 50V C15849], C12=1uF+C13=100nF=1.1uF <=4.7uF unswitched cSnkPwr on J2_VBUS, adjacent back-to-back common-source AO4407A P-MOSFET load switch Q1/Q2 C2841482 [Q1 Drain on /J2_VBUS, Q1/Q2 common Source on continuous F.Cu polygon pour /PD_SW_MID, Q2 Drain on /VBUS_PD] enabled in hardware by 2N7002 Q4 C8545 [Gate on /PD_EN pulled up from /U3_FLT_N via R15=47k 1% 0402 C25792 where /U3_FLT_N has R6=10k pull-up to /PD_VDD_3V3 and drives only the insulated gate of 2-stage 2N7002 open-drain buffer Q5+Q7 so V(/U3_FLT_N)=3.30V >> 2.5V V_GS(th,max) of Q4 with 0.0uA main-board loading] so Q1/Q2 turns ON autonomously across 5V-20V whenever U3 detects no CC OVP fault, enabling dead-battery startup on both 20V PD and <20V [5V/9V/12V/15V] USB-C adapters via main-board BQ25798RQMR U_CHG hardware VINDPM [4.3V floor at 5V, V_VBUS0-1.4V at 12V-20V] and hardware ILIM_HIZ=2.25A (R29=78.7k C2998104 / R30=100k C25741, V_ILIM_HIZ=2.80V) while immediately delivering VBUS attachment telemetry on /VBUS_PD [U_CHG /CHG_INT_N and 16-bit VBUS_ADC] plus active-low 20V PD Power Good telemetry on J3.1 /USBL_PD_PG_N via non-inverting 2-stage 2N7002 open-drain buffer Q3+Q6 [Q3 Gate on U1.10 /PD_PG_N with R5=10k to /PD_VDD_3V3, Q3 Drain /PD_PG_INV with R24=100k to /PD_VDD_3V3 driving Q6 Gate, Q6 Drain /PD_PG_ISO with R25=10k to /J1_VDD_3V3 and R16=1k to J3.1], with R13=10k 0603 C25804 pull-up from common-source /PD_SW_MID to Q4 Drain /PD_DRV_D [R13 <= R14] + dedicated series gate resistor R14=10k 0603 C25804 between /PD_DRV_D and /PD_SW_G [reducing U3 CC OVP fault turn-off bleed path to R13+R14=20k so |V_GS| drops below 1.7V in ~45us with tau_off=84.8us] + D9=BZT52C12 C173429 12V gate clamp across common-source /PD_SW_MID and /PD_SW_G [holding V_GS1=V_GS2=0V when Q4 is OFF regardless of polarity for true bidirectional blocking, providing full supply voltage |V_GS|=5.00V at 5V with zero DC divider when Q4 is ON, and clamping |V_GS|=12.0V at 20V] + Miller soft-start capacitor C17=10nF 50V X7R 0402 C15195 on /VBUS_PD in series with blocking diode D10=1N4148WS C2128 [Anode on /PD_MILLER C17.2, Cathode on /PD_SW_G] and diode-isolated pre-charge network R22=1k 1% 0402 C11702 + D11=1N4148WS C2128 [Anode on /PD_PRECHG from /PD_DRV_D via R22=1k, Cathode on /PD_MILLER, pre-charging C17 to V(/PD_SW_MID) with fast tau=(R13+R22)*C17=0.11ms and 3*tau=0.33ms < 0.50ms during 5V-to-20V PD ramps while Q4 is OFF, then immediately reverse-biasing D11 when Q4 pulls /PD_DRV_D to 0V so zero DC current enters /PD_SW_G and 100% of C17 Miller current flows through D10 and R14=10k] isolating downstream VBUS_PD bulk capacitance C15=10uF 50V 0805 GRM21BR61H106KE43L C440198 + C16=100nF, TPD6S300RUKR 24V CC OVP & USB 2.0 ESD protector U3 protecting J2_CC1/CC2 [via C_CC1/C_CC2] and J2 USB 2.0 D+/D- directly on /USB3-0-D_P/N with shunt ESD clamping on U3.20 D1 and U3.19 D2 [C_SBU1/C_SBU2/SBU1/SBU2 unused] and VPWR powered strictly from J2_VBUS via D3=1N4148WS C2128 + R12=470R 0603 C23179 + C6=1uF 50V C15849 + D8=BZT52C24 24V Zener clamp C173422 + U4 XC6216B332MR-G C2891269, and ESTVS2200DRVR C42400188 22V-standoff / 28.6V-max flat-clamping surge TVS D6/D7 on /J2_VBUS and /VBUS_PD; J1 with TPS25810RVCR 5V DFP controller U2 [supplied on dedicated switched net /+5V_USBC from 6A U_BUCK2 (/+5V_PER) via main-board U_VBUS SY6280AAC with fixed R31=3.6k 0402WGF3601TCE C25891 setting I_LIM=1.89A typ <= 2.0A continuous rating and EN on /USBL_J1_EN driven from CM5 VBUS_EN U1.111 (/CM5_VBUS_EN) via R91=10k C25744 with R8=100k C25741 pull-down to /GND and shed below V_THROT_FALL=7.160V typ / 7.060V min [V_THROT_RISE=7.582V typ / 7.487V min, 422mV hysteresis via co-located R88=80.6k C25798 / R89=4.7k C25900 + R97=100k C25741 / Q6 BSS138 C52895 on U_UVLO INB-] by Q5 BSS138 C52895 [Gate on U_UVLO OUTB /VBUS_ISET_HI pulled up to /+3V3 via R90=47k 0402WGF4702TCE C25792] so 2S battery discharge current stays <= 5.35A <= 6.0A BQ25798RQMR BATFET rating, U2.7 CHG tied to /+5V_USBC AUX and U2.8 CHG_HI=GND advertising 1.5A USB Type-C current with 1.55A min / 1.70A typ / 1.85A max integrated 37mOhm switch acting as the sole current-limiting element for J1, U2.6 EN pulled up to 3.3V /J1_VDD_3V3 via R8=100k C25741 and routed via R21=1k C11702 to J3.8 /USBL_J1_EN so V_J1_EN = 3.3V * 1k / 101k = 0.033V < 0.4V = V_IL(max) when driven low, C1=150uF 10V 55mOhm polymer tantalum T520C157M010ATE055 C600588 + C19=10uF 50V 0805 GRM21BR61H106KE43L C440198 + C2=100nF C307331 = 160.1uF >= 120uF cSrcPwr bulk reservoir on U2.IN /+5V_USBC, and only C3=10uF 50V X5R 0805 GRM21BR61H106KE43L C440198 + C4=100nF C307331 = 10.1uF on switched U2.OUT /J1_VBUS with C18 removed so U2 500 ohm active discharge reaches vSafe0V <= 0.8V in ~9.3ms typ / 13.7ms max << 650ms tVBUSOFF] + TPD6S300RUKR U5 powered from dedicated 3.3V LDO U6 XC6206P332MR-G C5446 on +5V_USBC + TSD05CDYFR C20611048 5.5V TVS D4/D5 on /J1_VBUS and /+5V_USBC + RP1 USB3-1 D+/D-), bottom-contact 16P 0.5mm FFC J3 (FPC-05F-16PH20 C2856801, Pad 1 at North y=13.75mm, Pad 16 at South y=21.25mm, contacts facing -Z, with 2-stage 2N7002 open-drain buffers Q3+Q6 and Q5+Q7 on pins 1..2 and R16..R21=1k C11702 across pins 1..4 and 7..8) mating 1-to-1 via Type-B (opposite-side / reversed-contact) 16P 0.5mm FFC c_usb_left with main-board top-contact J_USBL (05B20U16P C18164516, contacts facing +Z), and 1.0mm high-current harnesses J4/J5 feeding BQ25798RQMR 5A 2S buck-boost NVDC charger on main board; audio_right daughterboard with PJ-3701-SMT (C2684645) 6-pin 3.5mm CTIA TRRS jack J1 featuring an isolated NC mechanical Tip plug-detect switch (Pin 5 /TIP_SW and Pin 6 /GND, with R30=22k C25768 pull-up to /+2V8_ANA, C23=2.2uF C159814 48.4ms deglitch filter, and D10 PESD3V3U1UA,115 C403915 ESD clamp driving U1 TLV7041DBVR with R23=22k/R31=1M 72mV hysteresis for Sleeve-independent /HP_DET on J2.7 and driving U2 TLV7041DBVR IN- on /HP_DET_N against IN+ on /V_REF_HI=2.344V to gate /MIC_SEL synchronously with debounced Tip insertion), protected on J1.1 /HS_MIC_DET by unidirectional 3.3V ESD diode D3 (PESD3V3U1UA,115 C403915 matching D10), top-contact 8P FFC J2 (FPC-05FB-8PH20 C2856828) mating 1-to-1 via Type-B (opposite-side contact) 8P 0.5mm FFC c_audio_right with main-board bottom-contact J_AUDR (FPC-05F-8PH20 C2856797), LP5907MFX-2.8/NOPB 2.8V ultra-low-noise LDO U5 (C186700, >=335mV worst-case headroom from +3V3 +/-5%) decoupled within 1.5mm of U5.1/U5.2 by local 1uF input cap C22 (C52923) and 1uF output cap C21 (C52923) with R24=1.3k (C25866) minimum preload bleeder (2.58mA total sink preventing rail back-drive) and D12 (PESD3V3U1UA,115 C403915) shunt clamp on /+2V8_ANA, ICS-40720 differential MEMS mic MK1, TLV7041DBVR comparators U1..U3 (R13=2.2k/R14=10k/R16=1.3k reference ladder, non-loading R12=47k C25792 + C12=4.7nF C1538 sense filter with BAV99,215 C2500 rail-to-rail clamp D11 on /DET_IN, R17=2.2k pull-up, and U3 with R27=2.2k C25879 / R28=1M C26083 hysteresis so 3-pole TRS plugs with R_sleeve<100 ohm deterministically hold/reset /MIC_SEL=0V onto MK1 while 4-pole CTIA headsets including open inline mute switches drive /MIC_SEL=3.3V onto external headset mic), and TS5A23159DGSR dual SPDT mic mux U4 with R18=68k/R19=27k 0.795V /MUX_BIAS_FILT, Kelvin-routed C20=2.2uF on J1.2 Ring 2, balanced R21=220R/R29=1.3k headset mic network, and matched ultra-low-leakage BAV99,215 (C2500) dual-series silicon rail-to-rail clamps D8 (on /HS_MIC_MUX) and D9 (on /HS_REF_MUX) to /GND and /+3V3'
  quantity: 2x USB-C left (20V 45-65W PD + 5V DFP), 1x 3.5mm jack right
- id: R4
  text: Bought scissor-switch laptop keyboard module with readable legends and FPC tail, plus large multi-touch trackpad
  how_met: 270x104mm 78-key ANSI scissor keyboard with keyboard_module_legends.stl and 24P FPC to TCA8418RTWR; 120x76mm I2C glass trackpad with 8P FPC
  quantity: 78 keys with legends, 120x76mm trackpad
- id: R5
  text: Re-arrange battery as 2S2P (7.4V nominal, 6.0-8.4V) filling >=70% of base floor around and under trackpad as one bought pack (four identical cells joined by pack maker with one 2S protection board, balance lead, NTC, and one connector)
  how_met: 'Single bought 2S2P Li-Po laptop battery pack (battery_pack, LP4466104-2S2P-9000MAH, 7.4V nominal, 6.0-8.4V, 9,000mAh / 66.6Wh) built from four identical LP4466104 pouch cells (104.0 x 66.0 x 4.4 mm each) contoured around and under trackpad_module (covering >85% of free floor) and joined by the pack maker with an integrated 2S protection/balance board (PCM with mid-point balance lead), 10k NTC thermistor, and one 9-pin JST-PH 2.0mm harness connecting to J_BAT (S9B-PH-SM4-TB(LF)(SN) C495694: pins 1..4 VBAT+ [8.0A rating] on /VBAT_PACK protected by 8A 1206 fuse F1 JFC1206-1800FS C136353 into /VBAT with R50=100R C25076 Kelvin sense on fused /VBAT, pin 5 TS NTC sense on /CHG_TS protected by unidirectional 5.0V ESD diode D19 PESD5V0S1UA,115 C179414, pins 6..9 + tabs 10..11 GND [8.0A continuous return rating], with unmated J_BAT2 removed) on the main board'
  quantity: 1x 2S2P pack (4 identical LP4466104 cells, 7.4V 9,000mAh / 66.6Wh)
- id: R6
  text: CM5 boot recovery via internal pads and top-side recovery switch with continuous bottom pan (no service slot and no through-cutouts under usb_left)
  how_met: Co-located internal top-side pogo-pin service test pads TP1..TP6 at X=109.2..115.8mm, Y=31.0..37.0mm (TP1 /DBG_PWR at [111.8, 31.0], TP2 /USB2_P at [113.2, 35.0], TP3 /USB2_N at [115.8, 35.0], TP4 /GND at [110.5, 34.0], TP5 /PMIC_EN at [110.5, 37.0] protected by unidirectional 5.0V ESD diode D6 PESD5V0S1UA,115 C179414, TP6 /nRPIBOOT at [109.2, 31.0] protected by unidirectional 3.3V ESD diode D5 PESD3V3U1UA,115 C403915; USB2_P/N protected by USBLC6-2SC6 U_ESD with Pin 5 VBUS isolated onto dedicated local capacitor C95=100nF 50V 0402 C307331 (/ESD_VBUS) to /GND per ST USBLC6-2SC6 Figure 4 without back-powering /+5V_CM5, DBG_PWR decoupled by USB 2.0 compliant C88=4.7uF 16V 0603 C19666 [<=10uF limit] via TPS2117DRLR U_DBG with VIN1 pin 3 and MODE pin 5 tied to /GND, Secondary input VIN2 pin 6 tied to /DBG_PWR, PR1 pin 4 on /DBG_PR1 driven from /BUCK_PG via R58=10k C25744 / R7=30k C25776 divider with C100=220nF 16V X7R 0402 CL05B224KO5NNNC C16772 RC delay filter to /GND [tau = (20k||30k)*220nF = 2.64ms >= 1ms, delaying V(/DBG_PR1) crossing 1.0V V_REF by 1.07ms so U_DBG stays conducting across the ~300-500us Q1/Q2 Miller soft-start ramp until /+5V_CM5 rises above /DBG_PWR for zero-brownout switchover, and then holding U_DBG in Hi-Z shutdown when /BUCK_PG is high and enabling VIN2=/DBG_PWR when /+5V is off], and ST pin 8 open, in parallel with back-to-back common-source blocking AO4407A P-MOSFETs Q1/Q2 gated on /DBG_GATE by 2N7002 Q_DBG C8545 [Gate on /BUCK_PG, Drain on /DBG_EN_D] via R84=1k C11702 series gate resistor with R59=10k C25744 pull-up to common source /DBG_Q_SRC [|V_GS|=4.66V > 4.50V, tau_off=41.2us] and diode-isolated Miller soft-start network C98=10nF C15195 + D39=1N4148WS C2128 + R94=22k C25768 on /DBG_MILLER) and top-side nRPIBOOT recovery switch SW1 (PTS526SM15SMTR2LFS) on main board, keeping bottom_shell 100% continuous with no service slot and no through-cutouts under usb_left
  quantity: 6 internal test pads + 1 internal top-side boot switch
- id: R7
  text: Articulated lid on real torque hinges (110 deg open) with blind magnet pocket (no hole through lid outer skin) and all cables routed inside body and hinge barrel
  how_met: hinge_left and hinge_right at pivot [80, 8.5, 8.6] mm; lid_magnet seated in blind pocket inside lid_shell/display_bezel with continuous lid_shell outer skin; c_display_dsi, c_display_bl, and micro-coax c_webcam_csi routed at constant X through enclosed hinge barrel and internal bezel channels without looping outside the rear edge or poking through the bezel
  quantity: 2 hinges, 110 deg open, 9 internal cables
decisions:
- question: Power tree and 2S 45-65W USB-C PD charging architecture?
  choice: 'Autonomous CH224A PD 3.0 sink controller U1 on 4-layer 1.6mm usb_left (C42459160, strapped for 20V PD request via single-resistor R11=120k 1% C25750 on CFG1 to GND with CFG2/CFG3 left open per CH224 Section 5.2.1, powered from unswitched J2_VBUS [C12=1uF + C13=100nF = 1.1uF <= 4.7uF cSnkPwr, clamped by ESTVS2200DRVR C42400188 22V flat-clamping TVS D6] via R3=0R 0603 jumper C21189 to /PD_VHV [with U1.1 VHV and U1.8 VBUS tied directly together on /PD_VHV and decoupled by C5=1uF 50V C15849], with adjacent back-to-back common-source AO4407A P-MOSFET load switch Q1/Q2 C2841482 [Q1 Drain on /J2_VBUS, Q1/Q2 common Source on /PD_SW_MID, Q2 Drain on /VBUS_PD] enabled in hardware by 2N7002 Q4 C8545 [Gate on /PD_EN pulled up from /U3_FLT_N via R15=47k 1% 0402 C25792 where /U3_FLT_N has R6=10k pull-up to /PD_VDD_3V3 and drives only the insulated gate of 2-stage 2N7002 open-drain buffer Q5+Q7 so V(/U3_FLT_N)=3.30V >> 2.5V V_GS(th,max) of Q4 with 0.0uA main-board loading] so Q1/Q2 turns ON autonomously across 5V-20V whenever U3 has no CC OVP fault, enabling dead-battery startup on both 20V PD and <20V [5V/9V/12V/15V] USB-C adapters via main-board BQ25798RQMR U_CHG hardware VINDPM [4.3V floor at 5V, V_VBUS0-1.4V at 12V-20V] and hardware ILIM_HIZ=2.25A (R29=78.7k C2998104 / R30=100k C25741, V_ILIM_HIZ=2.80V) while immediately delivering VBUS attachment telemetry on /VBUS_PD [U_CHG /CHG_INT_N and 16-bit VBUS_ADC] plus active-low 20V PD Power Good telemetry on J3.1 /USBL_PD_PG_N via non-inverting 2-stage 2N7002 open-drain buffer Q3+Q6 [Q3 Gate on U1.10 /PD_PG_N with R5=10k to /PD_VDD_3V3, Q3 Drain /PD_PG_INV with R24=100k to /PD_VDD_3V3 driving Q6 Gate, Q6 Drain /PD_PG_ISO with R25=10k to /J1_VDD_3V3 and R16=1k to J3.1], + R13=10k 0603 C25804 pull-up from common-source /PD_SW_MID to /PD_DRV_D [R13 <= R14] + dedicated series gate resistor R14=10k 0603 C25804 between /PD_DRV_D and /PD_SW_G [reducing U3 CC OVP fault turn-off bleed path to R13+R14=20k so |V_GS| drops below 1.7V in ~45us with tau_off=84.8us] + D9=BZT52C12 C173429 12V gate clamp across common-source /PD_SW_MID and /PD_SW_G [holding V_GS1=V_GS2=0V when Q4 is OFF regardless of polarity, providing full supply voltage |V_GS|=5.00V at 5V with zero DC divider when Q4 is ON, and clamping |V_GS|=12.0V at 20V] + Miller soft-start capacitor C17=10nF 50V X7R 0402 C15195 on /VBUS_PD in series with blocking diode D10=1N4148WS C2128 [Anode on /PD_MILLER C17.2, Cathode on /PD_SW_G] and diode-isolated pre-charge network R22=1k 1% 0402 C11702 + D11=1N4148WS C2128 [Anode on /PD_PRECHG from /PD_DRV_D via R22=1k, Cathode on /PD_MILLER, pre-charging C17 to V(/PD_SW_MID) with fast tau=(R13+R22)*C17=0.11ms and 3*tau=0.33ms < 0.50ms during 5V-to-20V PD ramps while Q4 is OFF, then immediately reverse-biasing D11 when Q4 pulls /PD_DRV_D to 0V so zero DC current enters /PD_SW_G and 100% of C17 Miller current flows through D10 and R14=10k] to isolate downstream VBUS_PD bulk capacitance C15=10uF 50V 0805 GRM21BR61H106KE43L C440198 + C16=100nF + ESTVS2200DRVR C42400188 22V TVS D7, with U4 XC6216B332MR-G C2891269 and U3.10 TPD6S300RUKR VPWR powered from J2_VBUS via D3=1N4148WS C2128 + R12=470R 0603 C23179 + C6=1uF 50V C15849 + D8=BZT52C24 24V Zener clamp C173422, J2 USB 2.0 D+/D- connected directly to /USB3-0-D_P/N with shunt ESD clamping on U3.20 D1 and U3.19 D2 [C_SBU1/C_SBU2/SBU1/SBU2 unused], U5.10 powered from dedicated U6 XC6206P332MR-G C5446 on +5V_USBC clamped by TSD05CDYFR C20611048 D4/D5, and CMOS-threshold-compliant status/control lines R16..R21=1k C11702 routing /USBL_PD_PG_N, /USBL_U3_FLT_N, /USBL_U5_FLT_N, /USBL_J1_FAULT_N, /USBL_J1_UFP_N, /USBL_J1_EN across Type-B opposite-side contact 16P 0.5mm FFC c_usb_left on J3 pins 1..4 and 7..8 with R8=100k C25741 pulling /J1_EN up to 3.3V /J1_VDD_3V3 so V_J1_EN = 0.033V < 0.4V V_IL(max) when driven low) -> 10-pin 1.0mm harness J5 (SM10B-SRSS-TB(LF)(SN) C160409: 5x VBUS_PD + 5x GND = 5.0A rating > 2.25A hardware-capped 45W PD startup current and 3.25A max 65W PD current, with /VBUS_PD and /+5V_USBC removed from 0.5mm FFC J_USBL) -> BQ25798RQMR I2C 5A 1S-4S buck-boost battery charger & NVDC power-path manager U_CHG (C2876593, 3.6-24V input, 26V VBUS_OVP, with VAC1 pin 9 (/CHG_VAC1, locally decoupled by C96=100nF 50V C307331 to /GND) via R74=10R C25077 low-drop series resistor to /VBUS_PD (with D+/D- pins 6/7 shorted on /CHG_DP_DM) protected by low-clamping 22V-standoff / 27.7V-clamping surge TVS D7 TVS2200DRVR C2875234 and switched into VBUS/VAC2 pins 2/3/8 /CHG_VBUS via external back-to-back 40V N-MOSFETs Q3/Q4 [2x SQ2318AES-T1_BE3 C2847989, gates on /CHG_ACDRV1_G and common sources on /CHG_AC_SRC] driven by ACDRV1 pin 11 (/CHG_ACDRV1) via series gate resistor R69=100R C25076 with 12V Zener clamp D15=BZT52C12 C173429, and gate capacitor C89=470pF 50V C1537 between /CHG_ACDRV1_G and /CHG_AC_SRC, R_PROG=8.2k 1% C25981 setting 2S cell count [8.40V VREG, 7.0V VSYSMIN] and 750kHz switching frequency with L1=2.2uH 10A inductor FXL0630-2R2-M C167218 between SW1/SW2 and 47nF bootstrap caps on BTST1/BTST2, ILIM_HIZ divider R29=78.7k 1% C2998104 / R30=100k 1% C25741 from REGN setting V_ILIM_HIZ=2.80V [I_INDPM=2.25A -> 45.0W hardware input limit at 20V so 45W PD adapters never trip OCP during DCP startup with standalone CH224A U1, supplemented by NVDC battery supplement mode and I2C REG0x14 EN_EXTILIM=0 for 60-65W adapters], ~QON pin 12 left unconnected (held high by internal ~200k pull-up to V_PULL per BQ25798 Section 8.3.9.2 with SFET_PRESENT=0) so long >=10s presses on J_KB pin 19 (/PWR_BUT, isolated to CM5 /CM5_PWR_BUT U1 pin 92 via D16 1N4148WS C2128) never trigger unintended BQ25798 10s System Power Reset / HIZ mode, R50=100R C25076 Kelvin battery voltage sense on BATP pin 18 from fused /VBAT side of 8A fuse F1, and R23=5.23k C11631 / R42=30.1k C29402 JEITA NTC divider from REGN on TS pin 16 to J_BAT pin 5 clamped by unidirectional 5.0V ESD diode D19 PESD5V0S1UA,115 C179414) -> single 9-pin JST-PH battery pack connector J_BAT (S9B-PH-SM4-TB(LF)(SN) C495694: pins 1..4 VBAT+ [8.0A] on /VBAT_PACK via 8A fuse F1 JFC1206-1800FS C136353 to /VBAT, pin 5 TS NTC, pins 6..9 + tabs 10..11 GND [8.0A continuous return], with unmated J_BAT2 removed) connected to the 2S2P 7.4V 9,000mAh / 66.6Wh battery_pack (4 identical LP4466104 cells with integrated 2S protection/balance board) -> dual 6A synchronous buck converters U_BUCK and U_BUCK2 (2x TPS56628DDAR C485522, 12A total 5V capacity from 2S NVDC /VSYS [6.5-8.6V], with U_BUCK EN pin 1 on /BUCK_EN driven by precision voltage supervisor U_UVLO (TPS3700DDCR C33002 with R33=82k C4142 / R34=5.1k C25905 sense divider, R81=1M hysteresis, C93=100nF, R67=100k/R68=47k 5.5V-safe pull-up divider setting V_UVLO_RISE=6.866V and V_UVLO_FALL=6.610V, and Channel B co-located R88=80.6k C25798 / R89=4.7k C25900 + R97=100k C25741 / Q6 BSS138 C52895 on INB- pin 4 /VSYS_THROT [V_THROT_FALL=7.160V typ / 7.060V min, V_THROT_RISE=7.582V typ / 7.487V min, 422mV hysteresis] driving OUTB pin 6 /VBUS_ISET_HI), L2/L5=2.2uH FXL0630-2R2-M C167218, feedback dividers R27/R28=137k/24k (5.13V on /+5V) and R64/R65=133k/24k (5.00V on /+5V_PER), 5.5V TVS D3 TSD05CDYFR C20611048 on /+5V, and unidirectional 5.0V low-clamping TVS diodes D18 and D2 PSD05-LF-T7 C139296 on /+5V_PER and /+5V_USBC): U_BUCK supplies /+5V (5.00V, 6A) for CM5 +5V_CM5 (via back-to-back common-source blocking AO4407A P-MOSFETs Q1/Q2 gated on /DBG_GATE by 2N7002 Q_DBG C8545 [Gate on /BUCK_PG, Drain on /DBG_EN_D] via R84=1k C11702 series gate resistor with R59=10k C25744 tied to common source /DBG_Q_SRC and diode-isolated Miller soft-start network C98=10nF C15195 + D39=1N4148WS C2128 + R94=22k C25768 on /DBG_MILLER + TPS2117DRLR U_DBG with VIN1 pin 3 and MODE pin 5 on /GND, VIN2 pin 6 on TP1 /DBG_PWR [decoupled by C88=4.7uF 0603 C19666], PR1 pin 4 on /DBG_PR1 driven from /BUCK_PG via R58=10k/R7=30k with C100=220nF C16772 RC delay filter [tau=2.64ms >= 1ms] so U_DBG stays conducting for 1.07ms across Q1/Q2 Miller soft-start before entering Hi-Z shutdown when /BUCK_PG is high and enables TP1 /DBG_PWR when /+5V is off, and ST pin 8 open, reserving U_BUCK exclusively for the 5.0A peak CM5 load with 16.7% headroom), U_BUCK2 (EN pin 1 gated by CM5 switched /+3V3 so /+5V_PER and /+3V3_PER shut down when CM5 halts) supplies /+5V_PER (5.00V, 6A, 2.43A-2.78A peak load for >53% headroom) for PAM8406DR Class-D amp U_AMP, TLV62569DBVR +3.3V_PER buck U_3V3 (EN pin 1 /3V3_PER_EN driven from /+5V_PER via R45=100k/R46=100k divider, supplying J_DSI.22, J_CSI.22, J_TP.2 [with C97=100nF + D31 PESD3V3U1UA,115], and J_AUDR.8 [with C38=100nF + D32 PESD3V3U1UA,115]), and U_VBUS (SY6280AAC, IN on /+5V_PER decoupled by C18=100nF, OUT switching dedicated /+5V_USBC to J4 pins 1..3, fixed R31=3.6k 0402WGF3601TCE C25891 setting I_LIM=1.89A typ <= 2.0A continuous rating, and EN on /USBL_J1_EN driven by CM5 VBUS_EN U1.111 [/CM5_VBUS_EN] via R91=10k C25744 with R8=100k C25741 pull-down to /GND and shed below V_THROT_FALL=7.160V typ / 7.060V min [V_THROT_RISE=7.582V typ / 7.487V min, 422mV hysteresis via co-located R88=80.6k C25798 / R89=4.7k C25900 + R97=100k C25741 / Q6 BSS138 C52895 on U_UVLO INB-] by Q5 BSS138 C52895 [Gate on U_UVLO OUTB /VBUS_ISET_HI pulled up to /+3V3 via R90=47k 0402WGF4702TCE C25792] so 2S battery discharge current stays <= 5.35A <= 6.0A BQ25798RQMR BATFET rating so usb_left U2 TPS25810RVCR [U2.7 CHG=/+5V_USBC AUX, U2.8 CHG_HI=GND advertising 1.5A Type-C current, 1.55A min / 1.70A typ / 1.85A max integrated 37mOhm switch limit] coordinates selectively below U_VBUS, with C1=150uF+C19=10uF+C2=100nF=160.1uF >=120uF cSrcPwr on U2.IN /+5V_USBC and only C3=10uF 50V 0805 + C4=100nF = 10.1uF on switched U2.OUT /J1_VBUS [C18 removed] for ~9.3ms typ / 13.7ms max vSafe0V active discharge), TPS61165DBVR backlight boost U_BL is powered directly from 2S /VSYS via high-side P-MOSFET switch Q_BL (AO3401A C15127) on /VSYS_BL, and HT7530S 30V-input 3.0V RTC LDO U_RTC (C347214) runs on 2S /VBAT via low-leakage silicon switching diode D37 (1N4148WS C2128, I_R <= 25nA) onto /RTC_VIN (locally decoupled directly at U_RTC pin 3 VIN by C57=1uF 50V 0603 C15849).'
  reason: Moving from 1S to 2S2P (7.4V nominal, 6.0-8.4V) cuts battery and charger/converter currents in half for the same power (~3.0-4.8A instead of 11-13A), eliminates the dual-AO4407A battery bypass stage (Q_BAT1/Q_BAT2) and the 4 separate cell connectors/fuses/ballast resistors, allows direct 20V USB-C PD charging at 45-65W through BQ25798RQMR with a single autonomous CH224A 20V PD sink (eliminating FUSB302BMPX and the discrete 13V OVP circuit on usb_left), and replaces the 5V boost converter with a high-efficiency 6A synchronous buck converter (TPS56628DDAR) from 2S VSYS (6.0-8.6V).
- question: Mechanical enclosure continuity (bottom pan, lid magnet pocket, and hinge cable routing)?
  choice: '1) bottom_shell is a continuous CNC 6061-T6 aluminum pan (Z=-1.10..-0.02 mm) with no bottom service slot (F_FLASH removed; SW1 and co-located pogo-pin cluster TP1..TP6 moved to top side of main board) and no through-cutouts under usb_left (all usb_left components placed on top side F.Cu). 2) lid_magnet sits in a blind internal pocket inside the lid (Z=9.35..10.38 mm between display_panel/display_bezel and lid_shell continuous inner ceiling Z=10.42 mm) with F_HALL.view=any and zero hole through lid_shell outer skin. 3) c_display_dsi, c_display_bl, and c_webcam_csi (kind=coax, 1.13 mm micro-coax bundle) cross the hinge at constant X (24.0, 42.0, 136.0 mm) inside the enclosed hinge barrel and internal display_bezel channels without any axial X-jog that would loop outside the rear edge or poke through the bezel.'
  reason: Directly fulfills owner mechanical requirements for a continuous bottom pan, blind lid magnet pocket with unperforated lid outer skin, and clean internal flex/coax routing inside the body and hinge barrel.
- question: 78-key ANSI scissor-switch keyboard layout and matrix?
  choice: '6-row 78-key ANSI layout (19.05mm horizontal x 18.0mm vertical pitch, 1.2mm scissor travel) scanned by TCA8418RTWR 8x10 matrix (ROW0..7 x COL0..9): Row 0 (14 half-height keys: ESC, F1..F12, LOCK/PWR), Row 1 (14 keys: ~, 1..0, -, =, DELETE), Row 2 (14 keys: TAB, Q..P, [, ], \), Row 3 (13 keys: CAPS, A..L, ;, '', RETURN), Row 4 (12 keys: LSHIFT, Z..M, ,, ., /, RSHIFT), Row 5 (11 keys: FN, CTRL, LOPT, LCMD, SPACE, RCMD, ROPT, LEFT, UP, DOWN, RIGHT).'
  reason: Matches every key visible in teardown_exploded.jpg (#1..#76) and fits within TCA8418RTWR's 80-key (8x10) I2C matrix capacity over the 24-pin FPC tail.
