CopperPilot/laptop/(commit log)

2026-11-02 CopperPilot Laptop: design, reviews, build film and reference
    Designed by CopperPilot (run i12, pipeline v68-v97, gates re-run on v98).
    [battery_pack.stl, bottom_shell.step, bottom_shell.stl, cm5_module.stl, display_bezel.stl, display_panel.stl, hinge_left.stl, hinge_right.stl]
2026-11-06 Every review P0 and P1 fixed: 0 open on all three boards; new stills and build film
    The main board, the left USB-C board and the right audio board each have 0 P0 and 0 P1 open in their latest design
    review (all gates pass, judge 8/10). Stills and the build film are re-rendered, the design files, fab outputs and
    reviews are re-exported, and the README's pending list is updated.
    [bottom_shell.step, cm5_module.stl, lid_magnet.step, lid_shell.step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]
2026-11-08 Build film and renders re-rendered: parts back out along their assembly direction, checked frame by frame
    The exploded view now moves every part opposite the direction it was fitted, so nothing passes through
    anything (the rear shell used to fly up through the stack). Every frame is replayed against the 3D models
    and a separate critic watches the film (reviews/film.md).
2026-11-08 Film review from a critic that saw only this film's frames
